XJH-Jorhai/automatic-curtain-lifter/hardware/mechanical/README.md

# 机械结构与打印

## 交付文件

| 文件 | 用途 |
|---|---|
| [盖子.STEP](盖子.STEP) | 盖子独立结构件 |
| [架子.STEP](架子.STEP) | 架子独立结构件 |
| [壳子.STEP](壳子.STEP) | 壳子独立结构件 |
| [enclosure.3mf](enclosure.3mf) | Bambu Studio 打印工程，包含零件、打印盘及示例配置 |

三个 STEP 由作者从 SolidWorks 2025 导出，格式为 AP214。原装配体存在严重引用丢失，因此本版采用独立结构件 STEP 与 3MF 交付，不提供完整参数化 SolidWorks 装配、配合关系或特征树。读者需要自行定位和装配；不能据此声称原装配已修复。

STEP 保持原始字节，未修改几何。已检查文件结束标记、实体编号及引用完整性，作者/组织字段为空，未检出邮箱、本机路径或已知私人标识。已用 Open CASCADE 8.0.1 独立导入并执行 BRepCheck，三个结构件均为有效实体且体积为正；装配配合和干涉未验证。详细结果见 [几何检查](geometry-check.json)。

## 已实际使用的打印参数

| 项目 | 作者样机配置 |
|---|---|
| 打印机 | Bambu Lab X1 Carbon |
| 喷嘴 | 0.4 mm |
| 材料 | Polymaker PLA Pro，黑色 |
| 层高 | 0.2 mm |
| 壁圈数 | 2 圈（不是 2 mm 壁厚） |
| 电机/外壳固定 | M2.5 / M3 普通碳钢或不锈钢螺钉 |
| 安装位置与固定 | 用纳米胶粘贴在窗框和墙面 |

螺钉按实际装配自行选配，不提供固定长度与逐位置采购清单；根据连接处厚度和可用螺纹深度选择，避免顶到底或干涉运动件。装配关系参照提供的结构件和 3MF，本版不另提供装配图或逐步装配说明。填充与支撑可从打印工程检查并按设备调整。上述粘贴方式是作者样机做法，胶带型号、接触面积及长期承载尚未量化验证。

3MF 来自作者确认的“零件5^main.3mf”。已清除设计者账户编号，仅保留 XJH-Jorhai 署名；除设计者元数据外，归档各成员、几何、组件变换与打印配置保持不变。原文件含 PLA/PETG/ABS 多种耗材配置，这不代表都已实测。打开后以本页实际参数核对并调整各零件耗材、层高、壁圈数及支撑，再按自己的设备重新切片。

珠链轮的 OpenSCAD 源码及上游许可见相邻参数化珠链轮目录。原创结构件的许可范围见 [LICENSING.md](../../LICENSING.md)。
