XJH-Jorhai/automatic-curtain-lifter/hardware/schematic-review/README.md

# Curtain Lifter 主板首版原理图审阅

2026-10-13 新增独立[调试板 TPS61023 升压电路记录](debug-board-tps61023.md)：在工程中的 `调试板 / Schematic3 / P1` 补齐 3.3V→5V 的电感、反馈与滤波外围，输出 `5V_DEBUG` 留给后续调试器接口。该记录与下方主板四页网表分开。

2026-10-11 当前复核：用户已移除 PA1 12 V 电压检测，使用 U6 双向复位钮子开关与独立 SW1 配网键，并将调试/扩展接口改成 GH1.25。本轮将 CN1.8 从重复 GND 改为 `TUYA_CEN`，供涂鸦烧录复位。以[当前 V3 网表](Curtain_Lifter_Mainboard_v3.enet)及主控页当前截图（历史附件未随公开候选提供）为准；`*_TRQonly.png` 与 `*_TRQonly_v3.epro` 是历史快照。

[原理图设计连续问答](design-qa.md)保存解释方法、用户问题、版本证据及待验证项。2026-10-09 用户已从 V3 电源输入页移除防反接 MOS 及外围，并更换 DC 插座；U4 已从 FRAM 改为 EEPROM。以下旧版图片仅用于查看之前的布线布局，器件和网表以当前 V3 工程及[最新网表](Curtain_Lifter_Mainboard_v3.enet)为准。

开始 PCB 绘制前的逐页 DRC、网表及布局注意项见[2026-10-11 投板前审查](pre-pcb-review-2026-10-11.md)。

V3 工程 `涂鸦智能家居产品-窗帘开关`（UUID `d8963714934544559fd468e3e2743100`）中主板为 `Curtain_Lifter_Mainboard_RevA`，原理图为 `Curtain_Lifter_Mainboard`，现有四页；原有 `Board1` 保留。下方 `*_TRQonly.png` 图片是 2026-10-10 从当时 V3 桌面窗口抓取的历史图面；电气连接以 V3 工程及[最新网表](Curtain_Lifter_Mainboard_v3.enet)为准。按用户决定移除了新增的第五页 HX711/应变桥电路。

此前的原生 V3 工程快照（历史附件未随公开候选提供）已导出，包含当时四页主板原理图和工程中原有的 `Board1`。本次改动请以打开中的 V3 工程、[当前网表](Curtain_Lifter_Mainboard_v3.enet)和当日主控页截图（历史附件未随公开候选提供）为准。

本轮按实体导线重画了局部辅助电路。可与改线前的电源页（历史附件未随公开候选提供）、驱动页（历史附件未随公开候选提供）、主控页（历史附件未随公开候选提供）、本地操作页（历史附件未随公开候选提供）逐页对比。布局参考 [TI DRV8434A 应用电路](https://www.ti.com/lit/ds/symlink/drv8434a.pdf)与 [ST STM32G0 硬件设计说明](https://www.st.com/resource/en/application_note/dm00443870-getting-started-with-stm32g0-series-hardware-development-stmicroelectronics.pdf)。

编辑器中的红色导线来自“已选中”高亮，并无特殊电气含义。本版已清除遗留选中状态；以下截图中的导线统一为默认绿色，器件引脚与轮廓沿用库符号的红色。将按键上拉、MCU 复位上拉和驱动器下拉改为器件旁的短电源或地接线，并将适合横排的网络名调整为横排。

## 01 电源输入

!当前 V3：12 V 输入、保护和 3.3 V 降压（历史附件未随公开候选提供）

当前 V3 使用 DC1 [`DC-050-A250`](https://jlcpcb.com/partdetail/XUNPU-DC_050A250/C41429013)（讯普，C41429013，SMD 卧贴）；内径 2.5 mm、外径 6.4 mm，[原厂图纸](https://item.szlcsc.com/datasheet/DC-050-A250/43280632.html)额定 DC 24 V、3 A。商城参数表的 12 V、1 A 与原厂图纸冲突，不能据此判定器件额定值。它**不是原定的 DC5521（5.5/2.1 mm）**，采购适配器插头时须按新接口尺寸核实。当前路径为 `DC1.5 → F1 → 12V_PROT`，D1 SMBJ15A TVS 从 F1 后端接 GND；Q1/R3/D3 防反接支路、0.1 Ω 串联采样电阻和旧 J1 已移除。12 V 转 3.3 V 同步降压保留。TP1/TP2 分别测主电源和 3.3 V。用户决定首版保留两颗常亮电源 LED 便于调试：`12V_PROT → R3(10 kΩ) → LED1 → GND` 与 `3V3 → R19(2 kΩ) → LED2 → GND`；其耗电必须计入静息功耗。旧局部放大图（历史附件未随公开候选提供）仅作历史对比，不能作为当前 BOM/接线依据。

原厂图纸已存为本地 PDF（历史附件未随公开候选提供），整页预览（历史附件未随公开候选提供）可直接查看图纸右下角型号与左下角额定值。

## 02 步进电机驱动

!当前 V3：DRV8434A 与四线电机接口（历史附件未随公开候选提供）

查看驱动器与外围的放大图（历史附件未随公开候选提供）。

DRV8434A 裸芯片、VM/电荷泵/DVDD 去耦、STEP/DIR/ENABLE/nSLEEP/nFAULT 与 TRQ_CNT 信号、可切换 VREF 档位。VM 电容、充电泵电容、VREF 分压与 CJ3400 切换 MOS、电机四线均直接接入芯片。J2 是 4 位 5.08 mm 可插拔接线端子，[商城资料](https://jlcpcb.com/partdetail/DLL-2EDG_5_084ALS/C22397895)给出的适用线规为 AWG 14–28，连接 A1/A2/B2/B1 四根电机线。[雷赛原厂资料](https://www.leadshine.com/upfiles/downloads/bdf68744e5a8e2ca16db245f589f2c5c_1722494176103.pdf)确认 42CM02-1A 为 1 A/相；实际随货线规和线端处理仍需实物复核。

## 03 主控与烧录

!2026-10-11 V3：STM32G030、GH1.25 调试口、双向开关与配网键（历史附件未随公开候选提供）

查看 MCU 与局部电路的放大图（历史附件未随公开候选提供）。

STM32G030C8T6、U4 `AT24C16C-SSHM-T`（Microchip，C6480，16 Kbit I²C EEPROM）、U6 双向复位钮子开关、SW1 独立配网键及 U7 通用反馈扩展。PA1 的 12 V 分压检测已删除；PA0 仍读取驱动 `TRQ_CNT`。PB13/PB14/PB15 保持未使用。U4 的 4/5/6/7/8 脚分别接 GND/SDA/SCL/GND/3V3，10 kΩ I²C 上拉与 100 nF 去耦保留。U6 的 2 脚接 GND，3 脚接 `KEY_UP`→PC6，1 脚接 `KEY_DOWN`→PC7；两路分别以 10 kΩ 上拉到 3V3、100 nF 对地。U6 具体料号为[源丰 MT-0-123-D001-D000-LF，立创 C22448935](https://item.szlcsc.com/24110724.html)；1-2/2-3 导通对应的实体拨向装板后由软件映射。SW1 `NETCONTROL_BTN` 接 PC13。CN1 为 GH1.25 8P，U7 为 GH1.25 4P；[CN1 逐脚说明与涂鸦烧录桥接方案](tuya-programming-bridge.md)记录了 CN1.8 新增 `TUYA_CEN` 的用途。

## 04 无线与本地操作

!2026-10-10 历史快照：T1-3S、三个按键与状态 LED（历史附件未随公开候选提供）

当前无线页保留 T1-3S UART 和一颗 GPIO 控制的状态 LED；方向开关与独立 SW1 配网键在主控页。上图仍展示旧三个轻触按键，仅供比较原布局，不能作为当前连接依据。原独立 STOP 键已删除，配网使用 `NETCONTROL_BTN`；恢复出厂的软件长按时序尚待定义。TP3/TP4 分别引出模组 RST/CEN，CEN 另引至 CN1.8。

## 自主校准信号

首版只用驱动器 `TRQ_CNT/STL_TH` 经 G030 PA0 采集运动负载信号。HX711、四线应变桥接口、专用 PMOS 电源开关及其第五页均已删除；当前 U7 通用扩展口仍在。上端触顶和下端反卷能否稳定区分，需要在真实卷帘上采集波形与独立位置基准后判断，见[校准硬件记录](calibration-revA.md)。当日主控页图面已完成实际画面检查；编辑器内部截图接口全黑，故改用 Windows 窗口抓取。

## 核对与待定项

- [器件与阻容归并审查](BOM-review.md)列出实际改动、保留的专用参数及料号。10µF 均为 0805，普通阻容优先 0603。当前电路没有肖特基，故没有加入 B16WS。
- 2026-10-11 [V3 整板网表](Curtain_Lifter_Mainboard_v3.enet)为 66 个带位号器件；PA1 无网络，旧 12 V 采样电路不在当前网表。位号曾在用户修改后重排，不能按历史位号判断器件是否仍实装。
- U6 两路在网表中分别接 PC6/PC7，SW1 `NETCONTROL_BTN` 接 PC13。U6 1-2 与 2-3 的物理拨向装板后再确定，软件映射即可。松手回中位应只停止本次本地运动，不能持续覆盖 App 命令。自动校准若由本地开关触发，须在固件中处理松手停止与自主校准之间的交互。
- LED1/LED2 通电持续发光是用户决定保留的首版调试功能；两灯静息功耗仍须实测。
- CN1.8 已接 `TUYA_CEN`，CN1.2 和固定脚仍接 GND；经 G030 透传烧录尚需专用固件和实物烧录工具验证。2026-10-11 重新打开并逐页运行 V3 严格原理图 DRC，四页均返回空结果（0 条错误、0 条警告）；先前一次显示的 1 条警告未在重新检查后复现。PB13/PB14/PB15 已标为 NC，TRQ_CNT 网表连接已复核。
- MCU GPIO 分配、VREF 电流档位、保险丝/TVS/降压外围参数、DC1 的插头尺寸与接触温升、电机实物线规是首板投板前的复核项。DC1 原厂图纸额定 DC 24 V、3 A。U7 保留为通用扩展口。R8 的 10 kΩ ENABLE 下拉使 8 倍扭矩计数缩放暂不可用，是否调整取决于低速信号实测。
- 2026-10-09 已将 V2.2 本地恢复快照（历史附件未随公开候选提供）中的主板单独导入 V3.2.149 工程；单板 EPRO（历史附件未随公开候选提供）仅为迁移历史。后续用户在 V3 修改电源输入和 DC 插座，本轮替换 U4；此后以 V3 工程中的主板为编辑对象。
