XJH-Jorhai/automatic-curtain-lifter/docs/images/README.md

# 项目配图

- `prototype-installed.jpg`：XJH-Jorhai 提供的安装样机实拍，3024 × 3024。
- `mainboard-render.png`：XJH-Jorhai 提供的 PCB 正面渲染，1162 × 1335；非实板照片，部分器件可能没有三维模型。

两图保留原始画面，发布处理仅清理元数据，不改变解码后的 RGB 像素。原创照片和配图按本项目文档的 CC-BY-4.0 范围提供；画面中的第三方商标、库模型等仍归各自权利人，不授予商标或第三方模型的额外权利。引用时署名 XJH-Jorhai，并区分实拍和渲染。
