XJH-Jorhai/automatic-curtain-lifter/firmware/g030_mainboard/README.md

# STM32G030C8T6 产品固件

**2026-10-25 v15：** 取消边界外4799微步微调运动配额，保持钮子持续点动、松开立即停，不进入1秒自动；越界后反向调回范围也保持手动。正常端点/App定位、实际堵转和故障保护、LW9与原参数不变。完整回归通过，[部署记录](../../hardware/test-records/2026-10-25-product-v15.md)。下方v14及更早为历史。

**2026-10-25 v14：** 保存用户中间上端距物理顶的偏移，LW9重启找顶后按原校准范围定位；旧LW8手动记录需明确一次原端点并学习参考。校准按钮true确认后300ms自动false、再隔1200ms补报，重连也复位。完整回归、烧录及[重启实物验收](../../hardware/test-records/2026-10-25-product-v14.md)通过：126113跨度/40827偏移恢复后百分比和原端点正常，按钮自动复位正常。用户后续微调最新保存为199275跨度/2950偏移/LW9序号12，零错误。下方v13及更早为历史记录。

**2026-10-25 v13新面板：** DP2为目标、DP101为独立进度，102/103 rw Bool用于明确保存当前位置为上/下端并复位false。校准先停机、取消后续动作，沿用LW8事件保存与回读验证；实体配网键的方向/三圈微调规则保留。见[当前产品说明](PRODUCT.md)及[v13部署与验收](../../hardware/test-records/2026-10-25-product-v13.md)。下方v12及更早为历史行为。

**v13实物验收通过：** 用户确认目标/进度独立、定位/停止，以及两个App保存按钮和校准后自动到点正常。两次云端校准均成功，EEPROM事件保存2次/错误0，当前行程126113微步、manual3/saved1，上下均按已存脉冲数停止。

**2026-10-25 v12进度显示：** 用户已确认v11 App开停关及61%/27%实际定位正常，当前修复共用百分比滑条显示：DP2下发为目标，DP2与DP101上报为当前位置，每500 ms同步，目标保留在内部规划中。运动、钮子、校准、电流、速度和B1不变；完整回归与构建通过，见[v12部署记录](../../hardware/test-records/2026-10-25-product-v12.md)。

**本轮实物验收完成：** 用户确认v12“进度跟随且定位正常”；钮子自动升降/反向、App开停关及百分比定位/反馈均通过。验收后云端在线，保存行程202363微步、manual3/saved1，UART及存储错误0，App操作无新增EEPROM保存。

**2026-10-25 v11：** 钮子持续1秒后自动到点，反向立即停、保持1秒开始反转，再计1秒进入自动。涂鸦开停关与百分比共用产品运动规划，DP1/2/101同步；重启后的云端定位先找顶恢复参考。原手动校准已验收并核对保存：196823微步、PC7为上、LW8序号6、两端手动标志、零存储错误。完整回归与构建通过，见[当前产品说明](PRODUCT.md)及[v11部署记录](../../hardware/test-records/2026-10-25-product-v11.md)。

**2026-10-25 v10手动校准：** PC13短按按最近本地钮子方向记上/下端，距相反端点不足三圈时按微调修正；长按5秒配网保留。可信坐标下按已存端点步数停止，端点同向重新拨动允许最多4799微步微调。兼容旧v7，明确校准事件写入含手动来源的v8，不修改涂鸦数据点。完整回归和构建已通过，部署进度见[v10记录](../../hardware/test-records/2026-10-25-product-v10.md)。以下v9及更早记录为历史。

**2026-10-25 当前为产品v9：** 用户选择采用本机已确认DIR0上卷、恢复EEPROM和App工作流程。上下360 rpm/原约1.50 A及v8已实测的滤波判据不变；首次触点定义上并先保存后运行，端点/行程按事件写LW v7。编译、烧录、完整读回、实板上下端学习及软件重启恢复均已通过；当前保存PC7为上、239993微步行程。重启后先到真实端点对齐当前位置。见[当前产品说明](PRODUCT.md)及[v9部署](../../hardware/test-records/2026-10-25-product-v9.md)。以下v8及更早条目为历史记录。

**2026-10-25 v8固定电流滤波采样版已部署：** 原约1.50 A/360 rpm已取得真实上下端TRQ对照。新增5点中位数和50%相对门槛后，用户确认上端停止从约1秒缩短至0.1–0.2秒，下端反卷后也很快自动停；RAM记录吻合，行程估计250585微步。速度、电流及B1不变，自动停机采样经后续短拨仍保留。EEPROM仍只读，方向人工确认，通用自动识别尚未验证。见[采样版说明](TRQ_CAPTURE.md)及[v8现场记录](../../hardware/test-records/2026-10-25-trq-filter-v8.md)。默认 `Product` 构建仍为未验证的v6分段电流实现。

**2026-10-24 v2：** 首次稳定拨动定义“上”触点，800rpm识别成功立即保存方向和触点，不等待全行程；未完成松手则下次重试。工作模式上行360rpm、下行800rpm，按用户操作在失速处记录上下边界。开机B1音量试听改为约1.50 A、正反各5微步，目标7/10待听音确认。见[当前产品说明](PRODUCT.md)及[v2烧录记录](../../hardware/test-records/2026-10-24-workmode-v2.md)。以下当天较早记录为历史设置。

**Codex 烧录显示：** `flash.ps1` / `flash_bounded.py` 现在按需弹出极简烧录进度浮条，可展开详细阶段与日志；成功后自动退出，平时不驻留。进度来自 pyOCD API 和分块读回校验。Codex 的查询/展开/关闭接口及无硬件演示见 [`tools/flash_monitor`](../../tools/flash_monitor/README.md)。

**2026-10-24恢复开机旋律：** Product已接回原EEPROM的B1旋律，沿用低电流、正反各3微步，每次开机播放一次，按键/停止/升降优先。800rpm、单向1.5秒等全部升降参数保持原值；见 [本次烧录与播放验证](../../hardware/test-records/2026-10-24-probe800-music.md)。

**2026-10-24：** 用户观察720rpm已出现丢步，当前Product方向试探提高至800rpm，单向上限缩短至1.5秒（含1秒加速、150 ms稳定等待），失速确认后提前停止。找底、正常下放分别独立配置且保持360rpm，上卷/归零保持100rpm。机械已接入，用户负责观察实际运行；见 [本次修改与烧录记录](../../hardware/test-records/2026-10-24-probe800.md)。

**2026-10-22：** 默认 `build.ps1` / `flash.ps1` 切为Product，包含本地升降、App控制、1–99%未知位置进度、360 rpm方向试探及上下边界标定。该日镜像未链接测试动作、启动音乐或SWD测试注入；当前行为见 [PRODUCT.md](PRODUCT.md)，该日部署状态见 [产品固件记录](../../hardware/test-records/2026-10-22-product.md)。

以下为 v8 及 2026-10-21 的历史说明；其中“未实现端点”“不回报百分比”“2秒限时”等不适用于 Product。

**最新实板状态（2026-10-21）：** 涂鸦模组已由用户烧录授权成功；STM32已部署独立[TuyaApp协议验证固件](TUYA_APP.md)，模组侧9600、COM3日志侧115200，PC13长按5秒进入AP配网，电机保持禁用。JSON协议与按键逻辑实板隔离测试通过，真实按钮与App联调待完成。以下v8电机及透明桥段落为其他构建/历史记录。

对象：Curtain_Lifter_Mainboard_RevA。旧开发板工程 `../g030_tuya/` 保留独立。引脚以 [PINOUT.md](PINOUT.md) 为准；普通电机固件仍跳过USART1及配网。2026-10-21新增独立 [TuyaBridge烧录桥接构建](TUYA_BRIDGE.md)，固定115200双向直通，已部署并完成Flash回读和16字节正向转发检查，YOUR_SERIAL_PORT已释放；主板模组烧录与授权待用户操作。

## 当前行为

已移除500ms诊断等待，保留2ms唤醒及1ms使能准备时间。正常运动改用TIM14定时器，目标2667脉冲/秒（按1.8°、1/8细分为100rpm）。
普通点动停止已改为仅关闭绕组输出、保留驱动索引相位（ENABLE=0、
nSLEEP=1）；故障仍休眠。完整行程后的重复启动已观察到改善，首次励磁和任意中断后不保证无抖动。

本地钮子开关按住运行：上位方向A、下位方向B，松手回中位立即停止，
取消本地400微步限制；单次最长30秒，保护停止后必须回中位才能再次启动。见 [LOCAL_SWITCH.md](LOCAL_SWITCH.md)。

初始化音效已选定为B1（232 BPM，约1.18秒），按需保存至EEPROM后在启动时播放一次；
斗地主保留为人工测试曲。乐谱定义见 `App/music_scores.h`，试听与存储说明见 [MOTOR_MUSIC.md](MOTOR_MUSIC.md)。

- HSI16；USART2 PA2/PA3，115200 8N1，256字节中断接收缓冲，逐条命令/应答。
- 已烧录的三微步版默认关闭周期串口心跳，仅保留启动消息与按需应答；`HB ON`临时开启每秒心跳，`HB OFF`关闭，复位恢复关闭。该开关只控制日志，不影响电机安全服务或EEPROM策略。
- 初始化期间保持驱动禁用/休眠；初始化完成后按用户要求播放EEPROM中的乐谱一次。软件复位也会触发一次；乐谱无效或读取失败时保持不动作，不重试。普通点动仍须显式请求。
- 本地按住持续运行，最长30秒；从50脉冲/秒在1000ms内渐进升到2667脉冲/秒，正常运行档约1.50A满量程。TIM14中断执行脉冲，SysTick服务开关与停止，不依赖串口主循环及时返回。
- nFAULT低、总超时或主循环250 ms未服务时停止；故障后须STOP清除状态，不自动重启。
- PA4高选择低电流档，依据R4=56k、R5=21k、R6=10k、VREF内部典型500kΩ下拉和DVDD典型5 V估算满量程约0.40 A；此处不是实测绕组电流。
- 未实现带执行器的运动规划、端点识别、位置控制；不把步数计数当实际位置。SysTick方案不能保护全局关中断/核心被调试器暂停等情形，尚未引入独立看门狗。
- PA0/PB10、VREFINT和内部温度ADC已启用。休眠TRQ及浮空扩展输入不作有效负载测量；板上无12 V分压检测ADC。

## EEPROM寿命保护

**EEPROM必须按需读写，禁止任何定时、周期、循环扫描或重复周期读写。** 已删除后台读取服务及其主循环调用。新增的启动播放事件只加载一次双槽，不写入；其他访问仅来自明确的业务或诊断事件。`music.h` 提供保存乐谱、获取乐谱、播放及停止接口，详见 [MOTOR_MUSIC.md](MOTOR_MUSIC.md)。加载后使用RAM缓存；相同乐谱重复保存零I2C访问。

没有擦除/填充/全片写入API，串口原始`EE W`入口已关闭，旧主机全片写读恢复功能已移除。即使读操作不消耗编程寿命，也不得因此恢复周期读取。

单页更新接口`Eeprom_Update`及乐谱专用`Eeprom_WriteScoreSlot`均仅按需调用：

- 单次1–16字节且必须在同一物理页；拒绝跨页、越界及大块请求。
- 先比较，相同数据直接成功，不发编程事务；不同数据仅发送首尾差异范围。
- 全局60秒逻辑保存冷却，每次上电最多8次尝试，失败/不确定的写入也计入预算，不自动重试。乐谱专用接口一次最多14个物理页写，限定在0x000/0x100的双槽，最后提交校验头；单页接口仍限制1–16字节。
- ACK轮询结束后回读校验。计数在RAM，不能作为跨复位寿命账本；未来高频位置存储需独立的CRC/序号、多槽轮转和掉电一致性设计。

`EE TEST`同时运行RAM模拟I2C后端策略测试和实片同值更新检查。模拟测试复用生产实现，覆盖全片/跨页/越界拒绝、同值跳过、60秒冷却、tick回绕、失败计入预算和8次上限；它不会向实片写入图案。

## 串口命令

音乐模式已改为**每个微步自动正反交替**，正常每音结束完成正反一对；支持直接输入`c4f4g4`。
先用`CHECK c4f4g4`无动作检查，`PLAY c4f4g4`或直接音符文本播放一次，`STOP`随时停止。
详见[音符语法、正反策略及硬件细分限制](MOTOR_MUSIC.md)。M0/M1硬接DVDD，软件不能关闭1/8细分/切到整步。

| 命令 | 行为 |
|---|---|
| `PING <标记>` / `UART` | 回显 / UART错误、缓冲溢出计数 |
| `LED ON` / `LED OFF` | LED GPIO控制及ODR/IDR回读 |
| `INPUTS` / `ADC` | 静态输入 / 四路模拟采样，外部值未标定 |
| `EE SCAN` / `EE R <地址>` | 八个地址块ACK / 读取16字节 |
| `EE STATUS` | RAM中的读取事务、探测、错误、写入统计；查询不访问EEPROM |
| `EE TEST` | 无物理写入的策略自测 |
| `MOTOR STATUS` | phase、命令步数、停止原因、方向及控制脚IDR |
| `MOTOR TUNE` | 保留的第一乐句，使用自动正反交替 |
| `CHECK <音符>` / `TUNE TEST` | 仅解析 / 无运动自测 |
| `PLAY <音符>` / 直接`c4f4g4` | 单次播放，支持节拍、时值、升降号及休止符 |
| `MOTOR RUN F` / `MOTOR RUN R` | 固定400步、50→2667Hz渐进启动、约1.50A满量程、约0.54秒限步诊断；不得连接执行器测试 |
| `STOP` | 立即禁用、休眠、STEP/DIR/电流选择回低 |
| `MOTOR TEST` / `MOTOR IO` | 内存逻辑自测 / 禁用时STEP/DIR回读，不用于判断转子正常 |

运行中只接受STOP、STATUS、ADC、INPUTS、EE STATUS及PING/UART，不接受新运动和维护操作。
phase：0空闲、1唤醒、2使能等待、3运行、4故障。reason：0启动/无结束、1完成、2故障、3总超时、4显式停止、5主循环超时。

## 构建与验证

```powershell
cd [LOCAL_PATH]
.\generate.ps1
.\build.ps1
.\flash.ps1
```

CubeMX `-q`通过本机Java运行，固件包在`work/cubemx-home`。应用代码在`App/`，中断调用置于USER CODE区域；`.ioc`为外设配置源。产物在`work/g030-mainboard-build/Debug`。

Python需使用已安装pyserial/pyOCD的解释器，当前本机依赖为`work/pyocd-deps`：

```powershell
$env:PYTHONPATH = '[LOCAL_PATH]
python .\basic_check.py --port YOUR_SERIAL_PORT
python .\motor_bench.py --port YOUR_SERIAL_PORT --eeprom-baseline ..\..\hardware\test-records\2026-10-20-eeprom-before-basic-test.bin
# 仅空载且明确要动作时添加 --run-motor；会正反向各动作一次。
```

默认`motor_bench.py`不启动电机，显式检查EEPROM基线和保护策略，等待15秒并确认无后台访问。新增`eeprom_idle_check.py --port YOUR_SERIAL_PORT`应在复位后运行，验证启动/空闲零访问、一次请求只读一次、无后续重复访问。打开无线串口后等待0.5秒。`verify_flash.py`使用64字节分块SWD回读镜像及安全GPIO，须在运动结束后运行。`flash.ps1`按扇区烧录MCU Flash，不涉及外部EEPROM，也不修改选项字节。

v4实测见[按需读写记录](../../hardware/test-records/2026-10-20-eeprom-on-demand.md)。此前循环读取方案已撤销。

电机结论：[空载试转与EEPROM保护记录](../../hardware/test-records/2026-10-20-mainboard-motor-eeprom.md)。正反向控制流程完成且未报告电气故障，但模拟量不足以确认转子实际转动正常，等待现场观察。历史：[v2基本外设](../../hardware/test-records/2026-10-20-mainboard-basic-functions.md)、[v1串口](../../hardware/test-records/2026-10-20-mainboard-uart-bringup.md)。

2026-10-21实装电机用户铭牌信息：1.8°、1.5A；保持转矩读数0.21（单位/型号待补）。
正常运动PA4低，估算约1.50A满量程；音乐PA4高，约0.42A。两者不是整板输入电流。
旧候选42CM02-1A的4.5Ω/6.5mH不能当作此实装电机参数或输入功耗依据。

当前阶段结论与后续计划见[2026-10-21负载实验汇总](../../hardware/test-records/2026-10-21-motor-load-summary.md)：9槽轮120rpm上卷偶尔失步，收尾设为100rpm/1秒加速；到位检测等待机械结构完成后继续。下降300/360rpm仅为后续候选，未部署或验证。

用户已现场确认100rpm收尾版本运行正常，当前版本保留；等待机械结构完成后继续到位检测。
