XJH-Jorhai/automatic-curtain-lifter/docs/01-requirements.md

# 需求与验收口径（v0.1）

## 功能需求

| 编号 | 需求 | 初步验收口径 |
|---|---|---|
| F-01 | 首版涂鸦接入；米家后续评估 | 首版通过 T1-3S 与涂鸦 App 控制窗帘；米家原生接入属于后续平台阶段 |
| F-02 | BLE 配网、Wi-Fi 常连 | 恢复出厂后通过 BLE 完成 2.4 GHz Wi-Fi 配网；重启后自动重连 |
| F-03 | 正转、反转、停止 | App 和本地钮子开关都可控制，任意来源的停止命令优先 |
| F-04 | 百分比控制与上报 | 可按1%步长设定0–100%；2026-10-22用户允许未知位置显示估算进度，初始50%、运动中限定1–99%，中途停止保留，不长期固定为0；建立行程与上端基准后按STEP比例估算位置。 |
| F-05 | 掉电保持 | 普通掉电不丢网络、行程、方向和最近一次安全停机位置；上电后位置先标为不可信，下次运动受控回零，不自动误动作 |
| F-06 | 本地控制 | 一只 MT-0-123 双向自动复位钮子开关，松手回中位停止本次本地运动；另设独立 `NETCONTROL_BTN` 配网键，无独立 STOP 键。U6 的 1-2 与 2-3 两种导通状态分别由 GPIO 识别；装板后按实物朝向决定上/下的软件映射。恢复出厂长按时序和防误触由固件确定 |
| F-07 | 自主校准与软件行程 | 2026-10-22 用户更新：未知行程收到升降或百分比请求后，先以360rpm比较两方向，把扭不动的一侧定为上卷；100rpm上卷找顶并归零，再360rpm下放至反卷失速事件，返回上端校验并保存行程，最后执行目标。检测失败不保存猜测行程。机械未接入，阈值与最低点偏移待验证；见产品固件说明。 |

## 电气需求

- 输入：标称 12 V DC、中心正极；保留 TVS 浪涌钳位与 PTC 过流保护，不设置防反接 MOS。当前 DC1 为 6.4/2.5 mm 插座，[讯普 DC-050-A250 原厂图纸](https://item.szlcsc.com/datasheet/DC-050-A250/43280632.html)额定 DC 24 V、3 A，覆盖此前 9–15 V 输入范围；与原 DC5521 不兼容，投板前须核实适配器插头尺寸和整机输入上限。
- 静息功耗：12 V 输入、Wi-Fi 已连接、电机输出关闭、状态灯熄灭时，平均功率 `<100 mW`，即输入平均电流 `<8.33 mA`。
- 电机运行功率不纳入静息功率，但需在确定电机后定义最大输入电流和电源规格。
- 首版保留 12 V 和 3.3 V 两颗常亮电源指示 LED，便于上电调试；另有一颗 GPIO 控制的工作状态 LED。静息功耗验收须计入两颗电源灯。
- 无网络时仍可使用本地钮子开关；网络恢复后同步最终状态。

## 位置精度的边界

电机的相对位置计数不能单独证明拉珠或帘布没有打滑。目标机构是竖向拉珠式卷帘：上端有机械限位，下端没有止动，越过最低点反卷时可能失速。拉珠超过一整圈，单颗黑珠不能提供全行程唯一位置。**设备之外不得改动窗帘或窗框，不加端点开关。** 当前按F-07的高速差异试方向、上端失速归零和下端反卷失速事件建立行程，并核对返回上端的计数。未知位置动画是用户允许的显示估算，不能当真实位置；已标定百分比表示STEP运动量区间的比例，真实帘布高度比例及下端事件偏移须实测。异常停止或断电后保留位置可信度区分，重启后运动先回零。电机类型按[选型决策](09-motor-drive-decision.md)确定。

## 尚待机械参数冻结

- 拉珠直径、节距和链轮齿数
- 窗帘最大重量、升降行程、所需扭矩与目标速度
- 电机尺寸、额定电压/电流、输出速度、减速比；若选步进，再确认相电流和线圈电阻/电感
- 允许噪声、外壳尺寸、安装方式和是否允许端点传感器
