XJH-Jorhai/automatic-curtain-lifter/hardware/schematic-review/pre-pcb-review-2026-10-11.md

# 首版主板 PCB 绘制前审查（2026-10-11）

对象：嘉立创EDA V3 工程 `涂鸦智能家居产品-窗帘开关` / `Curtain_Lifter_Mainboard_RevA` 的四页原理图及[当前网表](Curtain_Lifter_Mainboard_v3.enet)。本记录是开始 PCB 布局前的电气与器件检查；PCB 尚未绘制。

## 已核对

- 逐页重新打开 `01_Power_Input`、`02_Stepper_Driver`、`03_MCU_Control`、`04_Wireless_UI` 并运行严格原理图 DRC，四页均返回空结果（0 条错误、0 条警告）。此前单次显示的 1 条警告未复现。
- 当前网表为 66 个带位号器件；无重复位号，所有器件均有制造商料号、立创商品号和封装。
- 当前降压输出 C24–C27 为 22 µF、16 V、1206；旧版阻容归并表的“C5–C8 22 µF/0805”是历史位号与封装，不能用于当前 PCB 摆件。
- 12 V 路径：DC1 中心脚 5 → F1 → `12V_PROT`；D1 TVS 从保险丝后端接 GND。DC1 的 3/4 脚接 GND；无防反接和整机电流采样支路。
- 驱动与电机：DRV8434A 的 STEP/DIR、ENABLE、nSLEEP、nFAULT、`TRQ_CNT` 分别连 G030；J2 四个端子分别接两相绕组四线。ENABLE 和 nSLEEP 均有下拉，MCU 复位时驱动保持禁用/休眠。
- 本地输入：U6 的 1/2/3 脚分别为 `KEY_DOWN`/GND/`KEY_UP`，连接 PC7/地/PC6；SW1 常开触点 1/2 接地/`NETCONTROL_BTN`，PC13 有 10 kΩ 上拉和 100 nF 滤波。实体拨向由装板后软件映射；独立 STOP 已删除。
- 通信与调试：U5 T1-3S RX1/TX1 分别接 G030 PA9/PA10；CN1 GH1.25 8P 保留 SWD、MCU 复位和 PA2/PA3 调试串口，CN1.8 已接 `TUYA_CEN`。U7 GH1.25 4P 为通用反馈扩展。
- 首版保留 LED1/LED2 两颗电源指示 LED，LED3 由 PB12 控制。经 G030 串口透传给涂鸦烧录仍须固件与实板验证，见[接口说明](tuya-programming-bridge.md)。

## 开始 PCB 布局时要落实

1. DC1 的器件为 `DC-050-A250`，库封装名为 `DC-050-A200`。用户确认这两个型号估计共用板上封装；按 A250 的原厂 PCB 焊盘与定位孔图（历史附件未随公开候选提供）放置和复核，板边留足插头插拔空间。不能仅凭封装名称判断几何错误。
2. T1-3S 天线按模组规格书留净空；把降压 SW 节点、DRV8434A 电机输出和大电流回路远离天线。DRV8434A 暴露焊盘接地并按数据手册布散热铜与过孔；电源、相线、地回路宽度按实际电流和温升设计。
3. CN1/U7 GH1.25 的 1 脚方向、配套线束和外壳出线空间要与实物核对；J2 的电机线序也需按实物绕组测定，不凭线色接线。
4. 3.3 V 电源灯 LED2 与状态灯 LED3 都是蓝色 `XL-1608UBC-04`，各串 2 kΩ。该 LED 厂商数据手册在 20 mA 条件下给出正向压降 2.7–3.4 V；在 3.3 V 电源与 2 kΩ 限流下，亮度未由该额定测试条件保证。PCB 可先按现有封装布局，首板焊接时实测可见性；若希望调试灯在所有批次都明显可见，投板前改低正向压降 LED 或重新计算限流电阻。见[厂商数据手册](https://mm.digikey.com/Volume0/opasdata/d220001/medias/docus/8903/XL-1608UBC-04.pdf)。

结论：**可以开始 PCB 绘制**。上述 1–3 是布局与机械核对事项；第 4 项是首版指示灯亮度风险。原理图 DRC 清零不代表 PCB 已通过 DRC，投板前还需检查封装焊盘、板边、散热、天线净空和实际线束方向。
