XJH-Jorhai/automatic-curtain-lifter/docs/publication-draft.md

# 用 STM32 和步进电机制作自动窗帘抬升器

> 发表稿草案，基于 2026-10-25 Product v15。仓库与配图已公开，发布范围以实际交付文件为准。

这个项目面向拉珠式卷帘：用步进电机带动珠链，在保留本地操作的同时，通过涂鸦 App 完成开、停、关和百分比定位。当前样机采用自制 STM32G030C8T6 主板、DRV8434A 驱动、T1-3S 无线模组和 9 槽打印珠链轮。

安装样机实拍

*作者样机实拍：安装在窗帘珠链旁的电机与打印外壳。*

项目：[GitHub 仓库](https://github.com/XJH-Jorhai/automatic-curtain-lifter)；许可范围见 [LICENSING.md](../LICENSING.md)。

## 从“能转”到“能用”

驱动电机转动只是第一步。日常使用还需要处理点动和自动运行、反向操作、用户自行设置上下端点，以及断电后如何重新知道窗帘位置。

本地采用双向自动复位钮子：短拨是点动，保持 1 秒后可以松手自动运行；运动中反向先停止，持续保持才反转。到保存端点后，回中位再同向拨动进入微调，按住运行、松手停止。另一个按键同时承担短按校准和长按配网，App 则提供含义明确的“保存上端/下端”按钮。

## 硬件如何配合软件

主板 PCB 渲染图

*主板正面渲染，非实板照片；器件与阻值以实装 BOM 和修改单为准。*

12 V 输入供给电机驱动，同时由降压电路产生 3.3 V。STM32 负责 STEP/DIR、按键、EEPROM 和位置状态，T1-3S 处理网络连接。DRV8434A 的 TRQ_CNT 接到 ADC，提供与负载相关的信号；它不是编码器，也不是直接测得的绕组电流。

机械部分从参数化珠链轮改作，按本机珠径、珠心距和 D 轴调整为 9 槽。打印间隙、绳槽和紧定结构需要配合实际链条校正。原模型来源与许可单独列明，避免把第三方设计当作全部原创。

## 端点检测与位置参考

当前固件对 TRQ 使用 5 点中位数和持续低值确认，降低瞬时波动导致误停的机会。已有行程时主要按指令脉冲停到目标；真实失步或故障会让位置失去可信状态。不同卷帘的下端反卷特性差异很大，因此同时提供手动端点校准。

一个实际遇到的问题是：用户设定的上端可能在真实物理顶以下。如果重启后把物理顶直接当作用户上端，整条行程就会偏移。因此当前版本分别保存校准跨度和“物理顶到用户上端”的偏移。重启后的首次 App 定位先找物理顶，再进入原校准范围。

这也解释了首次点“关闭”时可能先向上走：设备正在恢复参考。开机本身不会自动找顶，STOP 可以取消该流程。没有编码器时，不能把 EEPROM 中保存的校准直接当作上电后的真实位置。

## 保存策略与通信

校准使用 EEPROM 双槽日志与 CRC 校验，明确事件才写入，并在写后回读。普通运动和进度上报不周期写入，既减少无意义访问，也让失败处理更清楚。

App 将目标和进度分开：DP2 表示请求目标，DP101 表示实际/估计进度；DP102/103 用于保存两个端点。按钮自动回弹只代表事件复位，不能冒充存储成功。

## 当前进展

Product v15 已有主机回归、完整 Flash 读回和用户实物验收记录，本地、App、校准与重启参考已形成完整流程。最近完成的改动是让边界外微调持续按住运行，同时保留松手停机和原故障保护。

当前仍是单机样机验证：长期温升、待机功耗、多负载寿命、最终制造资料和全新环境构建尚需补齐。实际联网平台是涂鸦，米家接入属于早期探索，没有完成正式接入。开源资料会明确区分当前实现、历史方案和未验证目标，方便读者复现和继续改进。

技术细节见[硬件实现](hardware-design.md)、[软件实现](software-design.md)、[构建使用](getting-started.md)及[验证记录索引](validation-status.md)。
