XJH-Jorhai/automatic-curtain-lifter/docs/release-checklist.md

# 发布状态与后续事项

2026-10-25 公开开发版，软件基线 Product v15。用户已授权审查后公开。源码和设计可供研究、复刻及继续完善；不宣称第三方云服务开源或完整复制无需外部依赖。

## 本次完成

- 自有软件 MIT、原创硬件 CERN-OHL-P-2.0、文档 CC-BY-4.0；第三方声明保留，珠链轮补齐 GPL 全文与版本处理说明。
- 构建参数化、显式探针编号、SDK 独立回归与 CI；Product 清洁构建及完整主机回归通过（使用合法外部 SDK）。
- 电气 EPRO、网表、BOM、Gerber/钻孔、贴装资料及可读原理图 PDF/SVG；已有主板和四页原理图零项规则检查记录。
- 实装 BOM 和修改单明确 R4=30 kΩ、R5=21 kΩ、R6=4.7 kΩ；板材 FR4、2 层、1.6 mm、1 oz。
- 三个结构件 STEP 通过独立 CAD 实体有效性检查；3MF 账户元数据已清除，几何和配置保持。
- 记录打印材料/设备/层高/壁数及安装方式；螺钉自行选配，不另提供装配图。
- 隐私内容筛选、文件清单及本地链接检查。旧库保留私有，公开库仅上传清理后的历史。

## 已披露限制与后续维护

- 原生 EDA 工程和图面仍含旧 R4/R6 阻值：必须按实装 BOM 与修改单采购。后续可同步器件库和工程，当前不能一键按原始 BOM 下单贴片。
- 原 SolidWorks 装配引用损坏，交付独立 STEP/3MF；未验证整机装配干涉。
- 兼容涂鸦 SDK 需用自己的账户取得；第二账户完整生成、构建与云端联调未完成。不分发作者产品的 SDK、授权包或固件二进制。
- 已补作者提供的安装样机实拍和 PCB 渲染图，并明确区分两者；图片未改变画面内容。
- 长期温升、功耗、寿命、多负载适配与粘贴承载未完成量化验收。首次 App 定位可能先找顶，详见使用说明。

本次先公开仓库，不将上述未验证事项标为通过，不额外发布“稳定版”固件 Release。

涂鸦设计方法已公开：[接入指南](tuya-design-guide.md)。模组固件、授权包不属于发布内容，不作为待补附件；第二账户实测复现仍是独立验证事项。
