XJH-Jorhai/automatic-curtain-lifter/docs/09-motor-drive-decision.md

# 电机与驱动选型决策（草案 v0.3）

## 当前结论

卷帘实物上端有机械限位，下端无止动但反卷时有顿挫；拉珠运动超过一圈。**步进电机是首选路线**：用户更重视中途位置的步数控制，并倾向避免有刷电机的电刷寿命与噪声问题。直流减速电机保留为备选，只在步进路线的扭矩、噪声、回零检测、静息保持或整套成本不满足要求时重新比较。下文已有首轮 42 步进样机候选，但量产型号未冻结，也不预设其单件或整套成本必然更低。见[位置设计基线](08-motion-safety-design.md)。

上端回零用于在失步、异常掉电或长期累计误差后重建位置基准；正常中途位置主要由 STEP 计数估算，软件下端按自动测得并保存的行程停止。回零不必每次上电自动执行，但位置不可信时不能把旧百分比当作真实位置。上端检测和接触力仍须在真实机构验证。

用户已提供首轮拉力和位移数据：最大拉力计读数 0.75–0.85 kgf，约 7.35–8.34 N；拉珠直径约 4 mm、珠距约 6 mm；链轮按拉珠中心量得直径约 7 mm；局部 20 cm 拉珠移动对应约 5.5 cm 帘布移动，帘布全行程约 2.5 m。链轮扭矩首轮估算为 0.0257–0.0292 N·m，测量和链轮几何限制见[拉珠实测与负载估算](10-curtain-measurement-estimate.md)。

## 首轮样机电机和 PCB 驱动芯片

用户要求 42 步进，并按所测负载留约 2–3 倍余量。以估算上沿 0.0292 N·m 计算，**链轮端目标运行扭矩为至少 0.058–0.088 N·m**，取约 0.09 N·m 作为初版目标。该余量应用在目标速度下的**运行扭矩**，不能用静止保持扭矩直接代替。首版按电机直驱同轴链轮考虑；若增加减速/增速机构，重新按效率和传动比核算。

| 项目 | 首轮候选 | 来源与边界 |
|---|---|---|
| 42 mm 两相步进电机 | **雷赛 42CM02-1A**；42 mm 机座、33 mm 机身、1.8°、1 A/相、约 0.2 N·m 保持扭矩，4.5 Ω/相、6.5 mH/相 | [雷赛原厂型录](https://www.leisaishop.com/uploadfiles/2502131406_96059.pdf)。保持扭矩约为负载估算上沿的 6.8 倍，但尚无本项目 12 V、电流设置和目标速度下的运行扭矩实测；**未核实立创商城有该电机的商品号或现货**。 |
| 两相步进驱动裸芯片 | **TI DRV8434ARGER，立创商城 C2866434**；VQFN-24-EP 4×4 mm，4.5–48 V VM、2.5 A 满量程、STEP/DIR、集成电流检测、GPIO 失速检测、nSLEEP | [立创商城中国站商品页](https://item.szlcsc.com/3071111.html)、[TI 官方参数](https://www.ti.com/product/DRV8434A)。为 PCB 贴装芯片，**不是成品驱动板**。2.5 A 是器件上限，约为候选电机 1 A 相电流的 2.5 倍，不应把电流设成 2.5 A；实际连续能力还受 PCB 散热限制。 |
| 驱动备选裸芯片 | **TMC2209-LA-T，立创商城 C2150710**；QFN-28-EP 5×5 mm，4.75–29 V、最高 2 A RMS、STEP/DIR + UART、StallGuard4 | [立创商城中国站商品页](https://item.szlcsc.com/2242757.html)、[ADI 官方产品页](https://www.analog.com/cn/products/tmc2209.html)。静音可作为对照；需要 UART 配置与参数调试，电流额定值口径也与 DRV8434A 的满量程值不同，不能仅比较数字。 |

12 V 系统中，42CM02-1A 的额定绕组电压 `1 A × 4.5 Ω = 4.5 V`，应由驱动芯片斩波**限流至电机允许的相电流**，而不是把 12 V 直接加在绕组上。用 12 V 供电能留一些电流上升余量，但 6.5 mH 电感和运行转速仍决定扭矩下降。先按 1 A/相上限设计 VREF 电路，并使阈值可调；最终电流与温升在样机上确定。驱动芯片的电流能力余量用于热和供货选择，不会自动增加电机扭矩。

电机余量也可能变成拉珠受力风险：0.20 N·m 保持扭矩按 3.5 mm 珠心半径折算为约 57 N（5.8 kgf）的力数量级，明显高于用户正常手拉的 0.75–0.85 kgf，不能把高保持扭矩视为机构安全。首板需可切换的低电流接近上端模式，验证触顶峰值力与停止延迟；必要的机械限扭只能集成在本设备内，不修改窗帘。详见[芯片接口与端点检测设计](11-stepper-interface-endpoint-detection.md)。

首选 DRV8434A 是因为已在立创中国站核实裸芯片料号，且不需额外 UART 就能做 STEP/DIR 和失速检测。TI 说明失速算法需通过两个数字 IO 和一个模拟 IO 配置；**nFAULT 仍不是机械到顶信号**。低速接近上端时能否可靠检测失速待实机验证；PCB 保留设备内张力/链轮运动反馈扩展接口，不连接窗帘上的端点开关。VQFN 的散热焊盘、VM 去耦、复位默认休眠和失速信号引脚应按 [TI 数据手册](https://www.ti.com/lit/ds/symlink/drv8434a.pdf)落图。

立创商城中国站的步进电机工业品目录在本次访问时弹出安全验证码，搜索索引也未找到 42CM02-1A 的立创商品页。因此电机是**原厂规格明确的首轮候选，立创采购渠道未确认**；不得在 BOM 中填写虚构的立创商品号。驱动芯片 C2866434 的商品页已核实，实际库存和报价在下单时重查。

## 首选与备选的边界

| 项目 | 两相步进电机 + STEP/DIR 驱动 | 有刷直流减速电机 + H 桥 |
|---|---|---|
| 正常定位 | MCU 发送步数即可形成命令位置；失步时不会自动知道 | 需要编码器、霍尔或经验证的电流纹波计数等相对位置反馈；只用运行时间误差较大 |
| 上端堵转 | 常用驱动限制/调节绕组电流，**不能仅用电流幅度升高判定堵转**；本方案用反电势扭矩计数与低力矩回零，并以往返行程复核 | 停转时反电势降低，电流通常升高，适合检测；但启动冲击电流与重载电流也可能高，须设置启动屏蔽、阈值和持续时间 |
| 下端短暂顿挫 | 专用堵转算法未必会触发，须捕获实际信号 | 可能在电流或速度中留下脉冲，但也须与普通负载波动区分 |
| 静止保持 | 若机构本身能保持帘布，可让驱动休眠；若需持续励磁，会增加静息功耗 | 取决于减速机构是否能保持帘布；不能把所有减速电机都视为自锁 |
| 成本比较 | 按电机、驱动、散热和检测器件的整套 BOM 比较 | 按电机、减速箱、H 桥、位置反馈和安装的整套 BOM 比较 |

步进电机没有电刷磨损这一项，但仍可能有振动或啸叫；微步、加减速、安装隔振和实际卷帘负载共同决定听感，不能仅凭电机类别承诺安静。[TI DRV8434A 产品说明](https://www.ti.com/product/DRV8434A)描述了微步与 smart tune 对噪声的改善。步进驱动的无传感器堵转判断依赖反电势等信息，[TI 应用说明](https://www.ti.com/lit/an/slvaei3a/slvaei3a.pdf)指出低转速因反电势低而更难检测；上端回零若需慢速接近，必须验证所选电机和驱动在那个速度下的检测余量。

TI 的[步进电机无传感器堵转说明](https://www.ti.com/lit/an/slvaei3a/slvaei3a.pdf)解释了绕组电流、反电势和负载相位的关系；[DRV8424](https://www.ti.com/product/DRV8424)的 `nFAULT` 报告电气故障，不是位置到位信号。可比较有堵转检测的 [DRV8434A](https://www.ti.com/product/DRV8434A)。对于有刷直流电机，TI 的[堵转检测说明](https://www.ti.com/document-viewer/lit/html/SLVAFQ3)指出启动电流和堵转电流需要区分；[DRV8234](https://www.ti.com/product/DRV8234)同时提供电流检测、堵转检测和电流纹波计数，适合作为研究候选，不代表它已通过本卷帘验证。

## 先测什么，再决定电机

1. **保持能力：** 电机不提供保持力时，卷帘在上、中、下三个位置是否自行滑动。若会滑动，必须考虑机械保持或持续通电带来的功耗。
2. **输出需求：** 已有最大拉力和约 7 mm 珠心轨迹直径，足以作首轮 0.09 N·m 链轮运行扭矩目标。继续用弹簧秤分别测上卷、下放在多个位置的拉珠切向力，记录希望的全行程时间和拉珠总行程，得到目标转速；据此核对候选电机在 12 V 下的运行曲线。增加传动时按传动比和效率折算。相电流先以候选电机 1 A/相为上限，适配器容量待运行测量。
3. **到顶行为：** 人手缓慢拉到上端后，继续轻拉时观察是刚性停住、离合打滑还是拉珠空转；三者给电机的堵转信号完全不同。实际电机样机上记录低速到顶时的电流/堵转指标和机构受力，不以手感直接代替电气判据。
4. **下端顿挫：** 在多次、多个速度下记录扭矩计数和链轮运动，判断能否与正常负载波动、启动和换向区分。检测不稳定时只在设备内增加拉珠张力或链轮运动反馈，保持全自动校准和不改窗帘要求。
5. **首选路线判定：** 先选一组满足扭矩/速度的步进电机和具有合适失速检测的驱动，验证全行程丢步、回零重复性、途中卡阻误判、噪声、温升和静止功耗。只有其中关键指标无法满足，才拿直流减速方案比较整套 BOM、位置反馈与寿命。

开发板带电机测试不是开始软件状态机、原理图或首块 PCB 样机设计的前提。按上面的余量先制作可调电流、带检测焊位的样机；随后在真实卷帘上验证目标速度下不丢步、驱动温升和上端回零判据，再决定是否冻结量产参数。纯软件或空载波形不能证明这些指标。
