XJH-Jorhai/automatic-curtain-lifter/docs/11-stepper-interface-endpoint-detection.md

# DRV8434A 与 STM32 接口、到顶和到底检测（设计 v0.3）

> 2026-10-22 软件实现更新：本次用户指定先以360rpm试方向，把扭不动的一侧定为上卷，再100rpm找上边界、360rpm下放找反卷失速下边界并返回校验。未知位置允许1–99%估算进度，初始50%。当前实现见 [产品固件](../firmware/g030_mainboard/PRODUCT.md)；本文件以下低力矩方案为此前设计，机械阈值、最低点补偿与受力验证仍待完成。

## 1. 设计输入与结论

对象是拉珠式竖向卷帘。用户实测：上端有机械限位；下端无止动，越过最低点后开始反卷并出现顿挫；拉珠可运行超过一圈。链轮珠心轨迹直径约 7 mm、最大拉力 0.75–0.85 kgf，对应首轮链轮扭矩估算 0.0257–0.0292 N·m。按 2–3 倍余量，首版链轮运行扭矩目标约 0.09 N·m，详见[实测估算](10-curtain-measurement-estimate.md)和[电机选型](09-motor-drive-decision.md)。

首板按两相 42 步进电机候选 42CM02-1A（1 A/相）+ **DRV8434ARGER 裸芯片**（立创 C2866434）设计。STM32G030C8T6 负责发 STEP/DIR、计算相对位置，并读取驱动的 `TRQ_CNT` 模拟电压验证上端和下端事件。**产品约束：设备之外不改动窗帘或窗框，不装额外端点开关；首次收到 0% 或 100% 时全自动校准。** 上端利用原有机械限位，以受控低力矩上行和扭矩计数判定失速；下端试验扭矩计数能否识别反卷顿挫。首版不设置 HX711、应变桥或受力导轮。校准入口只用于主动重测。失速不能从原理上唯一证明已到顶，故采用行程合理性、重复性和低力矩保护降低误判风险；可靠性须在真实卷帘上验证。

## 2. 芯片、单片机和电机的连接

以下引脚号针对立创在售的 **RGE / VQFN-24** 封装；PWP 封装编号不同，不能复用。连接根据 [TI DRV8434A 数据手册的引脚表和外围表](https://www.ti.com/lit/ds/symlink/drv8434a.pdf)。

| DRV8434A RGE 引脚 | 连到 | 目的与上电默认态 |
|---|---|---|
| VM 1、8；PGND 2、7；GND 9；散热焊盘 | 受保护 12 V、功率地、系统地 | 两个 VM 脚各就近接 10 nF 至 PGND，并放 VM 储能电容；功率回流与模组 3.3 V 回流分区，散热焊盘接地铜/过孔。 |
| AOUT1 3、AOUT2 4；BOUT2 5、BOUT1 6 | 两相电机四线连接器 | 用万用表确认绕组对：A 对只接 AOUT1/2，B 对只接 BOUT1/2；交换一相极性或软件 DIR 可修正方向。 |
| DVDD 10 | 仅按数据手册接 0.47–1 µF 到 GND | 这是驱动芯片的**内部约 5 V 输出**，不是 STM32 3.3 V 供电脚；可供 VREF 分压和 M0/M1 配置，不直接连 MCU 电源。 |
| nFAULT 11 | STM32 数字输入，外接约 10 kΩ 到 3.3 V | 低有效；本设计关闭内部失速上报后，作为欠压、过流、热等驱动故障输入。发生故障立即停 STEP、关闭输出，不把它当到顶。 |
| VREF 12 | DVDD 分压、测试点、可切换下拉支路 | `I_FS ≈ VREF / 1.32`。56 kΩ 上拉到 DVDD、21 kΩ 下拉到 GND；计入芯片内部 500 kΩ 下拉后，在 DVDD≈5 V 时得约 1.32 V、1 A 满量程。另预留 MCU 控制的 NMOS + 10 kΩ 下拉支路，导通时 VREF 约 0.53 V、满量程约 0.40 A，供接近上端时降低力矩；电阻值是首板可更换的起点，实际能否运动与限制拉力待验证。VREF 不得超过 3.3 V。 |
| M0 13、M1 17 | 固定配置到 DVDD，留改值焊位 | 两脚为高选择 1/8 微步，42CM02-1A 的 1.8° 电机对应 1600 STEP 脉冲/转。微步改善平顺性，不保证每一微步有对应的位置精度。 |
| STL_REP 14 | 电阻/焊位拉到 GND，留测试点 | 选择 MCU 辅助检测：关闭芯片的失速故障上报，使 `nFAULT` 不混入机械失速；不用其高低电平当端点。此脚是开漏报告端，按 TI 指定的 MCU 辅助模式接法。 |
| TRQ_CNT/STL_TH 15 | STM32 ADC 输入 | `STL_MODE=GND` 时输出扭矩计数电压；就近 1 nF 到 GND，按 ADC 参考电压 3.3 V 采样。此值随负载增加趋近零，**不是拉珠力的绝对测量值**。 |
| STL_MODE 16 | 直接 GND，留配置焊位 | 固定为 Torque Count 模式，省去学习模式的“空载运行 32 个电周期再强制堵转 16 个电周期”过程。若将来改硬件门限模式，需重新画 TRQ_CNT 输入和信号定义。 |
| STEP 18；DIR 19 | STM32 定时器输出/GPIO | STEP 上升沿前方向稳定；定时器生成脉冲，运动层只统计实际发出的上升沿。复位时 STEP 为低，DIR 状态无关。 |
| ENABLE 20；nSLEEP 21 | STM32 GPIO，各有外部下拉 | 两脚上电默认低：桥输出关闭、芯片休眠。初始化好 STEP/DIR、ADC、故障输入和电流后先拉高 nSLEEP，等待数据手册的唤醒时间，再拉高 ENABLE 和发脉冲。nSLEEP 清除故障不得在未记录原因时自动循环重试。 |
| CPL 22、CPH 23；VCP 24 | 电荷泵外围 | CPL–CPH 接 22 nF；VCP–VM 接 220 nF，额定值和走线按 TI 数据手册。 |

不设窗帘外部端点开关。首版只用驱动扭矩计数 ADC 验证自动校准；U7 仍保留通用模拟/数字反馈扩展口，但不预设应变桥机械结构。G030C8T6 台架已占用 PA9/PA10（T1-3S UART）、PA2/PA3（调试 UART）、PA13/PA14（SWD）；PB13/PB14/PB15 在当前原理图中未使用。首板固件开发前要在 CubeMX 完成定时器 STEP、ADC、I²C EEPROM、UART、按键和 SWD 的逐脚冲突检查。

### 建议的最小 MCU 资源

| 功能 | 数量 |
|---|---:|
| STEP 定时器输出 + DIR + ENABLE + nSLEEP + 回零低电流选择 | 1 定时器通道 + 4 GPIO |
| 驱动扭矩计数 | 1 ADC 通道（PA0）；PA1 的 12 V 分压检测已删除 |
| nFAULT + U7 扩展 | nFAULT 占 1 数字输入；U7 另占 ADC/数字输入 |
| MT-0-123 双向复位钮子开关 | 2 数字输入（PC6=`KEY_UP`、PC7=`KEY_DOWN`；均低有效，拨向装板后确认） |
| SW1 独立配网键 | 1 数字输入（PC13=`NETCONTROL_BTN`，低有效） |
| T1-3S UART + EEPROM I²C | 1 USART + 1 I²C |
| SWD | 2 专用调试脚 |

### 首版扭矩计数验证

V3 原理图的 DRV8434A `TRQ_CNT/STL_TH` 接 G030 PA0，并在驱动器旁接数据手册要求的 1 nF 到地。`STL_MODE=GND`、`STL_REP=GND` 使 MCU 读取模拟扭矩计数并自行判断。该信号反映运动中的相对负载和接近失步的趋势，不提供 N·m 绝对扭矩，也不能在静止时测量保持负载。[TI 数据手册](https://www.ti.com/lit/ds/symlink/drv8434a.pdf)及[无传感器检测应用笔记](https://www.ti.com/lit/an/slvaei3a/slvaei3a.pdf)说明低速反电势弱、不同速度和方向的计数会变化；芯片以四个电气半周期的移动平均产生计数，短暂顿挫可能被平滑。当前 ENABLE 外接 10 kΩ 下拉，不能直接用其高阻态启用 8 倍计数缩放；若实测低速信号太小，应在投板前重新评估该下拉和默认禁能方式。

首板同步记录 `STEP`、扭矩计数、驱动故障和独立视频/位移标记，测定反卷事件相对真实帘布最低点的偏移 `Δ`。若反卷特征与正常链珠周期波动不可分，或 `Δ` 随帘重、速度、供电明显漂移，则下端自动校准判据未闭合，不能保存猜测行程。U7 仅是通用扩展口，不代表当前方案依赖额外传感器。

## 3. 通用运动算法

定义 `p` 为自上端向下增加的**已发 STEP 上升沿数**，上端 `p=0`，自动检测的下端为 `p=N_bottom`。1/8 微步下为 1600 脉冲/电机转，但不能将其直接乘固定帘布位移：卷筒半径随高度变化。对外的百分比先按 `100 × (N_bottom-p)/N_bottom` 显示为**标定行程比例**。全行程中拉珠/帘布若打滑，计数与真实位置仍会分离。

一次运动按下列顺序执行：检查位置可信度、方向、端点和故障 → 设置 DIR → 配置定时器与计数 → 唤醒芯片并等至少数据手册要求的约 1.2 ms → 使能桥 → 加速至设定速度 → 恒速/减速 → 停定时器、记录最后已发脉冲 → 根据机械保持能力关闭输出和进入休眠。任何 STOP、本地开关回中位、`nFAULT` 和超时先禁止新的 STEP，再处理上报；受控停机且电源稳定时才写 EEPROM。PA1 已不测输入电压，不能用它判断供电跌落。换向必须在脉冲停止后重设 DIR 并重新加速，不可边发脉冲边翻转方向。

TI 功能模式表显示 `nSLEEP=0` 时内部 indexer 逻辑关闭，不能先假定休眠后微步相位仍保持。首板验证要记录停在不同微步相位、休眠再唤醒时电机有无跳动或净位置偏移；若存在偏移，软件应优先停在一致的电周期相位，必要时把唤醒过程计入位置误差并增加回零频率。若机构断电后会自行滑动，微步相位处理也无法解决真实位置丢失，须重新设计保持或反馈。 [TI 功能模式表](https://www.ti.com/lit/ds/symlink/drv8434a.pdf)。

ADC 只在驱动已唤醒、转速稳定且有 STEP 脉冲时用于负载判据。速度变化、启动、减速、换向与芯片刚唤醒期间不判断端点；这些阶段的扭矩计数可能不同。按相同方向/速度/相电流保存正常运动的扭矩计数包络，使用中位数/低通滤波并记录持续的电周期数，避免把单次 PWM 波动认成事件。1.8° 电机每个电周期约 4 整步；1/8 微步时约 32 STEP 脉冲。滤波窗口、阈值、稳定速度和触发周期数**待样机数据定值**，不能先写死为到位常数。[TI 数据手册的扭矩计数与 MCU 辅助模式](https://www.ti.com/lit/ds/symlink/drv8434a.pdf)。

## 4. 自动校准触发与无外部开关的到顶寻找

EEPROM 中没有有效行程时，首次收到来自 App 或本地钮子开关的**新鲜、有效的 0% 或 100% 运动命令**即锁存目标并进入 `AUTO_CAL`；状态查询、上电同步和网络重放不得触发运动。其他百分比命令暂不执行，面板只显示“初始化/定位中”，不要求用户点动、观察或确认。用户可通过 App STOP 或松开本地开关停止；停止后行程仍未建立，下次端点命令从头自动校准。上电本身不引发运动。每次上电均先将位置标为不可信；有效行程存在时，下一个定位命令先自动寻找上端恢复零点；如果行程记录失效，则重新完成双端校准。

1. 校准开始检查电源和 `nFAULT`。首次未知位置先使用经实测**足以走完整个上卷行程、但触顶峰值拉力可接受**的低相电流档；0.40 A 只是可更换电阻的试验起点，不能未经实测就作为量产值。失速后不自动升电流继续推。先从平稳速度接近顶端，临近预计端点才降速；首次未知位置则全程采用经实测仍能提供可辨扭矩计数的低速，不能低到反电势信号消失。
2. 在稳定速度段，以同方向、同电流的扭矩计数包络和持续窗口识别**候选触顶失速**。立即停 STEP、拉低 ENABLE，记录候选步数；`nFAULT` 低表示电气故障，不计作到顶。最大上行脉冲、最长时间、驱动器报告的欠压故障和异常扭矩均为停机边界，不能把超时当到顶；MCU 不再测量 12 V 欠压阈值。
3. 候选点先作临时 `p=0`，继续自动下行寻找下端，并从下端再次上行到候选触顶点。两次往返步数、失速波形和估计总行程必须符合样机确定的容差；不合格时丢弃临时零点与行程并报校准失败。通过后才保存零点与下端行程。以后正常上行仅在预测上端窗口内接受失速作回零，过早失速视为途中异常，停止并使位置不可信。

这是一种接受“途中卡阻概率很低”的工程取舍：**首次未知位置的失速仍无法从原理上证明一定是顶端**，重复性检查也无法排除固定位置的持续障碍。因此不宣称绝对端点识别；必须通过样机的卡阻注入、行程合理性和拉珠峰值力试验确认可接受风险。DRV8434A 的扭矩计数和失速报告本身不会替 MCU 停止电机，[TI 数据手册](https://www.ti.com/lit/ds/symlink/drv8434a.pdf)。

## 5. 自动寻找下端并保存行程

1. 从候选上端 `p=0` 向下运行，以经样机确认能保持扭矩计数可辨识的速度通过预计最低点，同步采集 STEP 和扭矩计数。采用有界搜索：脉冲、时间、可容许反卷距离和异常扭矩均有上限。上限只能用于停止失败搜索，不能充当“到底”证据。
2. 首轮候选检测是反卷顿挫的**起始沿**，即负载特征进入经验证的转折区时的 `N_event`。事件须在多速度、多起始位置、不同供电和重复行程中可区分链轮每珠周期波动，并有独立观察到的帘布最低点作对照。真实最低点在事件之前；令 `N_bottom=N_event-Δ`，`Δ` 是实测的事件延迟和制动距离补偿，不可拍脑袋设常数。检测到事件后立即停下，再向上回退到 `N_bottom`。
3. 自动做至少两次下端检测，并在两次之间回上端确认零点；两次 `N_bottom` 的差值、事件形状和上端返回步数均须处于实测公差内，才把 `N_bottom`、算法版本和检测参数写入 EEPROM 新记录槽，附序号与 CRC，写后校验并保留上一有效记录。目标为 100% 时最终回到上端；目标为 0% 时最终回到 `N_bottom`。中途 STOP、检测不到事件或重复性不合格时停止、报告校准失败且不生成假行程，日后端点命令可重试；不要求人工教行程。
4. 后续普通下放在 `N_bottom` 停止，**不再越过最低点去找顿挫**。普通上卷只在预测上端窗口内以低力矩失速确认 `p=0`；若出现早发失速或往返步数偏差超限，停止并使位置不可信，下次端点命令自动重校。帘布改装、链轮打滑或异常掉电也触发同样流程。

**可行性边界：** 手能感到顿挫，并不能保证 DRV8434A 的扭矩计数在目标速度下有可辨特征；即使能检测事件，也必须实测 `Δ` 才能把它换算成真实最低点。若首版信号误检、漏检或偏移量不稳定，可研究本设备内的链轮实际运动反馈或机构变化；不能在窗帘或窗框上加装传感器。替代方案仍不能稳定识别最低点时，不能宣称 0% 自动校准已实现，需重新评估产品可行性。

## 6. 拉珠受力与触顶反应

约 0.09 N·m 的链轮运行扭矩目标，折算 3.5 mm 半径处切向力约 **26 N（2.6 kgf）**；42CM02-1A 原厂约 0.20 N·m 的静止保持扭矩若完全传到该半径，约为 **57 N（5.8 kgf）** 的数量级。后者不能等同实际拉珠最大力：微步相位、设定电流、机构摩擦和惯性均会改变峰值；但它远高于用户正常拉帘时记录的 0.75–0.85 kgf，**存在损伤拉珠、接头或原窗帘链轮的可能**。目前没有拉珠/连接扣的允许拉力资料，不能宣称软件失速检测足以保护它。

[TI DRV8434A 数据手册](https://www.ti.com/lit/ds/symlink/drv8434a.pdf)将失速列为 **report only**：芯片检测或报告失速不会自行断桥。本设计又采用 MCU 读取 ADC 的模式，必须由 MCU 主动停止 STEP 并拉低 ENABLE；如果 MCU 卡死，直到看门狗复位或其他硬件动作前仍可能持续施力。仅缩短 ADC 判定时间只能减少持续时间，**不能限制接触瞬间的峰值拉力**。

例如 1.8° 电机每转约 50 个电周期；若算法要求低计数持续 2–4 个电周期，在 30 rpm 命令速度下仅这一确认窗口就约 **80–160 ms**，另有滤波、调度和关断延迟。此值是算法预算示例，不是已测到的整机响应时间；速度更低时同样周期数所需时间更长，而反电势信号也更弱。

首板以电流设定限制接触峰值力，以 MCU ADC 判据、脉冲/时间上限和看门狗限制持续施力。**首次未知位置校准全程使用经验证可走完整程的较低电流档**；已有可信位置的普通上行可按需求运行，在预计上端窗口内减速并切低电流。低电流若无法可靠上卷，不得在疑似失速点自动提高电流盲撞；应重新选电机、传动比或限扭结构，全部集成在本设备内。没有外部开关时，软件停止延迟和复位前的持力风险必须通过实测峰值力与磨损验证。

样机测试至少记录上端触发时的**实际拉珠峰值力或等效链轮扭矩**、停止延迟、重复接触后的拉珠/接头磨损，以及 0.40 A 低电流档能否在预计上端附近完成上卷。只有取得拉珠允许拉力或经同材质样品试验确定的上限后，才能设定可接受的峰值力和限流值。

## 7. 状态、记录与验证出口

`UNTRUSTED → AUTO_CAL_TOP_CANDIDATE → AUTO_CAL_BOTTOM_1 → AUTO_CAL_TOP_CHECK → AUTO_CAL_BOTTOM_2 → SAVE_RANGE → MOVE_TO_REQUESTED_ENDPOINT → IDLE` 是首次端点命令触发的自主流程。电气故障、早发失速、端点超时、EEPROM 记录损坏或运动中异常复位转为 `UNTRUSTED/FAULT`，清除在途目标；上电不自动续跑。EEPROM 保存有效范围和最近一次安全停机位置，位置可信度在每次上电后都先置为不可信。自动上报的中途位置是步数估算值；通过往返校验后才把上端候选点接受为零点。

设计阶段可用模拟 ADC 序列和虚拟步数测试：首次 0%/100% 自动触发、上端正常失速/途中卡阻、启动低计数、下端短脉冲/无脉冲、重复检测偏差、`nFAULT`、外部供电跌落、停止抢占和异常重启。首板样机需要记录电机目标转速、ADC 原始计数、STEP 计数、`nFAULT`、电源、拉珠峰值力和帘布真实位置；先完成上端误检/漏检与卡阻注入、下端重复性、长时间运行丢步和断电保持观察，再固化阈值。开发板不接电机也可实现和测试运动状态机，真实机构验证放在首板样机阶段。
