XJH-Jorhai/automatic-curtain-lifter/hardware/release-2026-10-25/mainboard-schematic.pdf

## 主板原理图快照与实装修改单

2026-10-25 / Product v15 / XJH-Jorhai

重要：后续四页为原生工程图面，仍显示旧 R4/R6 阻值。

复刻必须采用：R4 = 30 kΩ；R5 = 21 kΩ；R6 = 4.7 kΩ。

采购和贴片按 mainboard-bom-as-built.csv，并核对修改单。

板材：FR4，2 层，板厚 1.6 mm，铜厚 1 oz（作者确认的下单参数）。

图面由 EasyEDA 单页 SVG 导出后高分辨率渲染，避免直接 PDF 缺字。

同目录 schematic-svg 提供可缩放矢量原图；原生 EPRO 可继续编辑。

当前 PDF 不表示原生工程阻值已同步，也不代替整机性能验收。
