XJH-Jorhai/automatic-curtain-lifter/hardware/Parametric ball chain pulley - 3147/LICENSING-NOTE.md

# 珠链轮许可说明

原始 `LICENSE.txt` 明确写明 Unaimed 的 Thing 3147 采用 GNU GPL，但未指定版本。原始声明完整保留。源码头部另保留基于 zignig Thing 1322 的来源。

本次分发依据 GNU GPL 对未指定版本的条款，选择遵循 GPL 第 3 版，不宣称上游曾明确标注 GPLv3。完整文本见 [GPL-3.0.txt](../../LICENSES/GPL-3.0.txt)。依据：[GNU GPL 第 14 节](https://www.gnu.org/licenses/gpl-3.0-standalone.html#section14)。

本目录原模型与改作，以及 `hardware/sheelandholder/parametric_ball_pulley_9slots.stl` 均不适用根目录 MIT 或原创硬件 CERN 许可。保留对应 OpenSCAD 可编辑源码；改作内容由 XJH-Jorhai 于 2026 年修改，包括 9 槽珠链尺寸、轴孔及间隙适配，具体参数见源码。原始源码另以 original.scad 留存。

此处说明的是本次分发遵循的版本，不改写上游作者声明，不限制上游原始授权中已有的版本选择。
