XJH-Jorhai/automatic-curtain-lifter/LICENSING.md

# 许可范围

Copyright © 2026 XJH-Jorhai。项目采用以下分层许可；已有第三方声明优先，不将第三方代码、模型或资料重新许可为本项目原创内容。

| 内容 | 许可 | 范围 |
|---|---|---|
| 自有软件、脚本和测试 | [MIT](LICENSE) | firmware/App 自有代码、工具、构建配置和原创测试；排除第三方/生成代码已有声明 |
| 原创电气与机械设计 | [CERN-OHL-P-2.0](LICENSES/CERN-OHL-P-2.0.txt) | 仅项目权利人拥有的设计部分；排除珠链轮改作、供应商模型、数据手册和库素材 |
| 原创说明文档 | [CC-BY-4.0](LICENSES/CC-BY-4.0.txt) | README、docs 和原创设计说明；引用、转载内容保持原许可 |
| STM32 HAL/CMSIS | 各目录原始许可 | 保留原文件头与 LICENSE 文件 |
| 参数化珠链轮及衍生件 | GNU GPL，本次遵循第 3 版 | 上游未指定版本，保留原声明；见珠链轮目录 LICENSING-NOTE.md，不适用 MIT/CERN/CC 改许可 |
| 涂鸦生成 SDK/模组固件 | 由平台授予的使用/分发条件 | 不随本发布候选分发，不属于项目自有开源授权 |

这些选型允许在遵守相应署名、声明等条件下使用、修改和商用；没有新增非商业限制，也不要求所有下游修改都必须开源。GPL 改作例外需遵守其原许可。

硬件 Source Location：https://github.com/XJH-Jorhai/automatic-curtain-lifter

依据：[MIT 官方文本](https://opensource.org/license/mit)、[OHWR 分层许可说明](https://ohwr.org/licences/)、[CC BY 4.0](https://creativecommons.org/licenses/by/4.0/)。文件来源和第三方例外见 [THIRD_PARTY_NOTICES.md](THIRD_PARTY_NOTICES.md)。
