XJH-Jorhai/automatic-curtain-lifter/docs/privacy-review.md

# 公开候选隐私审查 · 2026-10-25

审查范围为当前发布候选的文件内容、文本/压缩包成员及 Git 作者记录；原始开发目录保留为私人资料。公开署名仅使用 XJH-Jorhai。

已发现并处理：作者绝对路径、调试器编号、产品标识、个人 Git 邮箱、现场调试日志，以及 3MF 内设计者账户编号。原始授权包、第三方 SDK、EEPROM 转储、旧历史截图和未经核实的二进制模型不进入候选。硬件电路及接口 UUID 是编辑所需引用，不能当作密码一律删除。

构建/烧录入口已改为 PATH 或显式参数；探针编号必须由用户提供。启动旋律和运动参数保留为可修改示例；实际行程须由自己的设备校准。原始现场测试结论只作为样机证据，不能当作别人的安装参数。

文本扫描未发现可确认的私钥或已赋值的访问令牌。扫描不是绝对安全证明：压缩格式已检查成员，SolidWorks 不透明格式未完成依赖/元数据审查，因此暂不发布。第三方代码的原有作者和许可署名依法保留；“仅保留 GitHub 署名”适用于本项目作者身份，不删除第三方归属。

用户已授权以无旧父提交的新历史替换私有远端 main，并在本地保留旧历史备份。重建分支不能保证平台缓存、既有克隆或按旧 SHA 可访问对象立即消失；检查确认旧 SHA 仍可访问后，采用用户授权的隔离方案：旧库改名并保持私有，原名称新建公开库，仅上传清理后的历史。公开前确认新库无法访问旧 SHA。

## 补充机械文件审查

作者提供盖子、架子、壳子三个 AP214 STEP，作者和组织字段为空，文本扫描未检出个人邮箱、本机路径或已知私人标识。实体引用及结束标记完整，候选副本与原始导出逐字节一致。原 SolidWorks 装配引用损坏，未将其纳入公开候选；STEP 不含原参数化特征树或完整装配关系。

新增原理图 SVG/PDF 经文本、元数据及图面检查，图框作者为空；PDF 署名为 XJH-Jorhai。STEP 独立 CAD 有效性已验证，仍不表示装配干涉已验证。

## 配图审查

作者提供的样机实拍和 PCB 渲染已加入 docs/images，采用通用文件名，不保留来源目录或聊天文件名。已检查画面，未见人脸、地址、账户或设备授权信息；保留电机厂标和电路标识。图片清除可携带信息的元数据段，未裁剪、重绘或重新压缩；解码后的 RGB 像素与原文件逐字节一致，EXIF 为空。
