XJH-Jorhai/automatic-curtain-lifter/firmware/g030_mainboard/LOCAL_SWITCH.md

# 本地钮子开关：空载按住运行

本轮验证空载按住运行、松手停止；尚未实现执行器限位和位置控制。
用户确认电机没有连接负载。

已实测输入（每个位置连续读取三次）：

| 位置 | PC6 / UP | PC7 / DOWN | 本轮映射 |
| --- | --- | --- | --- |
| 中位 | 1 | 1 | 停止开关发起的点动 |
| 上位 | 0 | 1 | 正转请求，DIR=0 |
| 下位 | 1 | 0 | 反转请求，DIR=1 |
| 同时有效 | 0 | 0 | 冲突，停止并等待中位 |

这里只定义逻辑方向。开/关与电机方向的对应关系留到装配及云端配置时确定。

## 行为

- 30次连续1ms采样确认方向后启动；先稳定中位30ms才能接受下一次方向请求。
- 本地开关按住持续运行，松手立即停止；正常运行档约1.50A满量程，TIM14从50Hz在1000ms内升至2667Hz（按1.8°/1⁄8微步为100rpm）。不再因400微步停止。
- 开关发起的点动中，一旦离开当前方向，下一次SysTick采样立即停止，不等待释放消抖。
- 不允许直接从上位切下位自动反转；必须经过稳定中位再拨方向。
- 上电时保持方向不启动；B1期间的拨动不排队。
- 达到单次30秒运行保护、故障或串口STOP后，保持方向不重复启动，必须先回中位。
- 启动动作在主循环中执行，超过50ms仍未消费的请求丢弃；中位取消待执行请求。
- 既有nFAULT、主循环250ms未服务及运动超时保护保留。不具有独立看门狗保护。
- 开关中位停止作用于开关发起的点动；独立串口/音乐诊断仍由STOP停止。
  同时有效的冲突输入会停止任何正在进行的运动。
- 不访问EEPROM，不周期输出串口日志。

## 调试入口

`SW STATUS`只报告RAM状态及GPIO：
raw=0中位、1上、2下、3冲突；armed为已回中位允许下一次启动；
owned为本地开关点动；pending为待主循环执行；up/down/stops/reject为累计计数。

`SW TEST`仅对局部RAM状态测试上电方向保持、消抖、直接换向拒绝、
中位即时停止、限步结束不重启、音乐忙时丢弃请求及双输入冲突；
不发任何电机脉冲。

GPIO实际波形/停止延迟未经示波器量测，“下一次1ms采样”是代码路径边界。
现场动作、方向及停止观测须记录在对应测试报告中。

## 当前启动参数

500ms诊断等待已移除。保留2ms唤醒、1ms使能准备；本地开关单次最长30秒，达到后正常关闭绕组并保留相位；串口MOTOR RUN诊断仍限400步/2.5秒。

## 相位保留策略

正常点动停止关闭ENABLE（绕组高阻），不再进入休眠，保留驱动内部索引。
故障仍进入休眠；音乐路径不变。状态回报字段SLEEP代表nSLEEP引脚，
因此普通停机后EN=0/SLEEP=1表示已关闭绕组但驱动逻辑仍醒着，并非电机保持励磁。
该策略不保证掉电、外力移动后的位置与相位一致；实际改善待现场比较。

现场结果（2026-10-21）：连续两次完整400步同方向运行，第二次用户反馈启动抖动明显减轻或消失。
回读确认正常完成、EN=0/nSLEEP=1，保持上位未重启。该结论仅覆盖此固定终点条件，
首次上电及任意微步中断后的启动仍未确认消除抖动。

开关为弹簧自复位型，用户反馈保持力大；现场验证改为短按，禁止要求长时间保持以供回读。
2026-10-21用户确认上、下位实际转向相反。开/关映射仍未定义。

基本功能现场验收（2026-10-21）：用户确认上下位转向相反，松手回中位后电机停止。
正反向请求与松手停止的空载测试通过；没有测量精确停止延迟。后续已按用户要求移除500ms诊断等待。

TIM14在正常运动和音乐间互斥使用；SysTick负责开关及安全服务，不再输出正常运动STEP。
定时器每次从实际服务边沿重新计时，不追赶丢失时间；ISR延迟会使实际速度略低于目标。
停止会关闭定时器并拉低STEP/ENABLE。精确波形和机械实际转速尚未仪器测量。

本地模式状态held=1/goal=0表示不设步数终点，count继续累计；reason=6表示30秒保护停止，
松手停止为reason=4。30秒保护后须先回中位，不能保持方向自行重启。
