XJH-Jorhai/automatic-curtain-lifter/firmware/g030_mainboard/PRODUCT.md

# 产品应用固件 v15（2026-10-25）

v15取消边界外微调的4799微步运动配额：明确微调时保持触点持续运行，松开即停，全段不进入1秒自动；已越界时反向调回范围内也保持手动。正常自动运行及App仍停在已保存端点，实际堵转/故障和原全局保护保留。原LW9校准、物理顶偏移及三圈端点分类规则不变。见[v15部署记录](../../hardware/test-records/2026-10-25-product-v15.md)。下方v14及更早验收为历史。

v14修复中间校准点重启后的坐标偏移，并增强App校准按钮松开上报。物理顶与用户上端分开：学习并保存二者偏移，重启找物理顶后回到用户的校准坐标定位。旧LW8跨度126113与两端手动标志已通过一次实板重启恢复，但没有物理偏移，需要在原校准上端明确一次当前点，再找顶学习后保存LW9。部署与验收见[v14记录](../../hardware/test-records/2026-10-25-product-v14.md)。下方v13验收为同次上电结果，不能代替新校准点重启实测。

v14实物验收已通过：用户确认按钮自动复位、参考学习/定位正常，以及重启后百分比与原校准端点正常。跨度126113/物理偏移40827/序号10经实板重启恢复，重启定位不需重新校准。用户后续又微调保存，当前为跨度199275/偏移2950/序号12，两个手动端点来源齐全、存储与通信错误0；该最新微调记录本轮只核对保存，没有追加复位。

v13适配用户已上线的新面板：DP2上传最近接受的目标，DP101单独上传实际/估算进度；DP102/103为rw布尔瞬时命令，true分别将当前位置保存为上端/下端，处理结束回报false。用户确认两个新增DP已改为rw。实体钮子、配网键校准、360 rpm/约1.50 A、TRQ和B1参数保持原值。部署与本轮验收见[v13记录](../../hardware/test-records/2026-10-25-product-v13.md)。

v13新面板已由用户验收：目标/进度独立、定位和停止正常，两个保存按钮及校准后自动停位正常。只读核对两次App校准均成功，两个事件保存、零错误，当前行程126113微步，manual3/saved1，最近上下均按保存脉冲数停止。

上报false只表示按钮已复位，不能供面板宣称EEPROM保存成功；实板保存结果通过只读诊断及日志核对。无新增步数备份DP，EEPROM仍是校准依据。

v12修复共用滑条的进度显示：DP2下发设置内部目标，上报则与DP101使用同一份当前位置，每500 ms随进度更新，停机/状态变化及时报告。显示上报仅发SDK命令0x07，不进入命令0x06的运动处理；内部目标不会被显示反馈覆盖。当前修正版部署见[v12记录](../../hardware/test-records/2026-10-25-product-v12.md)。

本轮实物验收已完成：钮子1秒自动/反向逻辑、App开停关及百分比定位均已通过，用户确认v12“进度跟随且定位正常”。验收后云端在线、空闲无故障，202363微步校准保留，通信/存储错误0，App运动未新增EEPROM保存。

v11增加钮子1秒自动运行和反向停机/延时换向，补齐涂鸦DP1/2/101状态同步。行程已知但重启后当前位置未知时，首次云端定位先上卷找顶，再定位到请求值；STOP可取消整个过程。速度、电流、TRQ滤波、原B1和LW8存储格式不变。部署见[v11记录](../../hardware/test-records/2026-10-25-product-v11.md)。

v10的手动上下端校准已由用户验收：按校准点正常停止。只读核对得到LW8序号6、标志126、PC7为上、行程196823微步，两个手动来源位齐全，3次保存、0错误。最近上下端快照均为result6计数停止。见[v10记录](../../hardware/test-records/2026-10-25-product-v10.md)。

v11钮子功能已由用户实物验收通过；验收后最新保存行程202363微步、LW8序号7、manual3/saved1、0存储错误。用户再次配网后只读捕获状态3→4；随后确认App开停关正常，61%/27%实际停位接近目标。中间进度未显示的问题由v12修正并通过用户验收。

## 钮子自动运行

1. 首次稳定拨动后开始运动；运动持续满1000 ms时进入自动运行，回中位继续到已保存端点。不足1秒松开则立即停，用于点动。
2. 运动中收到反向触点，首次SysTick样本即停止脉冲。反向保持满1000 ms才开始反转；提前松开则保持停止。
3. 反转开始后重新计时1000 ms；满1秒后松开可继续到相应端点，否则松开立即停。
4. 到端点或保护停机后，持续按住不会自行重启或进入微调；需稳定回中位再拨。两触点同时有效、配网键、云端STOP及故障均能停止。
5. 钮子持有物理输入时本地优先；自动运行且已回中位时，App可接管。App运动中的反向钮子同样立即停、保持1秒后反转。启动已拨住的触点仍要求先回中位。

## 手动校准与微调

1. 用不足1秒的短拨点动到想要的上端，回中位，短按配网键后松手，即记录上端。若正在自动行进，可直接短按配网键：按下即停、松开记录之前本地方向。下端同样操作，在真实最低点短按，不必等反卷失步。
2. 端点含义采用按下配网键之前最后一次有效的本地钮子方向；松开钮子仍保留该方向，App命令不替代它。重启后若未拨过钮子，短按不校准。
3. 若最近方向向下，但当前位置距已知上端严格小于三圈，则认为在微调上端；向上但距下端不足三圈则记下端。三圈为4800微步，4799满足、4800不满足。位置未知时不使用此修正规则，不以模拟百分比猜距离。
4. 到已知边界自动停机后，先回中位，再同向拨动进入持续微调；按住持续运动、松手立即停，不再按4799微步截断，也不进入1秒自动。已严格越界时两个方向都保持手动微调，反向调回范围后仍需按住；到准确位置再短按或用App明确保存。App全开/全关不启用微调越界，实际堵转/故障和全局保护仍可停止。
5. 配网键按下即先停止电机；30 ms消抖后接受，短按松手提交。按住钮子同时校准也能停机，但松开配网键后不会自行续转，需钮子回中位再拨。长按5秒只触发一次配网，松开不会再校准；上电已按住配网键则等待松开，不作短/长按动作。

手动上端会以已知下端修正行程，手动下端以已知上端修正行程；没有可信相对参考时先建立当前端点，再到另一端完成跨度。若在旧边界前真实失步，停机保留一次用于手动校准的相对参考，正常百分比位置仍标为不可信；再次运动前未使用则丢弃该参考。异常失步不会静默覆盖已保存边界。

当前位置可信时，全开/全关与中间目标都使用精确脉冲截止；刚重启后仍须真实端点或一次手动校准建立位置基准。下列v9现场数值为更新前记录，v10实际端点以手动校准后结果为准。

用户已选择采用本机实物确认的方向：DIR0上卷、DIR1下放，恢复产品模式及EEPROM保存。当前默认Product已烧录并通过完整读回和启动检查；本机不再执行双向失步试探。机械引脚见 [PINOUT.md](PINOUT.md)，此前上下端实测见 [v8记录](../../hardware/test-records/2026-10-25-trq-filter-v8.md)。

v9实板历史记录保存PC7为上、239993微步行程并通过软件复位恢复，详见[v9核验记录](../../hardware/test-records/2026-10-25-product-v9.md)。v11烧录后恢复196823微步LW8记录、两个手动来源、触点和方向，启动读取4次、零写入；后续钮子验收时最新校准行程保存为202363微步，详见[v11核验记录](../../hardware/test-records/2026-10-25-product-v11.md)。重启后当前位置需真实端点或手动输入对齐，云端请求会主动执行一次找顶参考。

## 首次使用

1. 无有效记录时，先让开关回中位。首次通过30 ms消抖的触点定义为“上”，另一侧为“下”。上电已按住时不启动，必须先回中位。
2. 首次触点事件将已确认方向和触点保存到EEPROM，回读成功后才运行；保存失败停止，不自动重试。没有两段试探过程，后续松手或重启不重新定义已保存的触点。
3. 按住上侧到真实顶部自动停止，松手；再按另一侧到底反卷后自动停止，松手。也支持先下端后上端。中途松手或换向保留本次上电的相对坐标。
4. 方向、首次端点及完整行程按事件保存；两个端点完成后具备行程。无有效记录时需完成一次学习，已有有效LW7/LW8记录直接沿用；历史测量数值不硬编码或预置EEPROM。
5. 已保存后重启保留方向、触点和行程，当前位置仍待一个真实端点重新对齐。不会因开机、状态查询或联网自动运动。

## 运动与检测

| 动作 | STEP速率 / 名义转速 | 电流档 | 到达事件 |
|---|---|---|---|
| 上行 | 9600 STEP/s / 360 rpm | 全程原约1.50 A | 坐标可信时计数到点；未知时找顶失步建立基准 |
| 下行 | 9600 STEP/s / 360 rpm | 全程原约1.50 A | 坐标可信时计数到点；初次端点可手动校准或反卷失步建立 |

电流由VREF换算，非绕组电流实测。不切0.42 A档。TIM14为1 MHz，52 us半周期，量化转速约360.58 rpm。每转1600微步。

每5 ms采样TRQ，取最近5点中位数，健康基线也使用中位数。1秒加速和150 ms稳定等待之后，持续80 ms低于 `max(64, 本段健康基线×50%)` 才判为端点。健康最低ADC128，基线仅缓慢上调，不随逐渐下降的信号漂移。每段清空滤波窗口。原始ADC>=4080持续50 ms直接报ADC故障，不受滤波掩盖。

此前v8同工况现场：用户确认上端0.1–0.2秒自动停，下端反卷后也很快停；两次记录从TRQ明显下降到停止约90 ms。机械到达时刻没有外部传感器时间戳，不把该值当作精确响应标定。当前产品沿用同一运动/滤波实现，增加保存与App工作流程。

行程使用首次低值处的指令步数，排除随后80 ms确认期间的脉冲；音乐脉冲不进入运动计数。行程范围1600–300000微步，软件没有编码器，不把指令脉冲当作测得的转子位移。下端参考仍为反卷检测位置，实际最低点补偿默认0。

本地点动松手第一个SysTick样本禁能，自动运行回中位继续；反向或同时按上下立即停。反向输入持续1秒才反转；运动规划内部仍保留200 ms换向/保存等待。nFAULT、ADC失败、主循环250 ms失活、300000指令步数、单段120秒及过程360秒上限均停止。全局关中断或核心被调试器暂停不在SysTick保护范围内。

## 百分比与App

未知位置/行程时初始50%，运动时每400 ms朝请求方向推进1%，夹在1–99%；停止保留显示。只有实际确认端点可回报0%/100%。行程和本次上电位置都可信后，按指令步数计算中间百分比，四舍五入不伪造端点。

DP1为open=0、stop=1、close=2；DP2接收0–100整数目标，上传最近接受的目标，DP101上传当前位置。新面板目标滑条只绑定DP2，进度只绑定DP101；运动与STOP不会把目标改成当前进度。启动时未接收操作的目标初值50，不写EEPROM、不启动运动；实体操作接受后目标为0/100，成功校准后目标对应0/100。进度最多每500 ms上报一次，状态/目标改变与停机及时上报。状态查询及上报不调用Product_Request。当前SDK仍拒绝continue=3，未定义安全恢复动作。

DP102 `cali_upper_end`、DP103 `cali_down_end`均为rw Bool，默认false。面板每次点击发送true，MCU先停止并冻结最后指令步数、取消自动/换向/找顶后续目标，再按按钮明确含义保存上端或下端；App按钮不使用实体配网键的三圈内反向修正规则。回报true确认瞬时事件，主循环300ms后回报false、再隔1200ms补报一次；上电/重新联网和查询也上报false。收到false不停止、不校准，延迟报告不重新校准、不重试保存或运动。普通进度上报不反复发送按钮复位。

尚未定义本地上触点、采样专用构建、通信离线、物理配网键占用、上下触点冲突或驱动故障时不接受云端校准。按住单侧钮子时校准会停止并消耗该输入，须回中位才可重新拨动。两端测得跨度必须1600–300000微步，非法跨度拒绝；写入失败停止、保留失败诊断、不自动重试，下一次明确校准可重试。每次上电仍共享8次保存尝试上限。重复保存相同记录无EEPROM访问。

已保存行程且当前位置可信时，0/100以及中间百分比都按脉冲截止。已有物理参考偏移时，重启后的首次云端运动先上卷找物理顶，物理顶坐标为负偏移；停200ms后按“偏移+校准跨度内的位置”到请求值，100%也回到用户的上端。物理顶不再冒充中间校准上端。

旧LW7/LW8手动上端没有物理偏移，重启位置未知时拒绝猜零定位；先在原校准端点再点一次相应保存按钮，跨度保留，当前位置获得手动参考。首次云端定位从该参考找物理顶，计算偏移、禁能写入并回读成功后继续目标。后续LW9重启不需再次标记。位置未知时重新校准任一端可能平移坐标，需重新建立一次物理参考。自动物理上端且无手动上端的旧记录偏移为0。

找顶期间修改目标只更新后续目标，不重启找顶；STOP、本地操作和断网都能取消找顶与后续定位。行程未知时1–99仍拒绝，不用模拟进度定位。中途失步视为障碍并撤销当前位置可信标志，不覆盖已校准行程。

首次本地上触点尚未定义时拒绝远程运动，STOP始终可用。云端运动要求模组状态4（云端在线）及通信健康，失联时停止；状态2表示未连路由器。离线本地仍可用，PC13稳定长按5秒进入AP配网。PID沿用原产品；102/103采用用户新面板定义，SDK移植脚本补齐表和分发，原2026-07-16快照不改动。普通TuyaApp验证构建不启用新增Product命令。

## EEPROM与开机旋律

行程日志使用0x200、0x210两个16字节交替槽，方向、上触点、端点和手动来源标志保留。物理参考已知的手动上端保存为LW9：26位回绕序号、19位行程、19位物理顶偏移和CRC32；行程/偏移有300000微步总跨度上限。其余状态沿用LW8，兼容读取LW7；忽略旧v6实验记录及与本机DIR0冲突的记录。启动不擦除或写入迁移记录，最新槽损坏时回退到旧有效槽。旧手动记录缺少偏移时不能直接重启定位。

只有已完成的触点/首次端点/首次行程事件触发保存，电机禁能后比较差异、单页写入、回读校验。相同状态在RAM判重，不产生EEPROM访问。不同学习事件可在60秒内提交，共享每次上电8次尝试上限，失败也计数；普通EEPROM更新仍有60秒冷却。保存失败停止，无定时重试，下一次明确操作可重试。没有后台扫描或周期保存。

保留原EEPROM的B1：

~~~text
T232 C4/16 E4/8 F#4/16 R/16 Ab4/8 G4/16 R/16 B4/16 C5/4
~~~

音高、1177 ms乐谱时长和30 ms事件间隔不变，原约1.50 A、正反各5微步；启动完成3340脉冲、净偏移0。音量7/10是用户试听目标，没有声压实测。外设/安全服务/通信初始化后只读取播放一次；上电按键占用则跳过、不补播。按键、STOP、运动和故障可中断。没有音乐保存、串口试听或自动重试入口。

正常启动读取两个日志页和两个音乐槽，共4次读、0次写。音乐槽不改动，音乐期间无EEPROM访问。

## 状态与诊断

USART2/YOUR_SERIAL_PORT为115200 8N1，模块USART1为9600 8N1。调试串口仅S/M/?查询、X停止，旧FBTH及音乐命令没有动作。

| 字段 | 含义 |
|---|---|
| map | 0未定义上触点，1=PC6为上，2=PC7为上 |
| mode / dir | 已确认方向的工作模式1 / 方向已知与上卷DIR，本机1/0 |
| known / ends | 行程和当前位置可信标志 / 已发现上下端 |
| saved | 当前方向、触点和边界与已回读验证的记录一致 |
| ee | 日志读取次数/保存尝试次数/存储错误次数 |
| trq / trqf | 原始ADC / 端点判定使用的中位数 |
| low | PA4低档选择电平；当前运动为0原电流，禁能时绕组无输出 |
| probe | 保留字段名，当前表示最近上/下自动停机快照，未执行探测 |
| work | 最近工作段结果；0无、1进行中、2失步端点、3完成、4取消、5故障、6按已存端点步数停止 |
| boot / music | 开机音乐事件结果 / 音乐状态、脉冲数、指令偏移 |
| capture | 正式产品0，独立只读采样版1 |
| manual | 手动来源位：1上端、2下端、3两端均手动；来源标志保存到v8 |
| cal / last | 最近短按分类：1上端、2下端、3无之前输入、4无效跨度；最后本地方向1上/2下/0无 |
| auto / reverse / home | 本地自动运行标志 / 等待反向的物理触点 / 云端参考流程0无、1找顶、2停200 ms等待目标 |
| ref | 物理顶参考可信标志 / 用户校准上端距物理顶的指令微步偏移 |

phase为0空闲、3运动、4故障；历史1/2探测编码不在当前产品运行流程中。无有效记录启动为map0/mode1/saved0，百分比50，等待首次触点。

RAM槽0/1分别保留最近上/下自动停机160条10 ms原始采样，槽2为最近工作段循环采样。手动短拨不覆盖自动停机快照；5 ms维护样本数和极值。停止后使用匹配ELF的 `work/read_motion_observation.py --trace-out <JSON>` 只读提取，摘要加 `--capture` 标记槽含义。采样不写EEPROM、不自动串口流式输出。

## 构建与验证

~~~powershell
.\firmware\g030_mainboard\build.ps1
.\firmware\g030_mainboard\test_product.ps1
~~~

默认Product明确 `TRQ_CAPTURE_ONLY=OFF`、`PRODUCT_UP_REVERSE=0`，输出在work/g030-mainboard-build/Product/。烧录统一使用flash.ps1或flash_bounded.py浮条入口；当前50 kHz SWD、4字块，全量读回、选项字、复位及会话清理成功后才判完成。

无有效记录的只读启动检查为 `product_status.py --elf <ELF> --port YOUR_SERIAL_PORT --confirmed-direction`。已有LW7/LW8记录或正常运行后用只读观察脚本，不使用启动空白断言。实际部署见 [v11记录](../../hardware/test-records/2026-10-25-product-v11.md)。

主机复用真实motion、运行层、驱动、音乐、涂鸦SDK及EEPROM实现，GPIO/ADC/I2C为RAM模拟，不编入产品镜像。覆盖当前方向流程、先保存后运动、上下全电流滤波端点/行程、v7迁移和重启恢复、App37%/STOP/离线、持续微调/松开/反向/无自动写入、保存故障及次数限制；另回放真实保留波形。历史探测回归显式关闭LIFT_CONFIRMED_DIRECTION，其电流及方向行为不代表当前产品。独立只读采样说明见 [TRQ_CAPTURE.md](TRQ_CAPTURE.md)。
