XJH-Jorhai/automatic-curtain-lifter/firmware/g030_mainboard/TUYA_APP.md

# 主板涂鸦应用：当前基线与机械阶段交接

**2026-10-24 v2：** 首次本地开关定义“上”，识别成功立即保存方向/触点；后续上行360rpm、下行800rpm，失速学习边界。未完成本地学习前拒绝远程运动，中间百分比定位需有效行程和可信位置。开机B1使用增强音量试听档。当前行为见[PRODUCT.md](PRODUCT.md)和[v2记录](../../hardware/test-records/2026-10-24-workmode-v2.md)，下方当天较早设置为历史。

**2026-10-24恢复开机旋律：** Product已接回原EEPROM的B1开机旋律，一次播放且升降优先；800rpm、单向1.5秒及其他升降参数不变。见[本次记录](../../hardware/test-records/2026-10-24-probe800-music.md)。

**2026-10-24速度更新：** 用户观察720rpm已出现丢步，方向试探独立提高至800rpm，单向上限由2.5秒缩短至1.5秒，确认失速即提前停止。找底和正常下放独立配置并保持360rpm，上卷/归零保持100rpm；加速、电流与判定阈值保留。机械已接窗帘，当前等待用户观察800rpm试探效果，详见 [本次记录](../../hardware/test-records/2026-10-24-probe800.md)。下文早期360rpm试探描述为历史设置。

**2026-10-22 当前版本为 [Product 产品应用](PRODUCT.md)。** 默认构建/烧录已替换2秒联调版，接入PC6/PC7按住升降、松手立即停止、DP1开关停止、DP2百分比和DP101进度回报。未知位置从50%开始，动画仅在1–99%内；首次请求按360rpm双向试探、100rpm上端回零、360rpm下端搜索、返回校验建立行程。机械未接入，阈值与真实最低点偏移待验证。

模块串口仍为USART1 9600，日志USART2 115200；当前调试器串口为 **YOUR_SERIAL_PORT**，更换USB接口后按调试器UID重新枚举，不固定假设COM3。PC13长按5秒AP配网保留。产品状态读取改用 `product_status.py`，旧SWD注入工具只适用于历史TuyaApp镜像。

**以下内容仅记录2026-10-21历史联调版**，其中“不上报位置”“DP2不支持”“2秒截止”和测试入口不适用于Product。当前参数与测试结果均以 [PRODUCT.md](PRODUCT.md) 及 [2026-10-22记录](../../hardware/test-records/2026-10-22-product.md) 为准。

更新日期：2026-10-21。当前保留限时电机联调能力，到位检测、行程标定和百分比定位等待机械搭建完成。历史排障记录位于 `hardware/test-records/2026-10-21-tuya-mainboard-protocol.md`；本文件只描述当前行为。

## 构建与实板版本

| 版本 | 用途 | 验证状态 |
|---|---|---|
| TuyaApp | 涂鸦协议、配网、限时开关和停止 | 整理版构建通过；实板仍为之前通过运动测试的版本 |
| Release / Debug | 原本地电机、音乐等应用 | 本次 Release 构建通过，不与 TuyaApp 同时运行 |
| TuyaBridge | 固定波特率透明桥，烧录/授权期间使用 | 本次构建通过；不可用来执行 App 业务 |

已验证实板镜像保存在 `work/releases/2026-10-21-tuya-app-verified/`，包含 ELF/BIN/HEX；BIN 19684 B，SHA256 `83fa71d780d436f2155435db1740551e3879979592d644a205695c60a30aab57`。

整理版位于 `work/g030-mainboard-build/TuyaApp/`，BIN 19764 B，SHA256 `a1221bd92bfc7596e793a3429aa6165fdc769914407b4736613c7a5db8185c56`。本轮未烧录、未重新启动电机。读取当前实板 SWD 符号应使用上方已验证版 ELF，不能使用整理版 ELF。

## 通信和配网

- USART1 PA9/PA10：T1-3S 模组，9600 8N1。
- USART2 CN1.4/.5：COM3 日志/诊断，115200 8N1。此时不是透明桥，不能用它直接烧录或授权模组。
- PC13 NETCONTROL_BTN：低有效，去抖30ms，稳定按下满5s进入AP配网；长按只触发一次，释放后重新使能；上电已按住须先释放。
- CEN仅复位模组，不是配网键。AP状态灯慢闪，云端在线常亮。
- TuyaApp 上电不运动，不启动音乐、本地摇杆、ADC或EEPROM业务。

## 电机与DP行为

产品定义：`vendor/tuya/raw/2026-07-16/product/revision-dp-step1/Debugfile_拉珠式窗帘开关器_20260716.json`。

| 项目 | 当前行为 |
|---|---|
| DP1 open=0 / close=2 | 接入现有驱动，每次最多2s，含唤醒时间 |
| DP1 stop=1 | 先关闭驱动，再回报stop；解除同方向重复命令锁 |
| DP1 continue=3 | 不支持，拒绝 |
| DP2百分比目标 | 暂不执行、不确认目标，等待行程标定 |
| DP101当前位置 | 不上报未知位置；禁止占位0、假报100或以定时停机代替到位 |

重复同方向命令不延长运行时间，限时结束后相同命令不能再次启动，先点停止再试。运行中反向命令只停机，不立即反转。nFAULT、250ms主循环失活、2s截止保护保留；离线状态、串口错误或溢出、配网操作触发停机。通信错误锁定运动直到STM32重启。

App百分比自行回到0不代表机械实际位置。当前无有效位置反馈，不能据此认定关功能通过。

## 验证结论和工具

已验证基线：Flash完整回读、JSON/SDK解析与坏帧恢复、实体5s配网、App联网。实板诊断通过主动停止后脉冲计数不变、反向互锁、250ms主循环失活停机、2s截止和重复命令限制。用户确认App“开→中途停止”有效；App关尚未验证。nFAULT分支仅做软件状态机测试，未人为制造电气故障；计数不能证明机械位置。

- `tuya_app_status.py --elf <与实板匹配的ELF> --probe <UID>`：读运行状态，不复位。
- `tuya_protocol_check.py --elf ... --probe ... --product <JSON>`：隔离SDK和按钮测试，禁止运动，结束会复位；需匹配实板ELF。
- `tuya_motion_check.py --port COM3 --allow-motion`：真实运动测试，仅在机械条件允许时执行。默认不打开串口；清理时尝试停止，即使停止回读失败也保存已有日志。
- 诊断串口单字符逐条发送并等应答：S网络、M电机、X停止、F/B限时开/关、T禁能自检、H主循环阻塞测试；P/E/R分别为AP/EZ/重置Wi-Fi。
- `bridge_transport_check.py`只用于透明桥版本。

## 机械完成后继续

1. 确认安装方向、载荷、开关方向和到位传感器电气定义，先验证停止及故障保护。
2. 验证上下到位检测、抖动、断线和异常组合；不能直接把驱动nFAULT当到位信号。
3. 标定有效行程，设计标定持久化、掉电恢复和位置失效处理。
4. 有可信位置后接入DP2定位和DP101回报，覆盖中途停止、反转、端点和App按钮状态。
5. 再根据实测行程调整2s联调限制及运行超时，完成带载验收。
