XJH-Jorhai/automatic-curtain-lifter/docs/04-component-selection.md

# 初步器件选型与功耗预算

当前首版原理图的实装料号、阻容归并和保留理由见[原理图器件审查](../hardware/schematic-review/BOM-review.md)。下表仍包含架构阶段的候选项。

## 候选器件（电机类型、SDK/GPIO 与机械参数均待确认）

| 功能 | 首选 | 备选/说明 |
|---|---|---|
| 当前无线通信 | 涂鸦 T1-3S Wi-Fi & Bluetooth（T1-CHL） | 控制台为当前窗帘 PID 推荐；用户 UART 使用 RX1/TX1，模组只负责配网、App、云通信和模组 OTA |
| 未来米家通信 | 小米官方通用 Wi-Fi+BLE 模组 + UART 协议 | 需企业/服务商确认；不让通信模组承担实时运动安全逻辑 |
| 首版主控 | STM32G030C8T6，C529329，LQFP-48 | 用户已定首版沿用 G030；不再以更换 G031/G071 作为首版原理图前置条件。运动固件和资源占用仍须验证 |
| 电机 | 首轮候选：雷赛 42CM02-1A，两相 42 mm、1 A/相、约 0.2 N·m 保持扭矩 | 用户要求 42 步进并留 2–3 倍运行扭矩余量；链轮端估算 0.0257–0.0292 N·m，目标运行扭矩约 0.09 N·m。原厂参数已核实，**立创商城商品号和 12 V 目标速度下扭矩未核实**，见[实测估算](10-curtain-measurement-estimate.md)与[选型决策](09-motor-drive-decision.md) |
| 步进驱动裸芯片 | 首选 TI DRV8434ARGER，立创商城 C2866434；TMC2209-LA-T，C2150710 备选 | 均是供 PCB 贴装的芯片；DRV8434A 2.5 A 满量程相对候选电机 1 A/相约有 2.5 倍电流能力，但必须限流至电机规格。失速检测须实机验证，nFAULT 不能单独判机械到顶 |
| 直流减速驱动候选 | DRV8234 或同类 H 桥 | 可比较电流/堵转检测和纹波计数；启动电流与堵转阈值仍需实测 |
| 3.3 V 电源 | 首版原理图采用 TI LMR33630ARNXT 同步降压 | T1-3S 资料给出的工作电流最高典型值为 394 mA，叠加 STM32 和瞬态后 500 mA 方案余量不足；TPS62177 仅保留为分轨/验证备选 |
| 非易失运动数据 | Microchip AT24C16C-SSHM-T，C6480，16 Kbit I²C EEPROM，SOIC-8 | V3 原理图 U4 已替换原 C31082 FRAM；EEPROM 保留行程与安全停机记录，写入频率和掉电恢复策略见[系统架构](03-system-architecture.md)；网络凭据仍由 SDK NVS 管理 |
| DC 输入插座 | 讯普 DC-050-A250，C41429013，卧贴，6.4/2.5 mm，[原厂图纸额定 DC 24 V、3 A](https://item.szlcsc.com/datasheet/DC-050-A250/43280632.html) | 用户已在 V3 选用；与原 DC5521 插头不兼容。商城参数表误列 12 V、1 A，选型按原厂图纸；整机最大电流、插头匹配和接触温升仍须实测 |
| 输入保护 | F1 PTC + D1 SMBJ15A TVS | 用户已移除 Q1/R3/D3 防反接支路；适配器固定中心正极，保护参数仍须按浪涌和电机回灌实测复核 |
| 位置基准与首版验证硬件 | DRV8434A 扭矩计数；保留 U7 通用反馈扩展口 | G030 PA0 读取 `TRQ_CNT/STL_TH`，首板实测上端触顶、下端反卷和中途卡阻的波形与真实帘布位置。扭矩计数是运动负载指标，不是绝对扭矩；下端判据及阈值待真实机构验证。首版不装 HX711、应变桥及其导轮结构 |
| 本地开关 | 源丰 `MT-0-123-D001-D000-LF`，C22448935，3 脚 3 档双复位钮子开关 | U6 中脚接地，1 脚 `KEY_DOWN`→PC7、3 脚 `KEY_UP`→PC6；两路各有 10 kΩ 上拉、100 nF 对地。实体拨向与脚号实测后由软件映射；无独立停止键 |
| 配网键 | SW1 轻触开关 | `NETCONTROL_BTN`→PC13，10 kΩ 上拉、100 nF 滤波；恢复出厂交互由固件定义 |
| 调试与扩展接口 | CN1 `SH-SM08B-GHS-TB(LF)(SN)` 8P、U7 `WAFER-GH1.25-4PWB` 4P | 均为 GH1.25；CN1 保留 SWD、MCU 复位、双向调试 UART，并以第 8 脚引出 `TUYA_CEN`；U7 为通用反馈扩展口。涂鸦烧录桥接方案见[接口说明](../hardware/schematic-review/tuya-programming-bridge.md) |
| 指示灯 | 12 V、3.3 V 电源灯各一颗，GPIO 工作状态灯一颗 | 首版为调试保留常亮电源灯；实测待机功耗时计入 |

DRV8424 的关键参数来自 [TI 产品页](https://www.ti.com/product/DRV8424)：4.5–33 V、2.5 A full-scale、2 µA sleep；其 nFAULT 不是堵转到位输出。[DRV8434A 产品页](https://www.ti.com/product/DRV8434A)列出无传感器堵转检测和 2 µA sleep。[DRV8234 产品页](https://www.ti.com/product/DRV8234)列出有刷直流电机的电流检测、堵转检测和纹波计数。上述功能均须在本项目机构上实测。TPS62177 的关键参数来自 [TI 产品页](https://www.ti.com/product/TPS62177)：28 V 输入、500 mA、22 µA 正常静态电流和 4.8 µA sleep；但它不再是 T1-3S 与 STM32 共用 3.3 V 主电源的默认首选。

## 步进驱动候选的取舍

- A4988 适合廉价样机，但微步噪声、保护、低功耗和电流调节体验不如新器件。
- TMC2209 静音和生态很好，但本项目的 `<100 mW` 联网静息指标很紧。DRV8424 和 DRV8434A 都需按休眠功耗、回零检测与实际电机表现比较，不能只按 2 µA sleep 决定。
- 最终驱动仍取决于步进电机相电流、散热、噪声和上端回零检测；若步进路线的关键要求无法满足，再评估直流减速备选。

## 初步静息功耗

12 V 下限是 8.33 mA。下表是架构预算，不是合格证明：

下表原为单 SoC 参考预算。当前“通信模组 + STM32”双芯片路线必须重新实测，不能将 ESP32-C3 单 SoC 数值作为合格依据；涂鸦 PoC 应分别记录通信模组、STM32 子系统和整机功耗。2026-09-25 的联网台架测试未测量功耗。

| 负载 | 估算/目标 | 折算 12 V 输入功率 |
|---|---:|---:|
| ESP32-C3 Wi-Fi modem-sleep | 约 20 mA @ 3.3 V | 约 78 mW（按 Buck 85%） |
| Buck 自耗 | 22 µA @ 12 V | 0.26 mW |
| 电机驱动休眠 | 目标量级约 2 µA @ 12 V，待具体型号确认 | 约 0.024 mW |
| EEPROM、上拉、按键、保护漏电 | 目标合计 <0.5 mA @ 3.3 V | <2 mW |
| GPIO 状态 LED | 静息关闭 | 0；首版两颗常亮电源 LED 须另计并实测 |
| **设计目标合计** | 预留云通信突发余量 | **平均 <90 mW** |

乐鑫官方示例给出的 ESP32-C3 单 Wi-Fi modem-sleep 平均约 20 mA，light-sleep 可低至约 130 µA；但小米 SDK 是否允许自动 light-sleep 且保持云端响应必须实测，不能直接拿芯片数字承诺整板功耗。[Espressif ESP-AT 低功耗示例](https://docs.espressif.com/projects/esp-at/en/release-v2.3.0.0_esp32c3/AT_Command_Examples/sleep_at_examples.html)

因此 `<100 mW` 是高风险指标：单 SoC + 驱动硬关断有机会达到；双芯片方案或未启用 Wi-Fi power-save 很可能失败。用户已移除 0.1 Ω 串联采样电阻；首块样机仍须用外部仪表分别测量未配网、已联网空闲、云端轮询、OTA、BLE 配网和电机运行状态。

## 电源与布局硬要求

T1-3S 规格书确认：3.0–3.6 V 供电，配网/联网/弱网场景的最高典型电流达到 394 mA。台架阶段给模组使用独立 3.3 V、至少 500 mA 电源并建议留到 600 mA 级以上余量；v1 PCB 的共用 3.3 V Buck 按不低于 1 A 选型。模组近端放置 100 nF、10 µF，并预留 100 µF 级低 ESR 储能，最终按示波器波形定值。

小米 MHCWB5G 模组资料要求 3.3 V 电源至少 500 mA、发包时纹波小于 100 mV，并建议电机大电流回流与模组回流分开后单点连接。[小米 MHCWB5G 模组资料](https://manuals.plus/m/86494d7f18149d688114688e4bde327b3403284234d8b8c0e372e7df307eb6de.pdf)

- 12 V 电机电源和 3.3 V 无线电源分区；星形/受控单点回流。
- 模组置于板边，天线净空区无铜、无齿轮/电机/金属外壳遮挡。
- T1-3S 天线与金属件至少保持 15 mm 距离；天线区域不得走线或覆铜。
- VM 入口与驱动旁配置低 ESR 电解/聚合物电容，吸收电机电流脉动和回灌。
- 驱动使能/休眠引脚的硬件默认态应关闭电机输出，MCU 复位或崩溃时不得误动作。
- 软件行程由 MCU 本地执行；基本停止、驱动故障和供电保护不依赖云端。
