XJH-Jorhai/automatic-curtain-lifter/hardware/schematic-review/BOM-review.md

# 首版原理图器件与阻容归并审查

审查对象：`Curtain_Lifter_Mainboard_RevA` 四页原理图。以下“已落实”和“保留的阻容值”记录的是迁入 V3 时的历史归并过程，**不能直接当作当前 BOM**。2026-10-11 当前器件以[最新 V3 网表](Curtain_Lifter_Mainboard_v3.enet)为准：66 个带位号器件；PA1 的 12 V 采样已删除；现有 R10/R11 是钮子开关两路 10 kΩ 上拉，C20/C28 为两路 100 nF 滤波，U6 是 MT-0-123 双向复位开关，SW1 是独立配网键。CN1 与 U7 已改为 GH1.25，CN1.8 接 `TUYA_CEN`。LED1/LED2 为首版保留的常亮电源灯。当前降压输出 C24–C27 为 22 µF、16 V、1206，不是下文历史记录中的 C5–C8/0805。下文关于 R10/R11 作为 12 V 分压及 ADC 换算系数 11 的文字只描述旧版，不适用于当前原理图。

## 2026-10-09 V3 历史变更

| 位号 | 当日器件/状态 | 说明 |
| --- | --- | --- |
| DC1 | 讯普 `DC-050-A250`，C41429013，卧贴 SMD | 用户更换；6.4/2.5 mm，[原厂图纸额定 DC 24 V、3 A](https://item.szlcsc.com/datasheet/DC-050-A250/43280632.html)，商城 12 V、1 A 字段有误；非原 DC5521，插头匹配和整机最大电流仍待实测 |
| J1 | 已移除 | 原 `DC-005-5.5*2.1` 不再实装 |
| Q1/R3/D3 | 已移除 | 用户取消防反接 MOS、栅极下拉与钳位支路；不再把 Q1 列为当前器件 |
| F1/D1/R19 | 当日保留 | 当日输入路径 `DC1 → F1 → R19 → 12V_PROT`；此后用户删除了 0.1 Ω 采样位，当前路径是 `DC1 → F1 → 12V_PROT`；D1 TVS 位于 F1 后端对地 |
| U4 | Microchip `AT24C16C-SSHM-T`，C6480，SOIC-8 | 替换原 C31082 FRAM；为 16 Kbit I²C EEPROM，断电保留行程，写入频率须按寿命调整 |

当日 V3 共 58 个带位号器件，替换 U4 前后 46 组网络的引脚集合完全一致。以下旧版审查中的 Q1/R3/D3 与 FRAM 内容只供追溯。

## 历史归并记录

| 位号 | 原器件/数值 | 现器件/数值 | 目的 |
| --- | --- | --- | --- |
| Q1 | AO3401A | CJ（长晶）CJ3401，C13799，SOT-23 | 统一 P-MOS 料号；1/2/3 脚分别保持 G/S/D 原连接 |
| Q2 | BSS138 | CJ（长晶）CJ3400，C19019，SOT-23 | 统一 N-MOS 料号；1/2/3 脚分别保持 G/S/D 原连接 |
| R3、D3 | 100kΩ 栅极下拉，无栅源钳位 | 10kΩ C25804；新增 9.1V 稳压二极管 BZT52C9V1 C707139 | 项目输入范围 9–15V；CJ3401 的 Vgs 额定值 ±12V，D3 阴极接源极、阳极接栅极 |
| R10/R11 | 220kΩ/33kΩ | 100kΩ C25803 / 10kΩ C25804 | 统一阻值，同时降低 12V 采样 ADC 在输入浪涌时的电压 |
| R12/R13 | 4.7kΩ | 10kΩ C25804 | 板内短距离 MCU–EEPROM I²C 总线，按 100kHz 标准模式使用 |

12V 采样新的分压比为 **1/11**，9V、12V、15V 输入分别对应约 0.818V、1.091V、1.364V。固件换算系数必须同步改为 11。I²C 上拉 10kΩ 时，按 100pF 总线电容估算的 30–70% 上升时间约 0.85µs；PCB 完成后应核对总线电容和上升时间。若改用 400kHz 或电容明显增大，应重新选上拉电阻。

## 保留的阻容值

| 位号 | 值与封装 | 保留理由 |
| --- | --- | --- |
| C5–C8 | 4×22µF，0805 | [TI LMR33630 数据手册](https://www.ti.com/lit/ds/symlink/lmr33630.pdf)的 400kHz、3.3V 典型设计采用 4×22µF；直接改为 4×10µF 会降低输出储能和瞬态性能。投板前还需按所选 MLCC 的直流偏压曲线复核有效电容。 |
| C3、C4 | 1µF、100nF，0603 | LMR33630 的 VCC 去耦与 BOOT 电容，按芯片要求保留。 |
| C9/C10、C12、C13、C14 | 10nF×2、1µF、22nF、220nF，0603 | [TI DRV8434A 数据手册](https://www.ti.com/lit/ds/symlink/drv8434a.pdf)分别规定 VM 高频旁路、DVDD 去耦、充电泵飞跨及储能电容，不能按一般去耦统一改为 100nF/10µF。 |
| C11、C23 | 100µF 插件电容 | 驱动供电和无线模组的局部储能；不以单颗 10µF 替代。 |
| C15 | 1nF，0603 | 驱动器 `TRQ_CNT` 信号的滤波电容；改为 100nF 会明显改变信号边沿，保持现值待样机验证。 |
| R2、R4/R5、R15、R19 | 43kΩ、56kΩ/21kΩ、1kΩ、100mΩ | 分别承担降压反馈、电机电流设定、LED 限流及输入电流采样；改变数值会改变目标功能。R19 为 2512 功率电阻。 |

已用的 **10µF 均为 0805、C15850**；普通 100nF 为 0603、C14663；普通信号电阻为 0603。22µF 输出电容、100µF 插件电容和 2512 采样电阻按电气需求保留较大封装。当前原理图没有肖特基二极管：D1 是 TVS，D2 是状态 LED；历史 D3 已移除。若后续增加肖特基，指定商城器件为 **CJ B16WS，C77282**，不能用它替代 D1。

## 核对

历史 V2/V3 迁移时整板网表共 65 个带位号器件；2026-10-09 替换 U4 后为 58 个。2026-10-11 最新 V3 网表为 66 个。重新打开并逐页运行严格原理图 DRC 后，四页均返回空结果（0 条错误、0 条警告）；此前显示的一条警告未复现。
