XJH-Jorhai/automatic-curtain-lifter/hardware/release-2026-10-25/mainboard-bom-as-built.csv

No. | Quantity | Comment | Designator | Footprint | Value | Manufacturer Part | Manufacturer | Supplier Part | Supplier
1 | 2 | 10uF | C1,C11 | C1206 | 10uF | HGC1206R7106K500NSPJ | Chinocera(华瓷) | C33546013 | LCSC
2 | 9 | 100nF | C2,C4,C16,C19,C20,C21,C28,C29,C30 | C0603 | 100nF | CC0603KRX7R9BB104 | YAGEO(国巨) | C14663 | LCSC
3 | 2 | 1uF | C3,C12 | C0603 | 1uF | CL10A105KB8NNNC | SAMSUNG(三星) | C15849 | LCSC
4 | 3 | 10uF | C6,C17,C18 | C0805 | 10uF | CL21A106KAYNNNE | SAMSUNG(三星) | C15850 | LCSC
5 | 2 | 12pF | C7,C8 | C0603 | 12pF | CC0603JRNPO9BN120 | YAGEO(国巨) | C107034 | LCSC
6 | 2 | 10nF | C9,C10 | C0603 | 10nF | CL10B103KB8NNNL | SAMSUNG(三星) | C16194318 | LCSC
7 | 1 | 22nF | C13 | C0603 | 22nF | CL10B223KB8NNNC | SAMSUNG(三星) | C21122 | LCSC
8 | 1 | 220nF | C14 | C0603 | 220nF | CL10B224KA8NNNC | SAMSUNG(三星) | C21120 | LCSC
9 | 1 | 1nF | C15 | C0603 | 1nF | CL10B102KB8NNNC | SAMSUNG(三星) | C1588 | LCSC
10 | 1 | 470uF | C22 | CAP-SMD_BD10.0-L10.3-W10.3-LS11.0 | 470uF | JVJ35V470M10x10 | JIERR(捷而瑞) | C46550413 | LCSC
11 | 6 | 22uF | C23,C24,C25,C26,C27,C31 | C1206 | 22uF | FCC1206X226K160HT | FOJAN(富捷) | C5137635 | LCSC
12 | 1 | SH-SM08B-GHS-TB(LF)(SN) | CN1 | CONN-SMD_SH-SM08B-GHS-TB |  | SH-SM08B-GHS-TB(LF)(SN) | SHOU HAN(首韩) | C42376901 | LCSC
13 | 1 | DB2ERM-5.08-4P-GN | CN2 | CONN-TH_4P-P5.08_DB2ERM-5.08-4P |  | DB2ERM-5.08-4P-GN | DORABO(地博电气) | C395755 | LCSC
14 | 1 | SMBJ15A | D1 | SMB_L4.6-W3.6-LS5.3-RD |  | SMBJ15A | DOWO(东沃) | C357961 | LCSC
15 | 1 | DC-050-A250 | DC1 | DC-IN-SMD_DC-050-A200 |  | DC-050-A250 | XUNPU(讯普) | C41429013 | LCSC
16 | 1 | 1206L200/16NR | F1 | F1206 |  | 1206L200/16NR | LUTE(陆特) | C22374899 | LCSC
17 | 1 | 6.8uH | L2 | IND-SMD_L11.0-W10.0_MDA1054HT | 6.8uH | MWSA1004S-6R8MT | Sunlord(顺络) | C408485 | LCSC
18 | 3 | XL-1608UBC-04 | LED1,LED2,LED3 | LED0603-RD_BLUE |  | XL-1608UBC-04 | XINGLIGHT(成兴光) | C965807 | LCSC
19 | 1 | CJ3400 | Q2 | SOT-23_L2.9-W1.3-P1.90-LS2.4-BR |  | CJ3400 | CJ(江苏长电/长晶) | C19019 | LCSC
20 | 2 | 100kΩ | R1,R16 | R0603 | 100kΩ | 0603WAF1003T5E | UNI-ROYAL(厚声) | C25803 | LCSC
21 | 1 | 43kΩ | R2 | R0603 | 43kΩ | 0603WAF4302T5E | UNI-ROYAL(厚声) | C23172 | LCSC
22 | 1 | 4.7kΩ | R6 | R0603 | 4.7kΩ
23 | 10 | 10kΩ | R3,R7,R8,R9,R10,R11,R12,R13,R14,R17 | R0603 | 10kΩ | 0603WAF1002T5E | UNI-ROYAL(厚声) | C25804 | LCSC
24 | 1 | 30kΩ | R4 | R0603 | 30kΩ
25 | 1 | 21kΩ | R5 | R0603 | 21kΩ | 0603WAF2102T5E | UNI-ROYAL(厚声) | C22956 | LCSC
26 | 2 | 2kΩ | R15,R19 | R0603 | 2kΩ | 0603WAF2001T5E | UNI-ROYAL(厚声) | C22975 | LCSC
27 | 1 | KH-6X6X5H-STM | SW2 | SW-SMD_4P-L6.0-W6.0-P4.50-LS9.0_H5.0 |  | KH-6X6X5H-STM | kinghelm(金航标) | C2837531 | LCSC
28 | 1 | LMR33630ARNXT | U1 | VQFN-12_L3.0-W2.0-P0.65-BL_TI_LMR33630XRNXT |  | LMR33630ARNXT | TI(德州仪器) | C2071058 | LCSC
29 | 1 | DRV8434ARGER | U2 | VQFN-24_L4.0-W4.0-P0.50-TL-EP2.5 |  | DRV8434ARGER | TI(德州仪器) | C2866434 | LCSC
30 | 1 | STM32G030C8T6 | U3 | LQFP-48_L7.0-W7.0-P0.50-LS9.0-BL_1 |  | STM32G030C8T6 | ST(意法半导体) | C529329 | LCSC
31 | 1 | AT24C16C-SSHM-T | U4 | SOIC-8_L4.9-W3.9-P1.27-LS6.0-BL |  | AT24C16C-SSHM-T | MICROCHIP(美国微芯) | C6480 | LCSC
32 | 1 | T1-3S | U5 | WIFIM-SMD_22P-L24.0-W16.0-P2.00_TI-3S |  | T1-3S |  | C9900198004 | LCSC
33 | 2 | WAFER-GH1.25-4PWB | U6,U7 | CONN-SMD_4P-P1.25_XUNPU_WAFER-GH1.25-4PWB |  | WAFER-GH1.25-4PWB | XUNPU(讯普) | C3029379 | LCSC
34 | 1 | 8MHz | X1 | CRYSTAL-SMD_4P-L3.2-W2.5-BL | 8MHz | X32258MOB4SI | YXC(扬兴晶振) | C2682775 | LCSC
