XJH-Jorhai/automatic-curtain-lifter/hardware/sheelandholder/mainboard.step

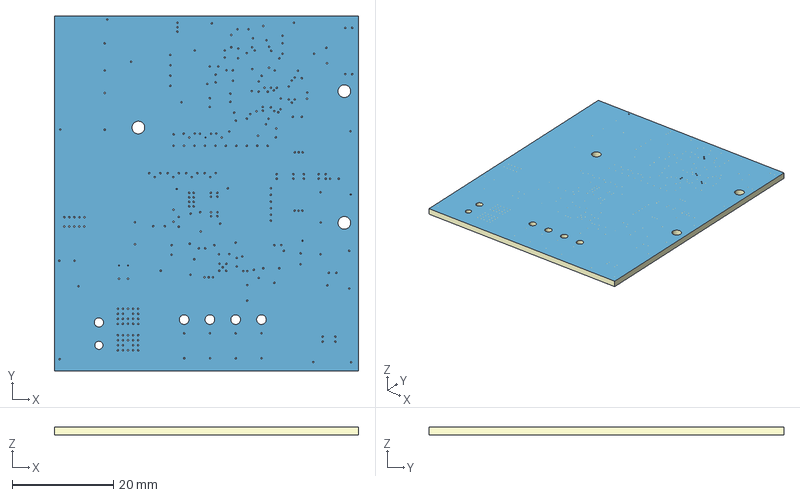
[picture p3: CAD file, 2026-10-25]
hardware/sheelandholder/mainboard.step
60.0 x 70.0 x 1.60 mm
Board~NoOD
TopCopper~NoOD
BottomCopper~NoOD
TopSilkscreen~NoOD
BottomSilkscreen~NoOD
TopFpcStiffener~NoOD
BottomFpcStiffener~NoOD
