XJH-Jorhai/automatic-curtain-lifter/hardware/mechanical/架子.STEP

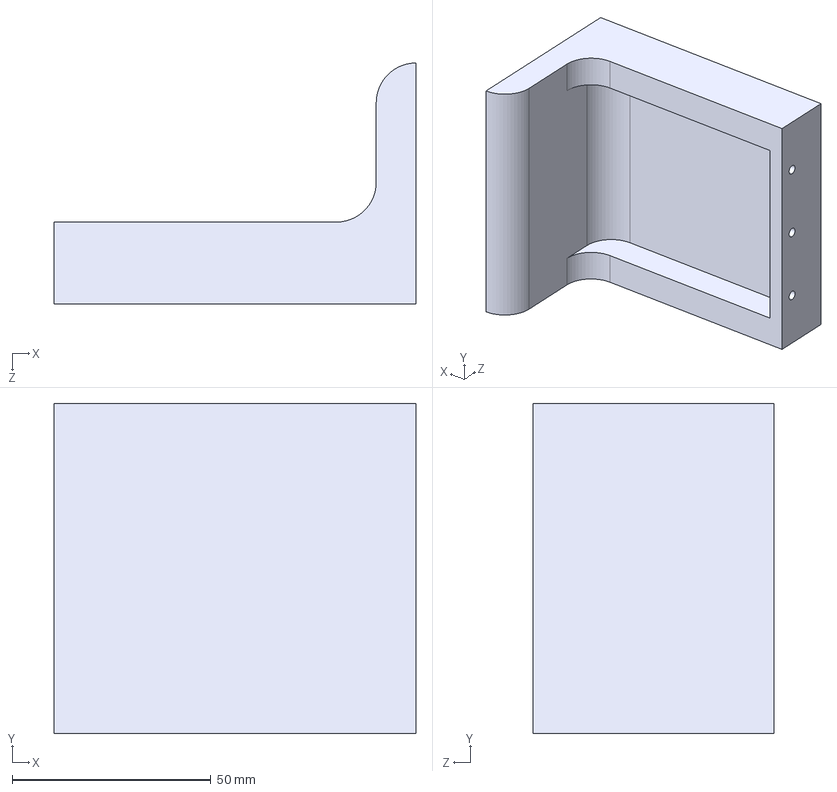
[picture p4: CAD file, 2026-10-25]
hardware/mechanical/架子.STEP
91.0 x 83.0 x 60.6 mm
