XJH-Jorhai/automatic-curtain-lifter/hardware/Parametric ball chain pulley - 3147/files/history/parametric_ball_pulley_31slots.stl

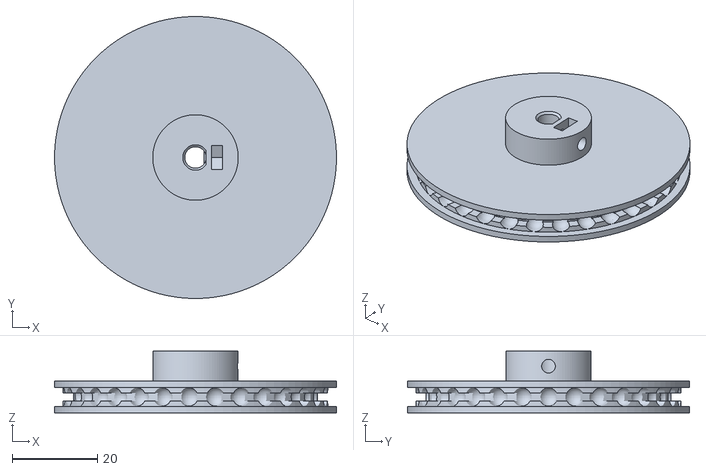
[picture p5: CAD file, 2026-10-25]
hardware/Parametric ball chain pulley - 3147/files/history/parametric_ball_pulley_31slots.stl
66.0 x 66.0 x 14.4
