XJH-Jorhai/automatic-curtain-lifter/hardware/mechanical/壳子.STEP

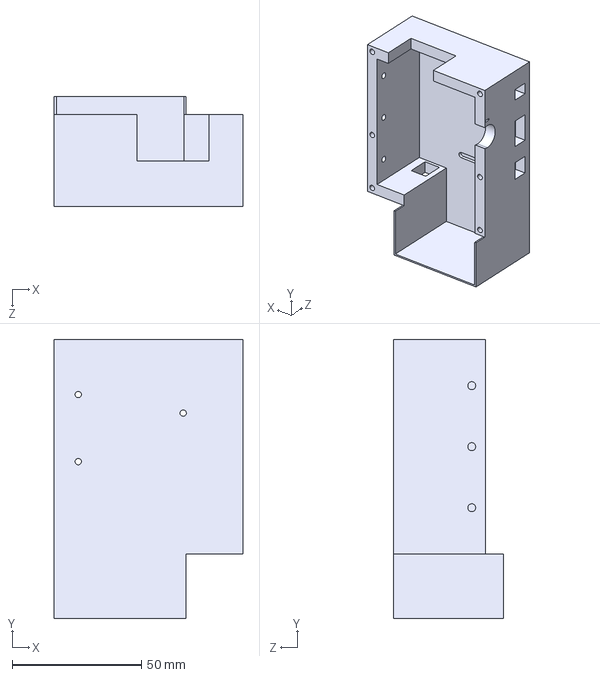
[picture p7: CAD file, 2026-10-25]
hardware/mechanical/壳子.STEP
73.0 x 108.0 x 42.6 mm
