XJH-Jorhai/automatic-curtain-lifter/hardware/sheelandholder/parametric_ball_pulley_9slots.stl

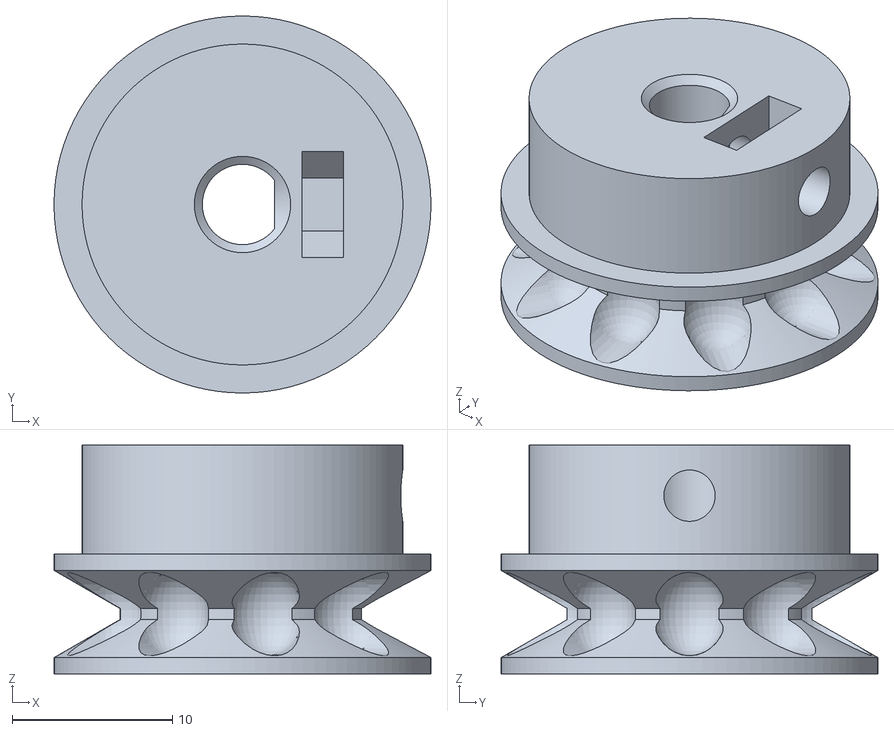
[picture p9: CAD file, 2026-10-25]
hardware/sheelandholder/parametric_ball_pulley_9slots.stl
23.5 x 23.5 x 14.3
