XJH-Jorhai/automatic-curtain-lifter/hardware/mechanical/盖子.STEP

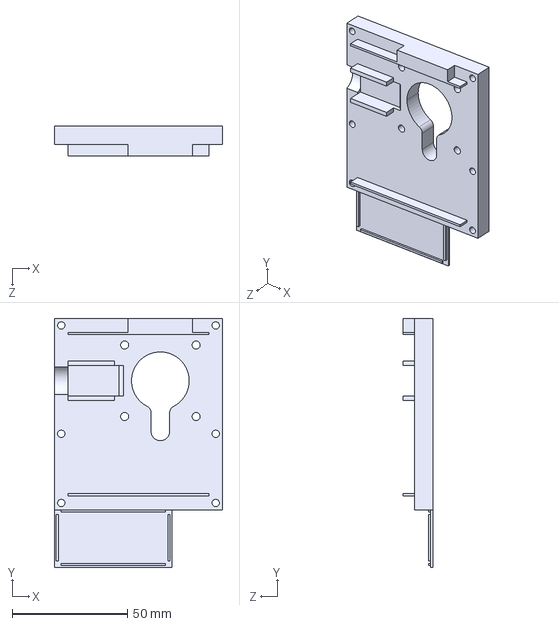
[picture p10: CAD file, 2026-10-25]
hardware/mechanical/盖子.STEP
73.0 x 108.0 x 13.0 mm
