XJH-Jorhai/automatic-curtain-lifter/hardware/Parametric ball chain pulley - 3147/files/parametric_ball_pulley_clamp.stl

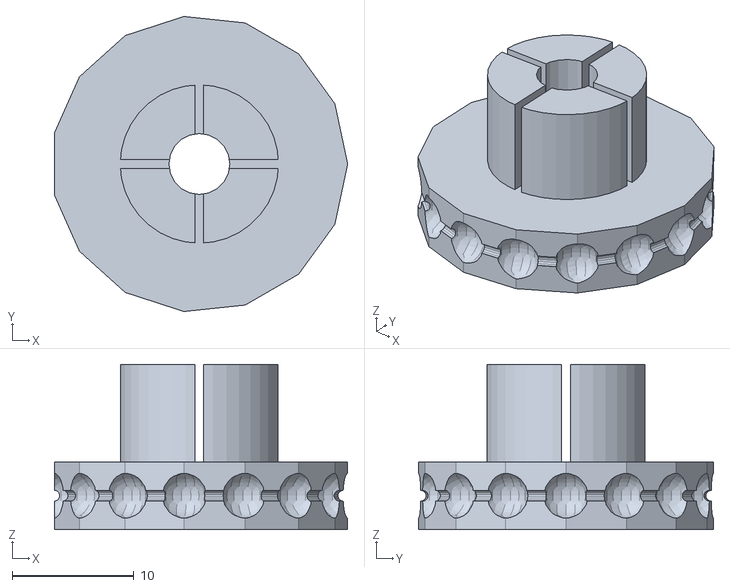
[picture p11: CAD file, 2026-10-25]
hardware/Parametric ball chain pulley - 3147/files/parametric_ball_pulley_clamp.stl
24.1 x 24.2 x 13.6
