XJH-Jorhai/automatic-curtain-lifter/hardware/mechanical/enclosure.3mf

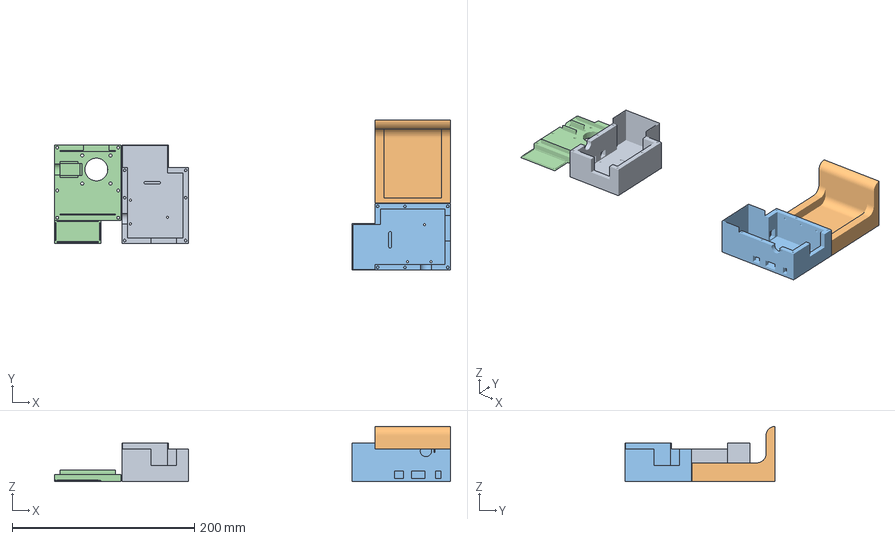
[picture p12: CAD file, 2026-10-25]
hardware/mechanical/enclosure.3mf
434.7 x 165.0 x 60.6 mm
零件5^main.STL x 4
