XJH-Jorhai/automatic-curtain-lifter/hardware/Parametric ball chain pulley - 3147/files/parametric_ball_pulley.stl

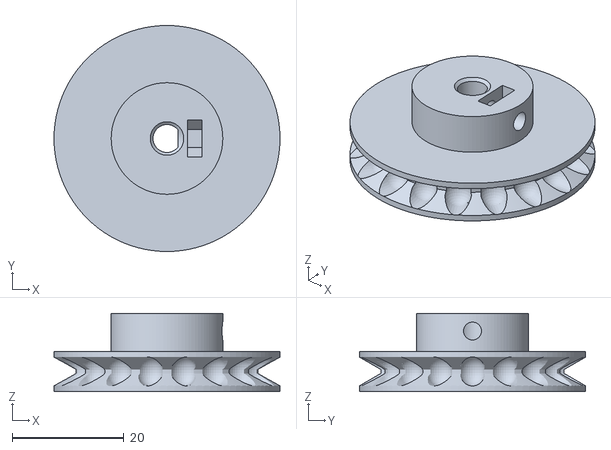
[picture p13: CAD file, 2026-10-25]
hardware/Parametric ball chain pulley - 3147/files/parametric_ball_pulley.stl
40.5 x 40.5 x 14.0
