XJH-Jorhai/automatic-curtain-lifter/(list of files, cad)

Other CAD files:
hardware/Parametric ball chain pulley - 3147/files/parametric_ball_pulley_31slots.scad
hardware/Parametric ball chain pulley - 3147/files/parametric_ball_pulley_9slots.scad
hardware/Parametric ball chain pulley - 3147/files/history/parametric_ball_pulley_before_fit_clearance.scad
