XJH-Jorhai/automatic-curtain-lifter/docs/10-curtain-measurement-estimate.md

# 卷帘拉珠实测与首轮负载估算（2026-09-25）

## 输入数据及置信度

| 项目 | 用户提供的数值 | 置信度 | 含义/限制 |
|---|---:|---|---|
| 拉珠最大拉力计读数 | 0.75–0.85 kgf | 中 | 按拉拽式称的“公斤力”解释；尚未记录测量方向、位置、速度与重复次数，“最大”仍待复测。 |
| 拉珠直径 | 4 mm | 较高 | 用户称较为准确；不等于链轮节圆直径。 |
| 拉珠中心间距 | 6 mm | 较高 | 可用于按链轮容纳的珠数估算节圆周长。 |
| 链轮珠心轨迹直径 | 约 7 mm | 中 | 用户确认按拉珠中心测量；有效半径约 3.5 mm。直径仍为大概测量值。 |
| 局部位移 | 拉珠 20 cm → 帘布升降约 5.5 cm | 中低 | 仅代表这次测量位置附近的局部比例；卷起过程中卷筒有效半径会变化。 |
| 帘布全行程 | 约 2.5 m | 低到中 | 按垂直升降高度理解；有待实际测量上下端。 |

## 可直接计算的量

拉力计读数若为 kgf，按 `1 kgf = 9.80665 N`，得到 **7.35–8.34 N**。换算系数见 [NIST](https://www.nist.gov/pml/special-publication-811/nist-guide-si-appendix-b-conversion-factors/nist-guide-si-appendix-b9)。单位换算本身确定，但实际最大拉力的置信度仍取决于上表的测量条件。

局部位移比 `s_chain / s_shade = 20 / 5.5 ≈ 3.64`。拉珠移动 20 cm 约经过 `200 / 6 ≈ 33` 个珠距，相当于本次测量位置附近**每个珠距约 1.65 mm 帘布位移**。换算算术确定，作为全行程比例的置信度低。

若错误地把该局部比值视为全程常数，2.5 m 帘布会对应 `2.5 × 3.64 ≈ 9.1 m` 拉珠行程，约 1515 个珠距。**这只是演示性的外推，置信度很低，不能用于电机转数、行程存储或黑珠周期设计。** 卷筒卷径随帘布收起而变化，且局部测量位置未知；下一次应直接从下端到上端测总拉珠位移。

## 链轮扭矩：按珠心轨迹直径估算

在拉珠驱动链轮处，首轮估算为 `T ≈ F × r_eff`，其中 `r_eff` 是链轮对拉珠的有效作用半径。用户确认 **7 mm 是按拉珠中心测量的直径**，故 `r_eff ≈ 3.5 mm`，以 7.35–8.34 N 计算得 **0.0257–0.0292 N·m（2.57–2.92 N·cm）**。这组乘法的算术置信度高；作为真实链轮最大扭矩的置信度为中：珠心直径是粗测值，最大拉力的测量条件也待复测。

按等间隔珠槽作几何检查：若一圈有 3 个珠槽，相邻珠心之间 6 mm 为圆的弦长，则珠心轨迹直径为 `6 / sin(60°) ≈ 6.93 mm`，与粗测的 7 mm 接近。这提示链轮**可能**是 3 槽结构，但珠槽数尚未实际数过。小链轮的弦长与弧长差别明显，不能把珠距简单乘以珠槽数再当成节圆周长。标记链轮转一整圈、测拉珠线位移 `s_rev`，可独立复核实际传动关系；珠槽几何也会使上述扭矩只是首轮估算。

作为尺寸敏感性参考，若另一只链轮实测一圈拉珠位移分别为 48、60、72 mm，按 `r_eff ≈ s_rev / (2π)` 会得到下表。它们不是当前链轮的规格：

| 假设的一圈拉珠位移 | 估计有效半径 | 对应链轮扭矩 `F × r_eff` |
|---:|---:|---:|
| 48 mm | 约 7.6 mm | 约 0.056–0.064 N·m |
| 60 mm | 约 9.5 mm | 约 0.070–0.080 N·m |
| 72 mm | 约 11.5 mm | 约 0.084–0.096 N·m |

扭矩尚未计启动、加速、齿轮效率、不同位置负载和制造余量；不能据此直接挑步进电机。若拉拽式称测的是单侧链条张力而不是两侧张力差，`F × r_eff` 还只是对链轮负载的近似。电机轴所需扭矩还取决于传动比和传动效率。

## 下一组最有价值的测量

1. 在现有链轮或打算用于电机的拉珠轮上做一处记号，**完整转一圈**，量对应的拉珠线位移 `s_rev`，并记下珠数；复核约 7 mm 的珠心轨迹直径。
2. 用相同拉力计，在上卷和下放方向各选上、中、下三个位置，缓慢、匀速重复测几次；把起步峰值和持续运动读数分开。
3. 从帘布最下端到最上端，直接累计拉珠总移动长度或链轮圈数；同时确认帘布全行程。
4. 确认步进驱动休眠、电机不提供保持力时，卷帘在中间位置是否稳定停住。

完成前两项后可给出链轮的实测扭矩范围；再结合目标开合时间、传动比和步进电机的**运行速度—扭矩曲线**筛选型号。静态保持扭矩不能代替运行扭矩。

## 2026-10-21 实装打印轮更新（取代实装轮7mm假设）

用户提供当前参数化模型：ball_spacing=6mm，max_pull_kgf=0.85，load_torque_limit=0.15Nm。
按其OpenSCAD公式得到18珠、珠心直径34.5526mm，首轮最大负载估算0.144009Nm（不含加速/未测摩擦）。
该模型的0.15Nm只是轮尺寸选择输入，不能证明电机有此运行扭矩。实装轮负载约为原7mm假设的4.936倍。
原0.09Nm运行目标不足以覆盖此轮0.144Nm负载；若沿用2–3倍余量，轮端目标约0.288–0.432Nm。
用户报告电机1.8°/1.5A、保持转矩读数0.21（单位及测试励磁条件待核实）；约1A满量程设置、15rpm仍上卷堵转。
需以VREF、实际供电/绕组电流及实物拉力验证，再决定缩小轮径或增设减速，不以保持转矩替代运行转矩。
