XJH-Jorhai/automatic-curtain-lifter/docs/validation-status.md

# 验证状态与证据

统计基线：2026-10-25 Product v15。下表引用仓库现有记录；本次文档整理没有重新进行硬件测试。

| 项目 | 证据 | 结论与边界 |
|---|---|---|
| GPIO/UART/ADC/EEPROM | [10-20 基础检查](../hardware/test-records/2026-10-20-mainboard-basic-functions.md) | 实板基础功能记录，不代替后续整机验收 |
| 本地与 App 开停关、定位 | [v12](../hardware/test-records/2026-10-25-product-v12.md)、[v13](../hardware/test-records/2026-10-25-product-v13.md) | 用户确认操作、目标/进度分离及校准功能 |
| 重启物理参考与校准坐标 | [v14](../hardware/test-records/2026-10-25-product-v14.md) | 用户验收通过；不同后续微调记录不自动视为都做过复位测试 |
| 持续微调、松手停止 | [v15](../hardware/test-records/2026-10-25-product-v15.md) | 用户反馈正常；观察窗口未完整独立测得越过旧配额的实物位移 |
| 主机逻辑回归 | [v15 测试日志](../hardware/test-records/2026-10-25-product-v15-tests.txt) | 真实业务代码+模拟外设；含越界返回、无自动保存及参考迁移 |
| TRQ 检测 | [v8 波形记录](../hardware/test-records/2026-10-25-trq-filter-v8.md) | 本样机工况有效；约 90 ms 为信号下降到停止，不是机械碰撞到停止的标定 |
| v15 烧录与保存 | [v15 部署记录](../hardware/test-records/2026-10-25-product-v15.md) | 完整 Flash 读回及重启复查；首次 UART 错误经一次空闲复位消除，原因未在本次修复 |

已有 v15 冻结镜像记录：BIN 33020 字节，RAM 5640/8192 字节；BIN SHA256 为 `6c69ccad777fedccad6a9e1fbea392c148584ec80829aebc2da27050ba7f8a55`。该值识别当时产物，不承诺不同工具链/产品 SDK 仍得到相同二进制。

## 尚未建立发布结论的项目

- 全新电脑、仅公开文件及明确取得的依赖完成 Product 构建。
- 最终 PCB/实装 BOM/机械装配完整对应，最终 PCB 检查与制造包复核。
- 12 V 待机功率 ≤100 mW：属于早期目标，尚无当前整机合格证据。
- 电机/驱动器/电源/连接器长期温升与持续电流能力。
- 多种卷帘、链条松紧、卡滞、跳齿、下端反卷差异与寿命试验。
- 校准日志实际写入中断电、长期循环、电磁兼容及异常供电整机测试。
- 当前 UART 启动瞬态故障的可重复性与恢复策略验证。
- 米家正式接入：当前实现为涂鸦，不能宣传“已接入米家”。

对外应称“已完成当前样机功能验证，正在准备开源”，不能把单台样机验收扩展为量产可靠性或认证结论。

## 发布候选构建复核 · 2026-10-25

在独立候选目录清空构建输出后，以 Arm GNU 15.2 Rel1 和原本合法取得的外部 SDK 构建 Product 通过，完整产品主机回归通过；新增不依赖 SDK 的主机回归也通过。BIN 33020 字节，RAM 5640/8192，SHA-256 为 `6c69ccad777fedccad6a9e1fbea392c148584ec80829aebc2da27050ba7f8a55`，与既有 v15 一致。这不是第二台电脑/第二账户完整复现。本次未烧录或驱动硬件，不分发该含原产品 SDK 的二进制。
