XJH-Jorhai/automatic-curtain-lifter/hardware/schematic-review/calibration-revA.md

# RevA 自主校准硬件记录：TRQ_CNT 单通道

2026-10-10，嘉立创EDA V3 工程 `涂鸦智能家居产品-窗帘开关` / `Curtain_Lifter_Mainboard_RevA`。用户决定首版先用 DRV8434A 的扭矩计数信号验证自主校准。已从原理图删除 HX711、四线应变桥接口、专用供电开关及第五页；MCU 页删除相应三条信号线，并将 PB13/PB14/PB15 标为未使用。原有 J4 通用反馈扩展口保留。

## 校准信号链

| 用途 | 电路 | G030 连接 | 首版判据 |
|---|---|---|---|
| 上端原有限位 | DRV8434A `TRQ_CNT/STL_TH` 模拟扭矩计数 | PA0 / U3.11 | 受控低电流、有限步数内找失速候选，再往返复核 |
| 下端反卷顿挫 | 同一 `TRQ_CNT` 通道 | PA0 / U3.11 | 结合 STEP 时间戳与独立观察的帘布最低点，验证反卷负载特征及位置偏移 |
| 可选实验扩展 | 当前 U7 GH1.25 4P：3V3/GND/EXT_SENSOR_ADC/EXT_SENSOR_DIG（历史位号 J4） | PB10/PB11 | 当前校准方案不依赖该接口 |

`STL_MODE=GND` 选扭矩计数模式，`STL_REP=GND` 关闭芯片失速上报；U2.15 经 `DRV_TRQ_CNT` 接 U3.11，C15=1 nF 接该信号与 GND。`nFAULT` 仍用于驱动电气故障。该信号不是绝对扭矩值，低速时可能缺少辨识度；芯片采用四个电气半周期的移动平均，短促事件可能被平滑。[TI 数据手册](https://www.ti.com/lit/ds/symlink/drv8434a.pdf)及[应用笔记](https://www.ti.com/lit/an/slvaei3a/slvaei3a.pdf)。

当前 U2 `ENABLE` 经 R8=10 kΩ 下拉，复位默认禁能，但不能在 MCU 引脚高阻时使用驱动器的 8 倍扭矩计数缩放。先以现有配置实测；若目标速度下信号太小，应在投板前重新评估 R8 与上电禁能方式，而不是假定软件可以直接开启缩放。

## 实时网表核对

- `DC1.5 → F1.1`，`F1.2 = 12V_PROT = U2.1/U2.8 = U1.2/U1.9/U1.10`；用户删除的 0.1 Ω 输入采样位不在路径中。
- `U2.15 = C15.1 = U3.11 = DRV_TRQ_CNT`；`C15.2=GND`。
- 2026-10-10 删除 HX711 后的快照中，原应变桥 U6 等器件及全部 `TENSION_*`、`HX_*` 网络均已消失，当时整板 57 个带位号器件。2026-10-11 用户将新钮子开关重新编号为 U6；当前网表为 66 个器件，不能把两个 U6 混同。
- PB13/PB14/PB15 当前不连接，已在原理图标为 NC；U7 通用反馈扩展口保留。
- 2026-10-11 重新打开并逐页运行严格原理图 DRC，当前四页均返回空结果（0 条错误、0 条警告）。PCB 尚未绘制，PCB DRC 不在本轮范围。

## 首板实验与封闭条件

在真实卷帘上连续记录时间戳、STEP 计数、TRQ_CNT ADC、nFAULT、电源，以及独立拍摄或尺量的帘布位置与拉珠峰值力。覆盖上端触顶、下端反卷、正常中途运行、故意卡阻；重复多次并改变方向、速度、相电流、帘重和供电。先由独立观察确定最低点，再求反卷事件起始步数与最低点之间的 `Δ` 分布；用未参与定阈值的行程验证误检、漏检、偏移漂移和停止延迟。

如果上端与途中卡阻不可区分，或下端反卷信号不能稳定定位真实最低点，则校准失败时停机并报告，不写入猜测行程；需要重新研究设备内部的运动反馈或机构方案。当前原理图证明具备采样路径，不证明自动双端校准已经可靠。

## 视觉检查状态

编辑器 `getCurrentRenderedAreaImage` 返回的 MCU 页截图为全黑，不能用于审图；改为对嘉立创EDA桌面窗口使用 `PrintWindow` 抓取，取得电源页（历史附件未随公开候选提供）、驱动页（历史附件未随公开候选提供）、主控页（历史附件未随公开候选提供）和无线操作页（历史附件未随公开候选提供）的 2026-10-10 历史画面。已经目视确认 HX711 专用页消失、MCU 的 PB13–PB15 有 NC 标记、TRQ_CNT 引出仍在。2026-10-11 主控页更新见当日截图（历史附件未随公开候选提供）；用户仍需审批图面和电路方案。
