XJH-Jorhai/automatic-curtain-lifter/hardware/schematic-review/design-qa.md

# Curtain_Lifter_Mainboard_RevA 原理图设计问答

本记录用于解释主板电路和设计取舍。解释以实际连接为准；设计意图、推导结论和实测结果分别表述。QA001–QA005 记录提问当时的 65 器件版本；2026-10-09 的 V3 电源及存储器变更见 QA006，旧问答中的 J1/Q1/FRAM 不再代表当前原理图。

## 连续问答约定

沿用仓库 `hardware/schematic-review/` 的硬件审阅目录。每轮按北京时间日期追加，问题使用连续编号，保留用户原话，并写明涉及的版本、器件和网络、回答依据及待验证项。后续追问引用已有编号，新主题继续编号。

器件功能先查实际网表和引脚，再与项目设计文档、原厂资料核对；缓存与当前编辑器有差异时，以明确核对过的当前状态为准。估算必须列出假设，未做的试验不能写成已通过。发现旧结论错误时，追加带日期的更正并指向原记录，不静默覆盖历史问答。

用户的猜测保留为问题背景；助手的建议不自动升级为已冻结设计。设计决定仅在用户明确采纳后另行记录，原理图修改须有对应任务授权。待办使用“待复核 / 待实测 / 已解决”，解决后追加证据及日期。

2026-10-09 方法补充：给出电源、插座、保险丝等载流规格前，先依据当前电机参数、微步模式和电流设定建立功率预算，分别列出已知参数、假设、持续输入电流与瞬态要求。不能把相电流、驱动芯片额定上限或保险丝保持电流直接当作整板输入电流，也不能用未经量化的“留余量”确定最低规格。

## 2026 年 10 月 9 日 电源入口与堵转

以下 QA001–QA005 记录更换 DC 插座、移除防反接支路之前的审查过程。旧 J1、Q1/R3/D3 的“当前”表述仅对应当时版本；现行 V3 状态以 QA006 为准。

版本依据：当时的 EasyEDA V3 工程“涂鸦智能家居产品-窗帘开关”，工程 UUID `d8963714934544559fd468e3e2743100`；板卡 `Curtain_Lifter_Mainboard_RevA`，原理图 `Curtain_Lifter_Mainboard`，四页。当时导出的整板网表有 65 个器件；该网表后来被最新 V3 版覆盖，以下问答按历史版本阅读。现行版本见 QA006 及[最新网表](Curtain_Lifter_Mainboard_v3.enet)。

实际电源路径：`J1.1 → R19 → F1 → Q1.S → Q1.D → 12V_PROT`；D1 阴极位于 F1 与 Q1.S 之间，阳极接 GND。Q1 栅极经 R3 接 GND，D3 阴极接 Q1.S，阳极接栅极。

### QA001 R19 的用途

**原问题：** DC入口后面的100毫欧（R19）干嘛用的

**回答：** R19 是整板输入电流的串联采样电阻，具体器件为 Vishay WSL2512R1000FEA，100 mΩ、1%、1 W、2512。测两端压差可按 `I = ΔV / 0.1Ω` 算出输入电流，包括电机和控制电路消耗。

| 整板输入电流 | R19 压降 | R19 功耗 |
| --- | --- | --- |
| 0.5 A | 50 mV | 25 mW |
| 1 A | 100 mV | 100 mW |
| 2 A | 200 mV | 400 mW |

当前网表中，R19 上游网络只有 J1.1 和 R19.1，下游网络只有 R19.2 和 F1.1；没有引出到电流检测放大器、MCU 或专用测试点。因此它目前提供外部测量的压差，**没有实现固件电流监测，也不是主动限流器或堵转检测电路**。设计文档将其称作“采样位”，但实际测量便利性还取决于 PCB 是否方便探测两端。高边两端均接近输入电压，不能直接接到 3.3 V MCU ADC。

1 W 是器件额定功耗，不代表任意散热条件下可持续通过 `sqrt(1/0.1) ≈ 3.16 A`。选型还须考虑温度降额与脉冲能量。待机输入功率为 100 mW、输入 12 V 的计算示例对应 8.33 mA，R19 压差仅约 0.833 mV；普通万用表是否能可靠分辨须看量程和精度。

**状态：** 已解释。是否需要保留 R19、增加在线测量或测试点尚未作设计决定。

### QA002 Q1 与 DC 插口的防反接

**原问题：** Q1是防反接还是开关？看起来是防反接，DC插口也要防反接吗

**回答：** 项目原记录给 Q1 的设计意图是 P-MOS 防反接。Q1 为 CJ3401，栅极由 R3 下拉，未连接 MCU，因此它没有承担软件控制的总电源开关功能。D3 的 9.1 V 栅源钳位用于限制 VGS；CJ3401 原厂标称 VGS 绝对最大值为 ±12 V。[长晶 CJ3401 参数](https://www.jscj-elec.com/related/23357.html)。

**本轮更正：当前实际连接不能直接认定为有效的 MOS 防反接。** 网表确认 Q1 的 2 脚 S 接 F1 后输入，3 脚 D 接 `12V_PROT`。P-MOS 的体二极管从 D 指向 S，此连接使体二极管朝向输入。常规高边 P-MOS 防反接应让体二极管沿正确供电方向导通，即 D 接输入、S 接负载；正常上电时先由体二极管启动，再由 MOS 沟道承担低损耗导通，反接时体二极管截止。[TI 防反接应用说明，图 3](https://www.ti.com/lit/an/slva139/slva139.pdf)。

因此，当前 Q1 正接时可以导通，但反接时其体二极管存在把负载电源拉向负电压的路径。D1 是位于 Q1 前面的单向 TVS，反接时可能正向导通，使输入钳位并引发适配器限流或 PTC 动作；这不是 Q1 正确阻断反接的证明，保护协调也未经试验。项目 README 和 BOM 审阅中“Q1 反接保护”的描述应理解为原设计意图，本条记录纠正其功能判断。

DC 圆孔插头不能通过旋转交换内外触点，但同尺寸适配器可能有不同的中心极性，也可能误用接反的转接线。规定中心正、外圈负并不自动消除这些情况。用于用户插拔的电源口，防反接仍有价值。

**状态：** 待复核。Q1 源漏接法、D3 随源极的连接及 D1/PTC 的保护配合须在后续电路审查中处理；本轮未改图。

### QA003 12V_PROT 与严重堵转对整机的影响

**原问题：** 12V prot是直接动力电？如果严重堵转是否会导致设备有工作不正常的风险？（应该不太容易

**回答：** `12V_PROT` 是经过入口器件后的未稳压电源母线，电压跟随适配器，减去串联路径压降；不是重新稳压得到的 12 V。它直接连接 U2 DRV8434A 的两个 VM 引脚，同时连接 U1 LMR33630 的 VIN/EN，由 U1 产生 MCU、FRAM 和无线模组使用的 3V3。电机绕组经 U2 的 H 桥驱动，并非直接跨接在这条母线上。`PROT` 是命名，不能代替保护有效性的验证，见 QA002。

在 VREF 设定合理、驱动和电源正常时，DRV8434A 通过斩波调节绕组相电流。步进电机堵转通常不会像未限流的有刷直流电机那样发生大幅失控增流；**短时堵转不必然造成 MCU 复位或无线掉线**。但相电流限制不等同于整板输入电流恒定，不能仅凭 1 A/相推断适配器输入为 2 A。[TI DRV8434A 数据手册，7.3.5](https://www.ti.com/lit/ds/symlink/drv8434a.pdf)。

共用电源意味着风险仍然存在：适配器进入限流或打嗝、线缆/插座/入口器件压降过大、PTC 受热进入高阻，均可使 `12V_PROT` 跌落，并进一步使 3V3 不稳、MCU 复位或模组掉线；驱动长时间持续励磁还可能导致温升和热保护。电机开关电流通过共用电源和地回路也可能产生干扰，大小取决于 PCB 和去耦。C11 的 100 µF 主要缓冲瞬态，不能保证长时间电源异常下主控继续运行；仅作数量级示例，100 µF 在完全断供、负载 1 A 时放电 1 V 只需约 100 µs，忽略 ESR 和其他电容。

机械失速报告本身不会自动关闭 DRV8434A 的 H 桥。本图使用 `STL_MODE=GND` 的扭矩计数模式、MCU 读取 `DRV_TRQ_CNT`，须由固件停止 STEP 并关闭 ENABLE，必要时休眠；只是停发 STEP 仍可能保持绕组励磁。[TI DRV8434A 数据手册，7.3.9 保护表及 7.4](https://www.ti.com/lit/ds/symlink/drv8434a.pdf)。现有台架固件尚无电机控制，设计要求不代表已经实现。

**状态：** 待实测。首板同时观察启动、换向、短时卡阻和持续卡阻下的 `12V_PROT`、3V3、输入电流、nFAULT 和器件温升，再判断电源是否有足够余量。当前可判断“受控短时堵转通常不会必然拖垮整机”，不能确认本样机概率很低。

### QA004 DC 插座应选什么规格

**更正索引：本条原先“至少 3 A、优先 5 A”的建议缺少功率估算依据，已在同日 QA005 撤回。保留下文供追溯；当前电流选型结论以 QA005 为准。**

**原问题：** 还有一个问题是dc插座要选什么规格的合适（额定电流、

**回答：** 按本板 12 V 输入、首轮约 1 A/相步进驱动和当前 F1 标称 2 A 保持电流，建议将下表作为首板筛选规格；这些是工程建议，尚未冻结采购料号。

| 项目 | 建议与依据 |
| --- | --- |
| 接口尺寸 | 适配 5.5 mm 外径、2.1 mm 内孔的 DC5521 插头，统一中心正、外圈负；同时核对插入深度和插头长度。 |
| 额定电流 | 建议连续额定至少 3 A；体积、成本接近时优先 5 A，留接触温升和老化余量。若实测持续输入接近或超过 2 A，须连同 F1、R19、Q1、走线和线缆一起重算。 |
| 额定电压 | 至少覆盖项目输入上限 15 V，优先明确标称 24 V DC 或更高的器件。该额定值不表示允许给本板输入 24 V。 |
| 安装与机械 | 优先有足够固定强度的通孔件；核对外壳受力、焊脚布局、插拔寿命和装配空间，避免只靠小焊盘承受插拔力。 |
| 接触性能 | 必须有对应型号的额定电流、接触电阻和温升/试验条件资料；配套插头与线缆的载流能力也须满足要求。 |

“DC-005”是外形或系列名称，不能据此认定所有型号都耐 3 A 或 5 A；DC 电源连接器的额定电流、尺寸和安装方式因具体型号不同而变化，可参考[连接器原厂目录](https://www2.sameskydevices.com/catalog/interconnect/connectors/dc-power-connectors)。当前 J1 为 `DC-005-5.5*2.1`、商城编号 C9900017044，网表中厂家和数据手册字段为空，**尚不能确认当前器件的额定电流合格**。

插座的 3 A/5 A 是允许载流能力，不是强制给设备输送的电流，也不等于适配器必须选 3 A/5 A。适配器容量须按整板最大输入功率、启动瞬态及其过载行为确定。首轮可用有明确保护特性的 12 V 电源进行负载测量，再冻结适配器规格。不能简单把两相 1 A 相加作为 12 V 输入电流。

**状态：** 待复核。取得 J1 的可靠规格书，或后续选用资料完整且匹配上述条件的器件；本轮未换件。

### QA005 DC 插座建议的功率估算与更正

**原问题：** ？让我选3A的5521插座开什么玩笑。你做过功率估算了吗

**回答与更正：** QA004 给出至少 3 A 的建议时没有完成本板功率估算，该最低规格缺少依据，现撤回；优先 5 A 的建议也不作为本板要求。不能从 F1 的 2 A 保持电流反推插座必须至少 3 A。

当前网表中 M0/M1 均接 DVDD，配置为 1/8 微步；VREF 使用 56 kΩ 上臂和 21 kΩ 下臂。按 DVDD=5 V、VREF 内部典型 500 kΩ 下拉计算，下臂等效约 20.15 kΩ，VREF≈1.323 V，`I_FS=VREF/1.32≈1.002 A`。低电流支路增加 10 kΩ 下拉后约为 0.404 A。电流设置和微步表依据 [TI DRV8434A 数据手册](https://www.ti.com/lit/ds/symlink/drv8434a.pdf)，绕组 4.5 Ω/相沿用[本项目 42CM02-1A 选型参数](../../docs/09-motor-drive-decision.md)。

1/8 微步的两相电流近似 `I_A=I_FS×sinθ`、`I_B=I_FS×cosθ`，所以两相铜耗为 `R×(I_A²+I_B²)≈R×I_FS²`，约 **4.52 W**。45° 时每相约 0.71 A；并不是两相同时各 1 A，也不是直接从 12 V 各取 1 A。这里用理想调节电流估算，未计入纹波、器件公差及电机热态电阻。

| 功率项 | 预算 | 参数或假设 |
| --- | --- | --- |
| 两相电机铜耗 | 4.52 W | 4.5 Ω/相、约 1 A 满量程、1/8 微步 |
| MCU、无线和其他 3V3 负载，折算入口 | 1.94 W | 假设合计 0.50 A @ 3.3 V，Buck 效率 85%；T1-3S 官方表列弱网状态最大典型值 394 mA，因此该预算另留约 106 mA 给主控等负载，不是测得值 |
| 驱动损耗、电机铁耗与入口损耗 | 暂列 1 W | 工程预留，待按转速、温度和实测细化，不是保证上限 |
| 机械输出 | 0.57–1.13 W | 示例假设负载扭矩 0.09 N·m、转速 60–120 rpm，按 `P=τω`；0.09 N·m 是项目运行扭矩目标，转速尚未冻结，启动惯性未计入 |
| 合计 | 8.03–8.59 W | 上述假设同时成立时 |

无线电流来源：[涂鸦 T1-3S 官方规格书，工作电流表](https://developer.tuya.com/cn/docs/iot/T1-3S-Module-Datasheet?id=Keesax53r0r2d)。

上述总功率在 12 V 下对应约 **0.67–0.72 A**，可暂按 **0.7–0.8 A 的持续输入预算**理解，不能将其当作实际整机最大值。相同功率在 9 V 下约 0.89–0.95 A。若再举例假设绕组相对参数温度升高 60℃，按铜的约 0.00393/℃温度系数，铜耗约 5.59 W；120 rpm 情形在 9 V 下约 1.07 A，仍不是 3 A 级持续需求。

保持或真正堵转时机械输出接近零，但绕组铜耗继续存在；不能用 4.52 W 作为运行时整板全部功率。电容充电和 PWM 会有瞬态电流，插座触点应核对 RMS 电流、接触温升与短时承受能力，不能将微秒级峰值直接等同连续额定要求。

**当时建议：额定连续 2 A、规格资料可靠的 DC5521 插座可作为合理的首板候选，现有预算没有要求至少 3 A 的依据。** 若只用 1 A 额定件，12 V 下上述运行示例可能满足，但在项目允许的 9 V、热态和未确认瞬态下余量较少，目前不足以直接定为通用规格。最终型号应按实际最高转速、热态输入电流、启动波形和接触温升核对。旧 J1 后续已移除，现行 DC1 的原厂额定值见 QA006。

**当时状态：** 已撤回无依据的 3 A 下限；功率估算已记录。2 A 是旧 J1 的有条件候选规格，后续用户已换为 DC1。

## 2026 年 10 月 9 日 V3 电源与存储器更新

### QA006 取消防反接、替换 FRAM、更新 DC 插座

**用户决定：** 防反接电路已从输入页移除；FRAM 成本过高，改用便宜的存储器；DC 插座已换新型号，文档同步。

**当前原理图：** V3 整板网表为 58 个器件。电源路径为 `DC1.5 → F1 → R19 → 12V_PROT`；D1 SMBJ15A 从 F1 后端接 GND。旧 J1、Q1、R3、D3 不在现行网表。防反接不是本版功能，`12V_PROT` 名称仅表示入口器件后的电源母线，不代表反接保护。

**DC1 规格更正：** 用户所选 [讯普 DC-050-A250，C41429013](https://jlcpcb.com/partdetail/XUNPU-DC_050A250/C41429013) 是卧贴 SMD、内径 2.5 mm、外径 6.4 mm。对应的[讯普原厂图纸](https://item.szlcsc.com/datasheet/DC-050-A250/43280632.html)在 “Rated electrical load” 栏明确写 **DC 24 V、3 A**；商城参数表所列 12 V、1 A 与之冲突。此前据商城字段断言该插座仅额定 12 V、1 A，及由此提出的 9–15 V 电压范围不被插座覆盖、9 V 热态输入超过 1 A 的插座额定风险，均为错误判断，现予撤销。原厂图纸的 24 V、3 A 覆盖原 9–15 V 输入范围与 QA005 的估算持续电流；整机仍需测启动瞬态、接触温升并核实配套插头。它与旧 DC5521 插头不兼容。DC1 原理图 5 脚接正输入、3/4 脚接 GND；实际插头中心极性与机械触点编号须按所购器件图纸和样品复核。

**存储器：** U4 已用商城原生库件 [Microchip AT24C16C-SSHM-T，C6480](https://www.lcsc.com/product-detail/EEPROM_Microchip-Tech_C6480.html) 替换原 FM24CL16B-GTR，仍为 SOIC-8、16 Kbit、I²C。1–3 脚 NC，4 脚 GND，5/6 脚 SDA/SCL，7 脚 WP 接 GND，8 脚 3V3；旧 10 kΩ 上拉和 100 nF 去耦保留。[原厂资料](https://ww1.microchip.com/downloads/en/DeviceDoc/AT24C16C-data-sheet-20006051A.pdf)给出 16 字节页写、最长 5 ms 写周期和 100 万次写入耐久。商城参考价在本次查询时约 $0.276/颗（5 颗起），原 FRAM 约 $1.12/颗（1 颗起）；价格和库存会变，采购时重查。

EEPROM 保留断电数据，普通 RAM 不能做到这一点。固件不再按每秒或每 1% 写位置；仅在校准成功及受控停机时写轮转记录、CRC 并回读校验。运动中断电无法保证最新位置已写入，因此每次上电都将位置标为不可信，下次命令受控回零。该策略已同步到系统架构和验证计划，固件尚未实现。

**核对：** U4 替换前后的位号集合均为 58 个，仅 U4 料号 C31082→C6480；46 组网络的引脚集合完全一致。V3 非严格 DRC 通过，另有 4 条警告待最终审查。
