XJH-Jorhai/automatic-curtain-lifter/hardware/test-records/2026-09-25-g030-t1-3s-live.md

# G030C8T6 与 T1-3S 真实联调记录（2026-09-25）

## 结论

STM32G030C8T6 台架固件已经通过真实 T1-3S 模组完成串口初始化、AP 配网、云端连接、App 下发和状态回传。涂鸦智能 App 中的目标百分比与停止状态由用户确认显示正确。此结论只覆盖联网与 DP 通路，不代表电机、限位、位置测量或掉电恢复已经实现。

## 测试配置

| 项目 | 本次配置 |
|---|---|
| MCU | STM32G030C8T6 开发板；CubeMX/HAL 台架固件 `firmware/g030_tuya/` |
| 模组 | 已烧录并授权的 T1-3S，`t1_common_user_config_ty` 3.0.22 |
| 通信 | T1-3S RX1←PA9、TX1→PA10；3.3 V UART，9600 8N1，共地 |
| 调试 | PWLINK2 LITE 的 SWD 接 MCU；DAPLink 虚拟串口 COM3 接 PA2/PA3，115200 8N1 |
| 供电 | 模组使用稳定 3.3 V 供电；本次未记录电压波形或电流数据 |
| App | 涂鸦智能，AP/热点配网，公版窗帘面板 |

## 证据与判定

| 测试点 | 观察 | 判定 |
|---|---|---|
| 构建及烧录 | CubeMX 6.18.1 生成工程；Debug/Release 构建成功；pyOCD 通过 PWLINK2 CMSIS-DAP 烧录 G030 | 通过 |
| MCU 协议预检 | DAPLink 串口暂接 PA9/PA10 时，`serial_smoke.py` 验证心跳、产品信息、工作模式、全量查询、DP2 与错误帧恢复 | 通过，属于模组模拟测试 |
| 真实串口初始化 | 接入 T1-3S 后周期性收到 `RX cmd 00`；发送配网命令后收到 `RX cmd 01`、`RX cmd 02` | 通过 |
| AP 配网 | 调试串口发送 `P`，收到 `PAIR mode ACK from module`，状态变为 `WIFI_STATE 01` | 通过 |
| 路由器及云端 | App 配网期间依次出现 `WIFI_STATE 02`、`03`、`04`；再次查询仍为 `04` | 通过 |
| 全量状态查询 | 云端连接后收到两次 `RX cmd 08` | 通过；台架固件回复 DP1、DP2、DP101 |
| App 下发目标 | 收到 `RX cmd 06`，`DP2 target (hex) 3E` 与 `64`，即 62% 和 100%；用户确认 App 已修改至 100% | 通过 |
| App 运动命令 | 两次收到 `RX cmd 06`，日志为 `DP1 motion rejected: no motor safety inputs` | 按台架安全策略通过；没有实际运动 |
| 状态回传 | 用户确认 App 的目标百分比与停止状态显示正确 | 通过；以用户界面确认作为证据 |

本次未保存含设备身份信息的完整串口原始日志。上表摘录了调试串口输出和用户对 App 画面的确认，不包含生产凭证、设备密钥或 Wi-Fi 密码。

## 固件当前边界

- DP1 仅接受 `stop=1`；打开、关闭、继续均拒绝并报告停止。
- DP2 接受 0–100 的目标百分比，保存在 RAM；它不是实测位置。
- DP101 实际位置固定报告 0。重启后 DP2 目标恢复 0。
- 未连接电机驱动、限位、按键和 FRAM；尚未测试机械运动、故障保护、断电重连、BLE 配网、功耗和 MCU OTA。
- 本次使用的生成 SDK 快照早于 DP2 步长改为 1 的控制台修订。台架固件自身接受整数 0–100；正式固件仍应重新下载 XLS、产品协议和 SDK，并与修订后的 JSON 对齐。

## 后续工作

1. 冻结电机、限位、按键、故障和供电接线，再实现独立于涂鸦 DP 的运动安全层。
2. 用断电、模组重启、断网及重连场景验证状态一致性和掉电保持。
3. 根据完整引脚、定时器、Flash/RAM 与封装需求选择最终 MCU；当前 G030C8T6 是开发板，G031G6U6 是待评估候选，G071 是原先的余量方案。

复现实验所需接线、构建、烧录与调试命令见 [`firmware/g030_tuya/README.md`](../../firmware/g030_tuya/README.md)。
