XJH-Jorhai/automatic-curtain-lifter/hardware/test-records/2026-10-20-motor-notes.md

# 音符文本与自动正反往返（2026-10-20，v5）

本轮根据用户要求完善文本音符输入，优先防止单向累计位移，同时核对细分/静音硬件限制。
**没有播放新版，没有动作电机。** 此前第一次斗地主单向测试的现场反馈为声音可能太小，不能据此确认转子运动。

## 实现

- 直接`c4f4g4`或`PLAY C4 F4 G4`播放一次；`CHECK ...`只解析；`STOP`立即停机。
- 默认120 BPM四分音符；可用`T150`、`/8`等时值、附点、升降号、R/P休止符。
- 最多191字节输入、32音、C3–B5、10秒；整行完整校验后才启动，不播放有效前缀。
- 旧`MOTOR TUNE`保留第一乐句，改用同一文本解析和往返播放实现。
- 每一正向微步后跟反向微步，DIR在STEP下降沿切换，下一上升沿至少约253 µs后出现。
- 正常结束先完成正反一对，软件指令偏移回0；STOP/故障立即断输出，不为回到0而继续运行。
- 软件偏移不是编码器位置；唤醒对齐、共振和失步的实际摆幅未实测。
- 低电流档保持不变；没有自动加大电流。M0/M1硬接DVDD，固定1/8细分，固件不能改整步或关闭所谓静音模式。
- EEPROM维持严格按需访问，旋律只在RAM，不保存、不扫描。

## 验证

CubeMX已有TIM14配置保持为16 MHz / (PSC+1=16)，1 MHz计时。
编译通过：Flash 45,988 B，RAM链接占用2,920 B（不是运行时栈峰值）。

`notes_check.py`目标机无运动测试通过：

- 大小写/连续/空格音符、升降号、休止符、附点、节拍、32音输入；
- `c4f4g4`解析为3音、1590 ms；第一乐句解析为11音、3530 ms；
- 越界音高、非法时值/节拍、超时、33音、超长输入、错误PLAY均拒绝；
- 共40个正常结束请求位置，复用实际中断使用的正反边沿逻辑；
  全过程中软件偏移只能为0/+1，正常结束时STEP低、DIR初始、偏移0；
- 自测没有任何GPIO调用；集成检查前后电机待机、STEP计数不变；
- EEPROM reads/probes/attempts/writes均0，UART errors/drops均0。

调试过程中发现保留乐句最后一个音时值不一致，已改为`G4/4.`并重新编译、烧录和通过自测。
没有把失败测试当作通过。

全Flash回读与最终镜像一致，SHA256：
`3a8cf0642daa34b3e6ed53f6ab86807a6d5ec42c30c3bd9bb0103fb6aa6b2314`。
GPIOA_ODR=0、GPIOB_ODR=0x1000，电机输出禁用，OPTR保持0xDFFFE1AA。

记录：解析与逻辑测试（历史附件未随公开候选提供）、Flash核验（历史附件未随公开候选提供）。
接口、音乐示例及硬件限制详见[使用说明](../../firmware/g030_mainboard/MOTOR_MUSIC.md)。
此实现是简写音符格式，不是完整Bluejay RTTTL兼容层；实际音色及机械摆动待用户就位后验证。
