XJH-Jorhai/automatic-curtain-lifter/hardware/test-records/2026-10-20-music-octave.md

# 斗地主乐句低音更正

用户明确第6音为低音6、末音为低音5。以C4为1：
第6音原本已为A3（220 Hz），末音由G4（392 Hz）更正为G3（196 Hz）。
未将A3继续降至A2。指令往返频率不等于已测得的声学主频，实际声音待试听。

更正乐谱：
`T150 E4/4 E4/8 D4/8 C4/4 C4/8 A3/4 D4/8 E4/8 D4/8 E4/8 G3/4.`

生产Music_SaveScore写入槽B，generation=2，14次页写，CRC校验通过。
旧槽A及槽B记录以外字节不变。同一乐谱再保存一次，全部读写计数不变。
完整镜像：2026-10-20-score-low5.bin，
SHA256 `51fe90a9c2970307ea07ef1f8d43b4f43a92ee41ef3f48e5a0f7ba341810600f`。
本次没有复位、播放或烧录；电机状态和STEP计数不变。

待烧录的三微步增响版内置乐句及测试同步更正，编译通过（Flash51148字节）。
单片机当前仍运行两微步版；下次上电会读取最新EEPROM乐谱。
三微步增响试听仍等待用户确认。
