XJH-Jorhai/automatic-curtain-lifter/hardware/test-records/2026-10-20-switch-startup.md

# 本地开关启动震动排查

用户现场确认空载上位动作功能看起来正常，但启动有明显震动和声音，
随后转动顺滑。开/关与转动方向映射暂不定义，留待装配及云端配置。

排查时只读回报：

```
MOTOR phase=0 count=147 goal=400 reason=4 dir=1 nFAULT=1 EN=0 SLEEP=0 LOW=0 tune=0 note=9 offset=0
SW raw=0 armed=1 owned=0 pending=0 up=15 down=15 stops=25 reject=0
INPUTS UP=1 DOWN=1 NET=1 EXT=0 nFAULT=1
```

期间用户有多次拨动，因此此快照仅证明最后一次动作已停止，不能当成
最初上位400步测试的完整遥测，也不能据此标记反转及停止的现场验收完成。

## 确认与推测

- 原正常运动路径无加速，直接从静止跳到200 STEP脉冲/秒。
- 每次停止均拉低ENABLE与nSLEEP；重新启动等待2ms唤醒、1ms使能，
  随后开始固定步频。
- 本地DRV8434A手册6.5给出tWAKE最大1.2ms，现有2ms等待满足该值。
- 手册7.3.3说明退出休眠回到45°初始励磁相位，两相各71%满量程电流。
  因而重新通电对齐也可能造成震动；尚无电流波形/转子位置证据确定其贡献。

## 本次改动

只改正常运动STEP周期，保留音乐时序、电流档、休眠策略、EEPROM策略。
第一步周期20ms，每两步减1ms，前30步后稳定5ms。
400微步理论完成时间2243ms（含唤醒/使能），硬截止2400ms。
中位、STOP、故障仍立即关闭输出，不为减速延后停止。

增加纯RAM状态自测：双方向渐进启动、脉冲间隔单调性、脉宽、400步
精确计数及完成时间、加速中停止；保留故障、超时和tick回绕测试。
自测不输出电机脉冲。

编译通过：Flash53964字节，RAM3864字节。
现场改善程度待用户比较；不能由编译或自测推断机械震动已消除。

烧录全量回读校验通过，SHA256: 39ac4f3cf416185854033923f57e736f7c9e98d0ae3ec02f349c782e54f0ca23。
板上 MOTOR TEST 与 SW TEST 均 PASS；中位已确认，驱动关闭，nFAULT=1。
EEPROM reads=2（启动加载），attempts=0，writes=0。现场比较待反馈。

## 现场反馈及第二轮诊断

用户反馈渐进升速后基本不变，拨动瞬间抖一下。这削弱了步频突变为主要原因的假设，
但不能单凭听感确定电流对齐原因。下一版保持休眠和低电流不变，
ENABLE后等待500ms才开始STEP，让用户区分通电瞬间和首步。
该临时参数使400步总时长2742ms，硬截止2900ms；中位停止覆盖等待阶段。
新增等待期零脉冲及等待期停止自测；编译Flash54164/RAM3864字节。

第二轮烧录全量回读PASS，SHA256 a98211b05ccf4dac7b1f8a38ba6ee03b366a05563f3a14a05ab747294dfbfe08。
MOTOR TEST/SW TEST均PASS；UP=DOWN=1，驱动关闭，EEPROM writes=0。等待用户比较两个时间点。

## 第三轮：普通停机保留索引相位

用户明确观察：拨动当下抖，半秒后起转顺滑。证据定位到励磁建立阶段，
但尚未单独证实休眠重置相位是唯一原因。
正常点动结束或中位/STOP仅拉低ENABLE，保持nSLEEP原电平；下次正常启动
不再先拉低nSLEEP。绕组输出仍为高阻，不保持电流。
故障、超时、主循环失联、初始化和音乐结束仍全关闭并休眠。
保留500ms诊断等待及渐进升速，以便单独比较相位保留效果。
首次启动、播放音乐后或转轴被外力移动仍可能有对齐，不能保证消除。
编译通过：Flash54276/RAM3864字节。等待居中确认后烧录。

第三轮烧录回读PASS，SHA256 bf25839fd224d462188b378aff6e78ae83f6fcd5ba2fab9fd2fdeed006fd749f。
板上MOTOR/SW自测PASS，中位，EN=0；B1结束仍nSLEEP=0符合音乐原行为。
EEPROM reads=2，writes=0。待首次普通运动后回读nSLEEP=1并取得连续启停反馈。

## 2026-10-21 反馈与实际状态

用户反馈相位保留后三次基本一样。只读确认 EN=0/SLEEP=1，策略已生效。
INPUTS UP=1 DOWN=1；MOTOR count=195 goal=400 reason=4 dir=0；SW up=2 down=1 stops=3。
实际动作含双方向及提前停止，未取得固定400步终点的同方向重复比较。
因此不能把本轮直接记作严格受控的三次完整行程试验。下一步不改固件，
先取得一次完整400步、保持上位的停止状态，再比较同方向再次通电。
励磁建立瞬间为抖动发生阶段；断电后机械回落仍是未验证假设。

固定终点第一轮回读：count=400 goal=400 reason=1 dir=0，EN=0/SLEEP=1，nFAULT=1。
确认软件完整输出400脉冲并正常结束，驱动索引保留；不能据此证明机械无失步。
回读时实际UP=DOWN=1、SW raw=0 armed=1，开关已居中。可进行下一次同方向启动比较。

固定终点第二轮：用户反馈明显减轻或不抖了。回读UP=0/DOWN=1，count=400/400，
reason=1、dir=0，EN=0/SLEEP=1，nFAULT=1，SW armed=0 owned=0 pending=0。
完整结束后保持上位没有再次启动。该结果支持普通停机保留索引对固定终点的重复启动有帮助；
不是严格排除全部变量的根因证明，也不能推广为首次上电/任意微步中断/外力移动后无抖动。
仍保留500ms诊断等待；尚待明确验收下位反向及运行中回中位停止，再收敛最终参数。

用户补充开关为弹簧自复位、保持力较大；后续只要求短按观察，不要求持续保持供回读。
用户现场确认下位与上位转向确实相反。读回UP=DOWN=1，phase=0、EN=0、SLEEP=1、nFAULT=1。
最新动作count=221/400、reason=4、dir=0；累计up=5/down=2/stops=4。
最新记录为上位方向，不能当作刚才下位动作的逐次记录；仅确认读取时已中位且输出禁用。
方向相反依用户现场观察验收；松手后的机械停止表现仍待用户明确反馈。

## 2026-10-21 基本开关功能现场验收

用户明确确认：上、下位实际转向相反；松手回中位后电机停住。
结合此前GPIO三态测量与当前EN=0回读，正反向请求、松手停止基本功能通过。
这是空载现场观察，不是示波器停止延迟测量，不代表执行器带载或限位控制已验收。
启动抖动仅在完整400步终点的重复启动中确认改善，首次励磁和任意中断后尚未解决。
当前板上仍为相位保留+500ms诊断等待版本，本轮只更新记录，没有烧录或触发运动。

## 2026-10-21 恢复正常启动响应并提速

按用户要求移除500ms诊断等待，保留2ms唤醒及1ms使能准备。
目标步频200提升到250Hz（25%），起始50Hz，前32步逐步缩短周期至4ms。
400步理论完成1875ms，硬截止2001ms；保留普通停机相位、低电流与即时停止。
音乐及EEPROM逻辑未修改。编译Flash54240/RAM3864字节。

烧录全量回读PASS：8749c7a6e2c881fe8817f7a8386368ff373b4d9c113d8587535479566d2e1906。
板上MOTOR TEST/SW TEST均PASS，中位、EN=0，EEPROM writes=0。待用户正常短按启停反馈。

## 2026-10-21 正常版本反馈及速度评估

用户确认250Hz正常启停没问题，希望依据原扭矩计算再提速。
项目原负载0.0257–0.0292 N·m，运行目标0.09 N·m；42CM02-1A仍为文档候选，
缺少实装型号确认及本板电压/电流下速度—扭矩曲线，不能由静态保持扭矩给出保证转速。
按1.8°、1/8微步，1600脉冲/转：250Hz=9.375rpm；建议下一轮试验目标60rpm=1600Hz。
60rpm是工程试验起点，非扭矩保证或已验证速度；现有1ms状态机不能直接改常数实现，需定时器脉冲。
更正此前低电流估算：DRV8434A DVDD典型5V（TI手册6.5），现有分压低档约0.404A、正常档约1.002A满量程，
均为电阻模型估算而非实测；此前以3.3V算0.27A错误。硬件和当前电流档没有改变。
本轮未改固件或烧录，板上仍250Hz正常版本。

## 2026-10-21 TIM14正常运动60rpm版本

用户授权改用定时器并烧录。沿用CubeMX配置的TIM14：HSI16/PSC15=1MHz，ARR预装载关闭。
正常运动和音乐互斥，正常运动从50Hz在400ms内线性升至1600Hz；1.8°及1/8微步时目标60rpm。
单次仍限400微步、硬截止1500ms，正常停止保留索引但关闭绕组，故障关闭并休眠。
STEP逐边沿定时器ISR输出；SysTick负责开关及安全，不再写正常运动STEP。
STOP关闭定时器；回调和SysTick状态交接有临界区，防止完成/停止后误重启定时器。
每个定时边沿检查nFAULT、主循环服务和总期限；不追赶迟到脉冲。
RAM自测覆盖双方向1/400步、单调加速、625us巡航周期、脉宽边界、无额外脉冲、故障、tick回绕、等待期/高电平停止。
编译通过Flash54652/RAM3864字节。实际波形/转速及带载扭矩尚未测量。

60rpm版本烧录全量回读PASS：b6fe95ceb816613d7e1bc2074198309a32061aca8f61ab629551a6b3cfeb0b08。
板上MOTOR TEST、SW TEST、TUNE TEST均PASS；B1完成note=9/count=2010，中位、EN=0。
EEPROM writes=0、UART errors=0/drops=0。正常定时器运动的现场表现待用户短按验证。

用户反馈60rpm转动顺畅，但运行一段时间自行停止。只读回报count=400/goal=400、reason=1、dir=1、nFAULT=1、EN=0/SLEEP=1；SW up=2/down=2/stops=0。
确认本次为显式400微步目标完成，非1500ms超时(reason=3)或定时器未重置的证据。
本轮只检查并记录，未改固件或触发动作。

## 2026-10-21 按住持续运行版本

用户授权取消本地400微步限制。新增独立Motor_StartHeld入口，仅本地开关调用；串口MOTOR RUN仍为400微步诊断。
held模式goal=0，连续累计步数；松手停止reason=4，单次30秒保护停止reason=6，须回中位再启动。
保持1600Hz、400ms渐进升速、低电流及正常停机相位保留；音乐/EEPROM无变化。
RAM自测新增双方向越过400步持续至2秒、松手停止、tick回绕下30秒保护，配合SW限时结束保持不重启自测。
编译Flash55672/RAM3872字节。

持续运行版烧录全量回读PASS：18740a92751e2f95f6d0b6198c5ffcfd80f2a615cec14da9a0bc127d4e8b9845。
板上MOTOR/SW/TUNE自测均PASS，当前中位、驱动关闭，B1正常完成。EEPROM writes=0，UART errors=0/drops=0。
持续运行与松手停止的新版现场表现待用户反馈；30秒保护为RAM模拟验证，未让实物连续转30秒。

用户反馈持续运行60rpm容易失步。读回reason=4（松手停止）、count=17159（发出脉冲数非实际位置）、nFAULT=1，当前中位/EN=0。
低电流档仍约0.404A满量程估算；nFAULT不报告本板禁用的失速检测，不能据此排除失步。
尚待确认实装电机型号/额定相电流、负载及发生阶段，再决定电流或加速调整。本轮未改电流或固件。

## 2026-10-21 运行电流对比

用户确认实物铭牌1.8°/1.5A、保持转矩0.21（未给单位/确切型号），不能沿用候选电机绕组电阻电感。
正常运动由PA4高约0.404A切为PA4低约1.002A满量程，音乐仍低档；1600Hz/400ms加速及30秒保护不变。
电流值为DVDD5V及现有分压估算，非实测。F1网表为LUTE 1206L200/16NR、2A保持/3.5A动作，
不可套用同名Littelfuse型号的精确降额表。整板输入电流未测，不能由相电流相加推断或保证保险丝余量。
编译55672字节Flash/3872字节RAM。

约1A版本烧录回读PASS：f1126e8ef98d78640337d3fac392c798777dd03aaa5bdd485e74803caedf96a8。
板上MOTOR/SW/TUNE自测PASS；中位，驱动关闭，B1完成，EEPROM writes=0。
实际运行电流、整板输入电流及失步改善待现场测量/观察。

## 2026-10-21 负载上卷失败后降速对比

用户反馈约1A档明显有力、空载顺畅；实际窗帘上卷时电机轴停住并抖动，确认不是传动打滑。
用户明确要求15rpm、1秒加速、保持约1A。目标改400Hz（1.8°/1⁄8细分），50Hz起步线性升速1000ms。
本地继续按住运行、30秒上限；串口400步诊断截止从1.5秒改2.5秒，以容纳更慢加速。
停止及相位保留、音乐低电流、EEPROM策略不变。
自测更新至2500us巡航周期、400步约1.4–1.6秒、2秒持续运行越过400步。
编译Flash55708/RAM3872字节。首条串口因残留行返回ERR line too long，重试只读成功，确认中位/EN=0后烧录。

15rpm版本烧录全量回读PASS：0a75998d20aff2325bcf0d9ab6f3f3fc69a40bdfe5ca549c9a17d9ad3e68865e。
MOTOR/SW/TUNE板上无动作自测均PASS，当前中位/EN=0，B1已完成，EEPROM writes=0。
尚未进行本版本实际负载上卷，等待用户观察反馈。

## 2026-10-21 15rpm仍堵转：电流设定及负载复核

用户反馈15rpm/1秒加速仍无法上卷，轴停住抖动。只读count=157、reason=4、EN=0/nSLEEP=1/LOW=0，当前中位。
冻结网表核实：R4 56k由DRV_DVDD接VREF，R5 21k接地，R6 10k经Q2下拉；Q2为N-MOS，G=PA4，S=GND。
PA4低已是现有电路较高电流档，不能靠另一条软件指令直接升到1.5A。M0/M1均DVDD确认1/8细分。
TI关系IFS=VREF/1.32；1A是满量程设定，不是两相同时各1A，45°两相各约0.71A。
铭牌0.21保持转矩的单位/励磁条件/型号未齐全，不能拿它当当前运行扭矩保证。
板上不能直接测实际绕组电流；静态VREF只能验证设定，实际波形需电流探头等测量。
已请求中位不复位时测R4.1 DVDD、R5.1 VREF和输入电压，并确认实际电机拉珠轮珠心直径/是否直驱。
原估算用直径7mm及7.35–8.34N：约0.026–0.029Nm；若实际直径30mm，则约0.110–0.125Nm（未计余量）。
未改动固件或进一步加电流；等待测量以区分参考电压偏低、供电/绕组问题与实际负载超出估算。

用户测DVDD=0V；重新读回nSLEEP=0且count=2010/note=9，显示已完成一次启动音乐，旧唤醒快照不再适用。
用户授权打开驱动电源。SWD attach不复位/不halt，仅GPIOB BSRR置PB1，保持PB0 ENABLE低/PA6 STEP低。
初次脚本错误使用0x48000000 GPIO基址，在只读预检处FAULT、未写入；对照G030 CMSIS更正为0x50000000后成功。
最终串口确认EN=0/SLEEP=1/LOW=0，驱动逻辑唤醒但绕组禁用，等待DVDD/VREF实测。
用户提供实际拉珠轮SCAD：18珠、6mm弦距，珠心直径34.5526mm；按0.85kgf，T=0.144009Nm。
这是原7mm估算的4.936倍；代码load_torque_limit=0.15为尺寸选择假设，非实测电机可用扭矩。
原0.09Nm运行目标不覆盖新轮最大负载；若沿用2–3倍余量，轮轴目标应重新评估约0.288–0.432Nm。
不改几何文件，后续优先比较减小轮径或减速机构，并先验证电流设定。

用户实测DVDD=4.94V、VREF=1.307V，对应IFS设定0.990A。讨论换阻，尚未修改硬件或固件。
相同速度/模式下1→1.5A可粗估扭矩提升约50%，铜耗约2.25倍，非保证扭矩。
按R5=21k及VREF典型500k下拉，R4改30.9k时运行约1.477A/VREF1.950V；R6仍10k则低档约0.667A。
若R6同时改4.7k，低档约0.412A。所有计算未计阻值/芯片误差，须换后先禁能测VREF。
铭牌保持转矩0.21的励磁条件未核实；1.5A满量程在45°为每相约1.06A，不能自动等同于铭牌两相额定1.5A励磁。
当前轮负载估计0.144Nm，换阻能否上卷和热余量仍待实测，不能据此冻结方案。

用户确认实板已换R4=30kΩ（不是建议的30.9k）、R6=4.7kΩ，并重新上电。
按用户要求仅SWD置nSLEEP高；串口及寄存器确认EN=0、STEP低、SLEEP=1、LOW=0、MCU运行，中位。
此次操作无复位/烧录/播放指令，启动音乐计数为操作前已存在。等待用户VREF读数。

## 2026-10-21 改阻后负载降速：7.5 rpm / 2秒加速

用户已将R4改为30kΩ、R6改为4.7kΩ；VREF实测1.978V，对应满量程设定约1.50A（非绕组电流实测）。用户反馈旧15rpm/1秒加速固件在低速勉强上卷，达到目标速度后失步。此次将MOTOR_JOG_HZ由400改200，MOTOR_RAMP_MS由1000改2000：50→200脉冲/秒，固定1/8细分、1.8°电机下目标7.5rpm。保留按住运行、松手停止、相位保留和30秒单次上限。串口400步诊断预计约2.75秒，超时同步延长至4秒。

烧录前串口确认UP=1、DOWN=1、phase=0、EN=0。Flash完整回读与选项字节检查通过；55664字节，SHA256 06b5da688d43385c4c13df1db00288478bfccb89d7befb8bc8f3cb1271e05632。MOTOR/SW/TUNE逻辑自测均PASS，EEPROM reads=2、writes=0、errors=0。自测覆盖两个方向、限步完成、超过400步持续运行、松手停止与30秒截止；属于逻辑验证，不证明实际负载转动无失步。负载上卷效果待用户现场反馈。

## 2026-10-21 用户更换9槽轮后恢复15rpm

用户反馈7.5rpm仍失步，随后已更换9槽轮，明确要求恢复15rpm、1秒加速。固件恢复50→400 STEP Hz、1000ms线性加速；保留按住持续运行、松手停止、相位保留和30秒单次上限。串口400步诊断截止恢复2500ms。电流档位和EEPROM策略未改变；1.978V对应约1.50A满量程设定，实际运行相电流仍未测得。

烧录前中位UP=DOWN=1、EN=0、phase=0。完整Flash回读和选项字节校验通过：55708字节，SHA256 0a75998d20aff2325bcf0d9ab6f3f3fc69a40bdfe5ca549c9a17d9ad3e68865e。MOTOR/SW/TUNE自测均PASS，EEPROM writes=0、errors=0；复位后B1完成，驱动已禁用。9槽轮上卷负载测试待用户反馈，不能沿用18槽轮的负载转矩估计作为当前实测。

## 2026-10-21 9槽轮15rpm通过现场测试，升至30rpm

用户确认9槽轮可正常上卷，15rpm未失步，并要求升至30rpm测试。目标改为800 STEP Hz（1.8°、1/8微步），保留50Hz起步、1000ms线性加速、松手停止、相位保留和30秒单次上限。约1.50A硬件满量程电流设定不变。串口400步诊断预计约0.98秒完成，2500ms截止不变；自测已更新目标周期、边沿间隔与持续运行步数范围。

烧录前中位、EN=0。55700字节Flash完整回读及选项字节检查通过，SHA256 d71ba8f2cc2e0c8ddf8bd73f45e9a6a4bea7e4e7524f6700b8c652911d1b871f。MOTOR/SW/TUNE自测PASS；EEPROM writes=0、errors=0。复位B1播放完成后驱动禁用，30rpm实际负载表现待用户验证。

## 2026-10-21 9槽轮继续升至60rpm

用户试用30rpm后要求升至60rpm。目标1600 STEP Hz（1.8°、1/8微步），保留50Hz起步、1000ms线性加速、按住运行、松手停止、相位保留和30秒单次上限。约1.50A硬件满量程设定不变，EEPROM策略不变。串口400步诊断约0.69秒完成，2500ms截止不变。RAM自测同步检查625us目标周期、312/313us边沿间隔和持续模式超过400步。

烧录前确认中位、EN=0。55700字节Flash完整回读、选项字节校验通过；SHA256 41337e846f8d1560cd17f3fd61ac56553125d28a1712d5bc902502ef732d77d4。MOTOR/SW/TUNE自测PASS，EEPROM writes=0、errors=0；初始化音效完成后驱动禁用。60rpm负载运行效果等待用户现场验证。

## 2026-10-21 9槽轮60rpm现场通过，提升至120rpm

用户明确确认60rpm正常上卷、没有失步，要求120rpm测试。目标改为3200 STEP Hz（1.8°、1/8微步），保留50Hz起步、1000ms线性加速、松手停止、相位保留、30秒单次上限。电流硬件设定约1.50A不变。定时器1us量化后目标周期313us（未计ISR开销，实际转速略低于标称120rpm）；自测覆盖156/157us边沿间隔及持续运行步数。串口400步诊断约0.49秒完成，截止仍2500ms。

烧录前中位且EN=0。Flash完整回读和选项字节检查通过：55692字节，SHA256 6436b5a166b1a64f7d578ec51f28febc888cfeefe5e728a6149f784ecddab0e8。MOTOR/SW/TUNE无动作自测PASS，EEPROM writes=0、errors=0。初始化B1完成、驱动禁用；120rpm负载表现待用户验证。

## 2026-10-21 基础负载实验收尾

用户报告120rpm上卷偶尔失步，要求100rpm收尾，机械结构完成后继续到位检测。已烧录100rpm/1秒加速，两方向暂同速；完整回读、选项字节检查和MOTOR/SW/TUNE自测通过，EEPROM零写入。现场历史、下降高速候选和未验证事项见[实验汇总](2026-10-21-motor-load-summary.md)。

用户最终确认100rpm现场试验正常，保留当前100rpm/1秒加速固件；等待机械结构完成后继续到位检测。本次仅更新记录，未烧录或操作硬件。
