XJH-Jorhai/automatic-curtain-lifter/hardware/test-records/2026-10-22-product.md

# 产品固件 v1 软件完成与实板烧录（2026-10-22）

已按本次用户要求完成软件并烧入 STM32G030C8T6。机械结构尚未接入，本轮没有发送运动命令；方向差异、端点判据、实际转速和最低点偏移尚未进行真实机构测试。

## 交付版本

- 构建：`Product`，Release优化；默认 `build.ps1` / `flash.ps1` 已选择该配置。
- 最终镜像：24708字节，Flash占用37.70%；RAM 3168字节，占用38.67%。Arm GNU Toolchain 15.2.1，应用与SDK启用 `-Wall -Wextra -Werror`，编译通过。
- BIN SHA256：`ca825d501da51052089f8500e39ab574fe860338a3800c39ac28baded7b9e135`。
- 固定版本产物：`work/releases/2026-10-22-product-v1/`，含ELF/BIN/HEX/MAP及manifest。日常构建：`work/g030-mainboard-build/Product/`。
- 行为、配置与后续机械验证：[PRODUCT.md](../../firmware/g030_mainboard/PRODUCT.md)。

本地按住升降、松手立即停、App开关停止及百分比请求已共用产品状态机。未知位置初始50%、动态回报1–99%；校准采用360rpm双向试探、100rpm上端归零、360rpm下端事件、100rpm返回核对。触顶归零不累积确认期间的失步脉冲。测试动作、启动音乐、自测/串口试转和SWD测试注入入口未链接进产品镜像。

## 主机验证

执行 `firmware/g030_mainboard/test_product.ps1`，复用生产C代码及真实涂鸦SDK，使用模拟机构/GPIO/ADC。覆盖并通过：

1. 两种接线方向、完整校准、0/37/100%定位、触顶失步后归零、已达目标不再次推顶。
2. 双向均堵转/均能转、ADC超时/饱和、电气故障时不建立假行程。
3. 中断校准、重复命令不延长截止、运动中换向等待、等待期间再次改目标、途中卡阻。
4. tick回绕、搜索超时、未知进度保持1–99%、已存行程重启后先回零。
5. 加速空窗、单次低计数抗扰、相对失速阈值、旧运动反馈隔离、返回步数不一致。
6. SDK的状态查询、初始DP101=50、坏校验、未知/截断DP、百分比目标、停止、断网和关闭旧调试命令。
7. 按键去抖、第一样本松手停止、双键冲突、本地优先、250ms主循环失活、nFAULT、ADC故障。
8. 实际电机运行层的精确STEP上升沿限步和独立单段截止。
9. EEPROM新槽CRC损坏时回退旧槽、上电按住不启动、恢复行程后位置仍不可信、空闲不写入。

结果：主机测试日志（历史附件未随公开候选提供）。上述故障注入发生在主机模拟层，不是实板电气故障或机械带载测试。

## 实板烧录与只读检查

CMSIS-DAP：ICWorkshop PowerDebugger Wireless TX，UID `YOUR_PROBE_ID`。明确选择 `stm32g030c8tx`，50kHz SWD，未使用调试器广告的F407目标。

`flash_bounded.py` 完成最终24708字节全镜像回读，与BIN逐字节一致；SHA256如上。Flash选项寄存器仍为 `0xDFFFE1AA`，未操作外部EEPROM。日志：烧录与回读（历史附件未随公开候选提供）。

随后使用匹配ELF执行 `product_status.py --port YOUR_SERIAL_PORT`，不复位、不暂停、不发运动命令：

- CPU运行、SysTick递增；模块串口BRR=1667（9600），调试串口BRR=139（115200）。
- `wifi_work_state=4`：已云端在线；RX溢出、UART错误、TX错误均为0。
- ENABLE、nSLEEP、STEP、DIR、电流选择均低；无启动音效和电机脉冲。
- EEPROM业务读取2次、保存0次、错误0次，观察期内没有后台读写。
- 当前调试器枚举为 **YOUR_SERIAL_PORT**；旧COM3已不存在。首次指定COM3仅串口打开失败，随后按相同调试器UID确定YOUR_SERIAL_PORT并通过复核。

新鲜串口应答：

```text
PRODUCT phase=0 busy=0 owner=0 percent=50 target=0 range=0 known=0/0 dir=0/0 pos=0 count=0 trq=0 error=0 EN=0 SLEEP=0 key=0 ee=2/0/0
```

最终结果：实板状态日志（历史附件未随公开候选提供）。YOUR_SERIAL_PORT已关闭释放。

## 后续机构验证

机构接入后首先核对360rpm上下负载差异是否足以识别方向，再记录PA0 TRQ、STEP和实际位移以确定阈值及失速响应。当前下端补偿为0，检测到的是反卷失速事件，不能据此宣称已经准确找到帘布最低点。完成测量后修改集中配置并递增校准版本，再验证全行程、松手/停止、途中卡阻及反复到顶丢步恢复。
