XJH-Jorhai/automatic-curtain-lifter/hardware/test-records/2026-10-24-probe480.md

# 480 rpm方向试探变更（2026-10-24）

用户已装好机械结构并直接连接窗帘，反馈360 rpm上卷未观察到丢步。本次明确要求仅将方向试探提升到480 rpm，与找底、正常下放分别配置，并编译烧录，由用户观察实际运行。

## 最终结果：调整调试器参数后已烧录成功

用户随后调小调试器的无线带宽和包大小，要求重新连接；具体设置值未记录。本次未修改这些设置。

- 50kHz SWD、USB v2、4字分块：芯片身份读取正确；两次绕过缓存的2 KiB Flash读取完全一致。见 连接复测（历史附件未随公开候选提供）。
- 已烧入固定版本 `work/releases/2026-10-24-product-probe480/g030_mainboard.elf`，24720字节完整回读与BIN一致，SHA256为下文所列值，选项字节仍为 `0xDFFFE1AA`。见 成功烧录日志（历史附件未随公开候选提供）。
- 初次启动检查发现模组串口累计错误1次；按现有保护逻辑远程启动会被锁定。仅复位一次MCU后复核通过，未修改保护代码。检查时RX溢出、UART错误、TX错误均为0，CPU运行、SysTick递增、两路串口波特率正确、电机控制脚低。见 复位记录（历史附件未随公开候选提供） 和 最终状态（历史附件未随公开候选提供）。初次错误保留在 首次启动检查（历史附件未随公开候选提供）。
- 新鲜YOUR_SERIAL_PORT状态：`phase=0 busy=0 percent=50 range=0 known=0/0 count=0 error=0 EN=0 SLEEP=0 key=0 ee=2/0/0`。EEPROM仅启动读取2次、未保存，空闲观察期无后台读写，串口已关闭释放。
- 最终检查 `wifi_work_state=2`，尚未确认云端在线；本地升降不依赖云端。本轮未发运动命令，实际480 rpm试探表现由用户观察。

速度配置保持：方向试探480 rpm，找底与正常下放分别独立且均360 rpm，上卷/归零100 rpm。

## 固件修改

| 用途 | 配置 | 本次目标 |
|---|---|---|
| 方向试探A/B | `LIFT_PROBE_HZ` | 12800 STEP/s，480 rpm |
| 找底 | `LIFT_BOTTOM_HZ` | 9600 STEP/s，360 rpm，保持原值 |
| 正常下放 | `LIFT_DOWN_HZ` | 9600 STEP/s，360 rpm，保持原值 |
| 上卷/上端归零 | `LIFT_UP_HZ` | 2667 STEP/s，100 rpm，保持原值 |

仅两个方向试探段使用480 rpm。保持原1秒加速、每方向2.5秒试探、200 ms换向等待、原电流和全部停止保护。标定记录版本从1改为2，旧版记录在启动时被忽略，下一次请求重新试探，不擦除EEPROM、不上电自动运行。

480 rpm的整数定时器半周期为39 µs，对应名义约480.77 rpm；实际电机转速和失速效果尚未测量。找底仍保留原360 rpm反卷失速假设，本次没有更改该判据。

## 编译与主机测试

Product构建通过，应用与SDK启用 `-Wall -Wextra -Werror`。BIN 24720字节，Flash占用37.72%；RAM 3168字节，占用38.67%。

SHA256：`31adae63701d1c5b9cb449d45fb9416e7f151bf5d656de49b9edd456437eeaec`。

主机测试通过，包括完整校准路径逐段检查480/360/100 rpm分配，以及生产电机实现达到480 rpm定时配置后STOP不再发脉冲；原方向不明、传感器故障、松手、冲突、主循环超时和协议测试均通过。测试机构为假设模型，不证明480 rpm能区分真实窗帘方向。

- 编译日志（历史附件未随公开候选提供）
- 主机测试日志（历史附件未随公开候选提供）
- 固定产物：`work/releases/2026-10-24-product-probe480/`，ELF/BIN/HEX/MAP及manifest。

## 此前连接受阻记录（后续已解决）

以下为调整调试器参数前的失败记录；当时没有取得烧录成功或完整回读校验结果。后续成功结果见上方。

调试器USB可枚举：PowerDebugger Wireless TX，UID `YOUR_PROBE_ID`；串口YOUR_SERIAL_PORT。目标明确指定STM32G030C8Tx，自动解锁关闭。

1. 50kHz、USB v2、16字分块：在烧录前的Flash局部分析读取发生DAP `TransferError`。见 首次日志（历史附件未随公开候选提供）。
2. 同频率改4字分块：Flash比较扫描读取仍发生DAP `TransferError`。见 小块重试（历史附件未随公开候选提供）。
3. 改HID及单字传输：CoreSight SCS组件发现异常，随后复位/暂停时xPSR寄存器不可用，未进入编程。见 HID日志（历史附件未随公开候选提供）。
4. USB v2降至10kHz只读连接：未取得芯片身份/选项寄存器读数，仍报Probe错误。见 低速连接检查（历史附件未随公开候选提供）。

用户随后确认已断电重上电并重新连接。50kHz只读检查恢复，读到CPU Running、CPUID `0x410CC601`、DBGMCU_IDCODE `0x10036466`、FLASH_OPTR `0xDFFFE1AA`，见 上电后连接（历史附件未随公开候选提供）。

但后续连续传输仍失败：USB v2连接出现 `expected DAP_TRANSFER_CONFIGURE`；HID/4字分块在RAM烧录程序的写入/回读阶段出现TransferError；HID/单字读写在RAM地址 `0x20001e1c` 校验不一致，脚本中止。这些错误均发生在Flash编程之前，未取得新镜像的完整回读结果。

- 上电后USB v2重试（历史附件未随公开候选提供）
- 上电后HID重试（历史附件未随公开候选提供）
- 上电后单字传输（历史附件未随公开候选提供）

已请求将USB发射端移近窗帘旁无线接收端，或临时改用有线SWD。未以解锁、整片擦除或修改选项字节代替链路恢复。最后一次烧录尝试在Reset/Halt后中止，当前MCU运行状态尚未重新确认。

用户回复目前无法调整连接。已停止继续烧录重试，保留已通过测试的480 rpm产物。

随后只尝试一次短连接清理：计划验证旧镜像区分采样后，仅在CPU暂停时执行系统复位恢复原程序；但pyOCD在CoreSight发现阶段发生AssertionError，未进入采样或恢复复位步骤。不能确认原程序当前已恢复运行，见 恢复检查日志（历史附件未随公开候选提供）。辅助脚本为 `work/probe480_restore_idle.py`，不包含擦除/编程或运动命令。

当时需改善SWD连接后续烧，不能认定480 rpm已部署；本次调整调试器参数后已继续完成烧录和启动检查。
