XJH-Jorhai/automatic-curtain-lifter/hardware/test-records/2026-10-24-probe600.md

# 600 rpm方向试探：编译、烧录与启动验证（2026-10-24）

用户反馈480 rpm上卷仍未观察到丢步，要求将方向试探改为600 rpm，其他速度不变，并编译烧录。机械已直接连接窗帘，实际运行由用户观察。

## 交付结果

| 用途 | 参数 | 目标 |
|---|---|---|
| 方向试探A/B | `LIFT_PROBE_HZ=16000` | 600 rpm |
| 找底 | `LIFT_BOTTOM_HZ=9600` | 360 rpm，未变 |
| 正常下放 | `LIFT_DOWN_HZ=9600` | 360 rpm，未变 |
| 上卷/上端归零 | `LIFT_UP_HZ=2667` | 100 rpm，未变 |

加速仍为1秒、单向试探仍最多2.5秒、换向等待仍200 ms，电流、失速阈值和停止保护未改。标定版本更新为3，忽略旧版标定记录，下次运动请求重新试探；不擦除外部EEPROM、不上电自动运行。

Product编译及主机测试通过，BIN 24720字节，Flash占用37.72%；RAM 3168字节，占用38.67%。应用与SDK按 `-Wall -Wextra -Werror` 编译。主机测试覆盖两个方向试探600 rpm、找底和下放360 rpm、上卷和归零100 rpm的完整状态机路径，以及600 rpm稳态定时配置和STOP不再发脉冲，原安全/协议测试均通过。

1 MHz定时基准将600 rpm量化为31 µs半周期，理论STEP约16129/s，即约604.84 rpm。实际转速与失速表现尚未测量。主机模拟机构是假设数据，不证明600 rpm能区分真实机械方向。

## 实板验证

沿用用户已调整的无线调试参数，没有更改其无线带宽或包大小。明确指定STM32G030C8Tx，SWD 50kHz、USB v2、4字分块。

1. 芯片身份及选项字正确；两次绕过缓存的2 KiB读取完全一致。
2. 已烧录600 rpm固定镜像，24720字节完整回读与BIN逐字节一致。
3. SHA256：`2da09cf65571e42abdd82b66b636060a910f0f839eff9d9a59c7459785dc58b1`；Flash选项字仍为 `0xDFFFE1AA`。
4. MCU复位运行，SysTick递增；USART1/USART2分别9600/115200，UART错误、RX溢出和TX错误均为0。产品镜像不含测试动作、启动音乐和SWD测试注入入口。
5. 电机控制脚低；新鲜YOUR_SERIAL_PORT应答为 `phase=0 busy=0 percent=50 range=0 known=0/0 count=0 error=0 EN=0 SLEEP=0 key=0 ee=2/0/0`。EEPROM仅启动读取2次、保存0次、错误0次，空闲观察期无后台读写。YOUR_SERIAL_PORT已释放。
6. 检查时 `wifi_work_state=2`，尚未确认云端在线；本地开关可离线使用。本轮未发送电机运动命令，600 rpm实机表现由用户观察。

## 文件与日志

- 固定产物：`work/releases/2026-10-24-product-probe600/`，含ELF/BIN/HEX/MAP和manifest。
- 编译日志（历史附件未随公开候选提供）
- 主机测试（历史附件未随公开候选提供）
- 连接检查（历史附件未随公开候选提供）
- 烧录及完整回读（历史附件未随公开候选提供）
- 实板启动与串口检查（历史附件未随公开候选提供）
- [当前产品说明](../../firmware/g030_mainboard/PRODUCT.md)
