XJH-Jorhai/automatic-curtain-lifter/hardware/test-records/2026-10-20-music-b1.md

# B1 初始化音效：保存、烧录、试听完成

用户选择B1并授权烧录试听。B1来自A10旋律与A3的232 BPM：
`T232 C4/16 E4/8 F#4/16 R/16 Ab4/8 G4/16 R/16 B4/16 C5/4`。
7音符、2休止，含事件间隔共1177 ms。正反各3微步、低电流档。
斗地主仅保留在独立的MOTOR TUNE测试入口。

## EEPROM按需保存

通过生产Music_SaveScore更新记录，写入槽A，旧槽B保持原值。
1次逻辑保存、6次页写、8页比较跳过；连续3次重复保存全部读写计数不变。
记录CRC、缓存字符串、完整镜像及槽外未变化检查通过。
保存不触发播放。快照：2026-10-20-score-b1.bin。
EEPROM SHA256：
`4d3df98d7c0d4ce97a1d200edd660d530334363493b544c2d305cf3f800f95e8`。

## 固件与试听

v7构建：Flash51308字节，RAM链接报告3832字节。
使用64字节/50kHz分块校验烧录，此次没有重试。
完整Flash回读SHA256：
`bb83ffce3f8e5d22d4768662f967cf2efb4ee873ec2282fc80c99fdaa879709c`。
OPTR检查通过，校验后复位触发一次启动播放。

music_b1_check.py --phase verify通过：
- BOOT MUSIC STARTED。
- phase=0、count=2010、reason=1、note=9、offset=0。
- nFAULT=1，EN/SLEEP/LOW=0，正常完成后驱动关闭。
- 启动EEPROM reads=2、attempts=0、writes=0。
- 解析（含B1时长、升降号与休止断言）、往返边界、存储RAM自测通过。
- EEPROM全镜像与保存后逐字节一致。
- 空闲5秒没有主动串口输出、额外EEPROM访问或重复播放。

用户实板试听后确认：“听起来不错，就这样吧”。B1确定为当前初始化音效，
保持232 BPM、正反各3微步、低电流和约1.18秒时长。没有额外发送有效播放命令。
此启动音表示当前已启用外设初始化路径完成，不表示尚未启用的涂鸦联网成功。

日志：2026-10-20-music-b1-save.txt、2026-10-20-music-b1-flash.txt、
2026-10-20-music-b1-check.txt。
