XJH-Jorhai/automatic-curtain-lifter/hardware/test-records/2026-10-21-motor-load-summary.md

# 电机负载基础实验收尾（2026-10-21）

## 结论与当前参数

9槽轮显著改善上卷能力。用户确认9槽轮60rpm可正常上卷、未观察到失步；120rpm上卷偶尔失步，已接近本次装配条件的运行极限。按用户要求收尾目标设为100rpm、1秒加速，两方向暂用同一速度。用户随后已现场确认100rpm运行正常，并明确保留当前版本。本结论限于本次现场试验，不代表长期可靠或完整全行程验证。

保留TIM14驱动、按住运行、松手停止、驱动相位保留、30秒单次上限。固定1/8微步，1.8°电机，软件目标2667 STEP Hz，定时器量化周期375us；实际速度受中断开销影响，未用转速计测量。EEPROM仅按需读写，音乐B1保持不变。

## 现场观察

| 轮子 | 方向/速度 | 用户反馈 |
|---|---|---|
| 原18槽轮 | 上卷15rpm，改阻前约1A设定 | 轴停住抖动，无法上卷 |
| 原18槽轮 | 上卷15rpm，改阻后约1.5A设定 | 低速勉强移动，达到目标速度失步 |
| 原18槽轮 | 上卷7.5rpm，2秒加速 | 仍失步 |
| 9槽轮 | 上卷15rpm | 正常上卷，未失步 |
| 9槽轮 | 上卷30rpm | 用户试后要求继续升速；未提供完整行程/耐久结论 |
| 9槽轮 | 上卷60rpm | 明确确认正常上卷、未失步 |
| 9槽轮 | 上卷120rpm | 偶尔失步，用户要求回退100rpm |
| 9槽轮 | 100rpm收尾版本 | 用户现场确认运行正常，保留当前版本 |
| 原18槽轮 | 下降60rpm | 用户回顾确认未失步 |
| 9槽轮 | 下降120rpm | 用户确认未失步 |

以上是本次现场观察，不等于全行程、温升、寿命或所有负载条件的认证。逻辑步数不是实际位置；nFAULT不报告当前接线模式下的堵转，不能据此判定无失步。

## 硬件状态

电机铭牌1.8°、1.5A，保持转矩读数0.21（具体型号/单位仍待补）。R4=30kΩ、R5=21kΩ、R6=4.7kΩ。用户实测VREF=1.978V，按VREF/1.32换算约1.50A满量程设定；并未直接测量运行相电流。正常运动PA4低，音乐PA4高选低电流档。输入有2A保险丝；不能把输入电流与两相电流直接相加等同。

## 后续工作

本轮基础实验到此，等待用户完成机械结构后再开展到位检测和全行程测试。方向与开闭映射需结合最终装配/云平台定义，避免固定顺逆时针等同开闭。

下降允许探索更高速度，用户提出300或360rpm作为候选；尚未测试、未写入当前参数，不作为电机能力结论。后续应独立配置上卷/下降速度，逐级确认启动、匀速、停止、温升与检测余量，再确定最终下降速度。当前松手立即停，无减速停车曲线；更高速度测试需连同机械制动表现验证。

## 收尾固件验证

100rpm版已烧录，Flash完整回读与选项字节校验通过。镜像55708字节，SHA256 bf511ad7fd24f790c3b529538872a4fa418774c2a632f755c27a467730d3024a。MOTOR/SW/TUNE无动作自测均PASS；中位UP=DOWN=1、phase=0、EN=0、nSLEEP=0；EEPROM reads=2、writes=0、errors=0。只完成固件验证，不追加现场运动试验。

## 用户最终确认

用户确认“100rpm试了也正常”，要求保留当前已烧录版本。未再修改固件或操作硬件。后续等待机械结构完成，再继续到位检测。
