XJH-Jorhai/automatic-curtain-lifter/hardware/test-records/2026-10-21-tuya-baud-audit.md

# T1-3S烧录波特率原始证据核对

## 后续更正：找到历史授权9600的设置快照

### 20:29 单独授权推进至云端，因SN重复拒绝

用户截图“获取key失败SN:99”。本机cloudLog.txt 20:29:02.928明确返回success=false、errorCode=sn_already_auth、errorMsg=“SN=99已经授权，不能给不同的mac授权”。TYMZ运行日志20:28:59启动本轮、20:29:02.310记录AuthSN:99，没有本轮开始烧录记录。说明本次阻断是云端SN绑定冲突，不应再次调整桥接或重新烧录。需为当前实板使用未分配给其他设备的唯一SN，保持COM3/9600/单独授权，再由用户运行授权。若SN99必须保留，则应走平台官方记录核查/支持处理，不能把另一个设备的授权信息复制过来。本次只读日志，没有写入授权。

### 已按用户要求部署9600授权桥接

STM32 TuyaBridge专用配置改为两侧9600 8N1，普通电机应用USART2配置不变。已通过有线SWD烧录，10364字节Flash全量回读一致，SHA256 eb628276281798aa7847cbf71838c2f7e1cae67dddb8f8135eb31fb59f7534f6。独立verify_flash.py --baud 9600验证USART1/2 BRR=1667、CR1=0xd、CR2/3=0；CPU RUNNING、mode0、fault0、错误和丢弃计数0；OPTR0xDFFFE1AA未变、电机输出低。没有执行涂鸦固件烧录或授权，也没有更改工具设置。用户工具需选择COM3、授权速率9600；当前固件不再适用于115200下载。此次验证为固件回读及运行配置检查，非重新完成9600的4KB测试。

用户COM3烧录完成但进入产测失败后，发现此前未检查的归档：`D:/Program Files/TY/tools/TYPT_TYMZ/TYMZLog/2026/TYMZ 2026-09-24-21-30-39.zip`。其中settingNew.xml为成功实验后约9分钟的设置快照：BurnBaudRate=115200、AuthorizeBaudRate=9600、IdtoPortList=COM3。这是强于当前设置的历史证据，但不是授权时线上的速度抓包。下文原有“历史授权速度未找到”和建议授权115200已被此新证据修正，不应继续照做。

2026-10-21 20:17:08.884 bk_loader_COM3.log最终Writing Flash OK；20:17:08.907工具记录烧录生产区固件成功，20:17:24.101显示失败（用户截图进入产测失败00）。该轮20:17:08.399出现CheckCRC ->fail Address0x0011e000，随后20:17:08.796 WriteFlash ->pass；不能声称无任何CRC异常，也不能仅凭单次中间失败断言最终镜像损坏。

当前保存配置BurnBaudRate=AuthorizeBaudRate=115200。只读SWD检查桥接仍固定115200：PC→module rx=tx=1176254，错误/丢弃0；module→PC rx=tx=12266，framing=27、dropped=27，ORE/NE/PE=0；软件队列丢包0、fault0。错误计数为累计值，无时间戳，不能证明27次都发生在产测阶段。

首要排查是授权阶段波特率：历史成功设置9600，当前工具和桥接均115200。仅将PC工具改9600无法改变STM32 UART配置；下一步需为授权阶段同步切换桥接，且无需因进入产测失败直接重烧涂鸦固件。此次仅查日志/配置及只读SWD，未执行模块烧录、授权或改变UART配置。

2026-10-21，只读核查工具本地文件，未执行模组烧录、授权、串口通信或修改工具设置。

## 历史成功下载：115200，已确认

来源：`[LOCAL_PATH]`。只摘录不含设备凭证的信息：

- 2026-09-24 21:19:51.258：COM3，BaudRate=115200，connect success。
- 21:19:57.434：ChipId=0x7238。
- 21:19:57.820：Current baudrate : 115200 success。
- 21:20:00.573：Last 4K CRC_Verify ->pass。
- 21:21:46.135：WriteFlash ->pass。
- 21:21:46.268：Writing Flash OK。

该次时间与原烧录记录吻合，证明此前T1-3S/BK7238成功下载使用115200，不能说是9600。更早20:53和21:03的失败尝试也是115200，不与成功记录混用。

## 当前保存设置与授权证据边界

来源：`[LOCAL_PATH]`：BurnBaudRate=115200，AuthorizeBaudRate=115200，端口YOUR_SERIAL_PORT。

这是本次读取时的保存设置，不是2026-09-24授权阶段波特率的独立历史证据。旧记录证明21:21:47–51授权成功，但未记录授权波特率；所查日志中也未找到带时间戳的授权波特率字段。因此不得声称已从历史日志证明授权全程115200。

BK/Common/settings.ini还包含Baudrate=3000000，Reset_Baudrate=115200，但实际bk_loader命令和成功日志明确使用115200；不能将该通用INI中的默认值当作那次实际下载速度。

9600已证实用于烧录之后的MCU心跳/初始化协议测试，与下载波特率不同。工具中其余含9600的字段（例如ServerPort、ZigbeeEnterTest）也不是T1的烧录波特率。

## 当前操作建议

保留当前STM32固定115200桥接，不根据猜测重写为9600。云模组选择目标T1-3S产品及正确生产凭证，工序“烧录授权”，端口YOUR_SERIAL_PORT；设置中烧录波特率115200、授权波特率115200。不要勾选仅授权来替代空白模组首烧。启动运行后按下并松开SW1/CEN。成功标准仍是模组写入、CRC和授权全部通过。

115200下载有历史成功证据；当前保存的授权设置也是115200，但完整经STM32桥接的烧录授权尚未实测。如下载成功而授权阶段失败，应检查工具实际授权速度与错误摘要，不能直接把所有阶段一起改为9600。若固件实际产测要求9600，需要桥接支持阶段切换或改用可跟随变速的方案；仅改电脑COM设置不能改变STM32两侧UART。

官方T1接线页：https://developer.tuya.com/cn/docs/iot/T1-testing?id=Kefsmduu2es6x （未提供可替代本地实际日志的速度信息）。不套用其他系列或TuyaOpen工具的默认波特率。
