XJH-Jorhai/automatic-curtain-lifter/hardware/test-records/2026-10-21-tuya-mainboard-protocol.md

# 2026-10-21 实板授权完成与协议验证

20:31:51–56用户SN `osollaoos` 的单独授权成功。日志显示固件指纹匹配、读取RF标志、获取key、配置写入/回读、信道码写入/回读成功，云端相关请求success=true。未在本记录保存密钥或生产凭证。此前SN99/88为云端已有绑定冲突。

用户要求复现历史双向通信实验、实现长按5秒配网，先对照产品JSON再做App联调。历史2026-09-25记录仅实现串口P命令AP配网，没有实体5秒按键；本次新增主板PC13实现。

## 已完成

- 独立TuyaApp构建成功，Flash13568字节、RAM3088字节；SHA256 d6fafed3850a8912d2c4ba073e9471649ff86f5e9a773a2c4fbc4d0a6c38de83。
- 用户授权范围内仅烧录STM32，完整回读一致。独立检查电机EN/nSLEEP/STEP/DIR/电流选择低，OPTR0xDFFFE1AA未变。
- SWD隔离测试运行实际固件SDK与按键逻辑，退出码0；日志work/tuya-app-protocol-check.txt。PID与修订JSON相符；DP2 0/1/37/62/99/100通过，101和0xffffffff拒绝；DP101下发/未知DP/错误类型/截断/坏校验拒绝且后续心跳正常。DP1所有enum均报告停止，符合当前台架拒绝运动策略，不代表满足完整运动功能。
- 同一按键函数实板执行测试通过：去抖、4999ms不触发/5000ms触发、持续按住单次、松手可再触发、上电按住锁止及32位tick回绕。
- 诊断退出复位，CPU RUNNING、mode0、module BRR1667、console BRR139，所有UART错误/溢出0。首次真实状态读取wifi_work_state=255、rx_frames=0、PC13高，尚未收到授权后模组心跳。

## 待现场验证

已请用户关闭授权工具，短按模块CEN后，长按主板PC13独立配网键约6秒松开并报告慢闪。真实模块握手、实体按钮、App配网及上下行本轮尚未验收。固件已部署，但不能宣称全产品JSON达标：运动层/行程/实测位置尚未接入，当前电机始终禁用。

## 实体配网键与真实模组后续验证

用户确认已关闭授权工具，短按CEN、长按独立配网键后出现慢闪；主观耗时超过6秒、不超过10秒。只读SWD检查：CPU RUNNING、诊断mode0，pairing_press_events=1、pairing_button_down=0、PC13高，pairing_request_ms=161980；wifi_work_state=1（AP），bridge_rx_frames=11、bridge_last_command=0（心跳）；TX错误0、RX溢出0。累计UART错误3，包含CEN重启期间，未记录每次时间，不能断言来源或宣称全程零错误。

COM3 115200发送只读S，收到WIFI_STATE 01，与用户慢闪一致。没有重新触发配网或复位，串口观察结束后已释放。实体长按→MCU发配网请求→模组进入AP→状态灯慢闪链路通过。5秒是按键稳定按下的门槛（另有30ms去抖），灯基于模组返回状态更新；由于本轮没有按下/ACK/状态时间戳，不能精确解释额外延迟，不能把主观6–10秒当成实测触发门槛。

已请用户在涂鸦智能App以AP慢闪模式添加新主板（2.4GHz），先不测试开关/百分比，等待云端在线后再验证DP2下发及上报。App联调仍待完成。

## App配网成功、云端状态核对

用户回复配网成功。随后SWD与COM3查询均确认WIFI_STATE=04（云端在线），CPU RUNNING、mode0、requested_percent=0。真实接收帧数38（此前11），RX溢出0、TX错误0、UART累计错误仍3，无新增。按键触发累计2次，当前已松开。此快照最后命令是心跳00，未保存此前完整命令序列，不能据此单独确认已收到08全量查询。

已启动COM3被动DP日志work/tuya-app-live-dp.log，请用户将App目标设37%或告知实际设定整数，退出重进面板检查目标/位置/开关显示。待核对DP下发与状态回传，不能提前判定App双向DP通过。

## DP2与停止面板问题

App实际下发31/34/38/36，串口收到DP2对应1F/22/26/24，SWD requested_percent=36，用户确认App显示36。目标下发及显示一致通过；这不验证实际位置或所有面板控件。

随后用户报告点停止无可见响应、开关/开关帘控件无法继续，但百分比可改。读取旧固件：requested_percent=69、rejected_commands=15、wifi_state4、UART错误仍3。旧串口缓存含多次DP1 stop accepted和运动拒绝，但无时间戳，不能逐条对应用户操作。

已追加DP1输入枚举、停止接受次数和512字节实际TX缓存诊断，处理策略不变、电机仍禁用。新固件13676字节，SHA256 078a381029180272c697b8c2cd5f5ab8744175a35ef9448f109f28422d840249，已烧入STM32并全量回读一致；只复位STM32，模组绑定与授权不改。真实模块恢复state4并发08全量查询。首次检查UART错误/溢出/TX错误0，stop_update_flag=0；实际TX帧包括`55 aa 03 07 00 05 01 04 00 01 01 15`（DP1 enum stop=1，校验正确）。这证明MCU已向模块发送停止报告，不等同于云端或面板已经接受。

新固件计数初始DP1接收0；已请用户重新打开面板仅点一次停止，等待关联新日志及用户现象。日志work/tuya-app-stop-debug.log开头包含适配器残留旧串口内容，必须以新固件启动行之后为本轮；当前未确认根因、未宣称问题修复。

后续用户仍报告暂停无反应、无法操作开关。只读新固件统计：DP1接收30次，stop接受2次，运动拒绝28次，最后enum=0（open）；云端state4，UART错误/RX溢出/TX错误全部0，stop_update_flag=0。TX环形记录包含多帧合法DP1 stop=1上报。因此不能将现象描述为停止未到MCU或MCU没有回报；已确定的限制是测试固件主动拒绝运动、所有DP1回报stop。该策略足以使App开关命令无法得到所请求的open/close状态，但不单独证明面板控件为何看似锁住。暂停时没有新可见动作也不能作为通信失败判据。后续需查看App实际界面以区分等待动画、控件禁用和保持stop；完整运动验收仍需真实运动层接入，不能靠伪造open/close或实际位置消除界面等待。

## App 电机限时联调更新

用户授权将开/关/停止接入现有电机。最终固件 SHA256 83fa71d780d436f2155435db1740551e3879979592d644a205695c60a30aab57，19684 B，RAM4176 B，Flash完整回读通过。
DP1开关限时2s、停止先关闭驱动；取消DP101占位和DP2假确认。隔离SDK解析/JSON模式、错误帧、按键5s/溢出测试均通过。
实板 COM3 通过同一 DP1 handler 验证：主动停止计数328保持不变；反向命令停机；主循环300ms阻塞触发reason5，EN=0/SLEEP=0；重复关命令仍在2s达到reason6，count3686停止且重发不重启。原始记录 work/tuya-motion-validation.txt。
T安全自检包含故障状态机、2s时间回绕、GPIO禁能检查；没有人为拉低实际nFAULT。物理正反方向、App按钮解锁和终点仍需用户观察，不宣称已到位。已复位回正常应用，最终确认在线后可App测试。

### 用户 App 实机反馈
用户确认“开，中途停止有效”。这是 App 下发到实际电机停止的端到端确认。随后百分比显示自行回到0，用户未测试关；因此关闭方向和关按钮功能仍未验证。当前固件不回报未测量的DP101，App显示0不能作为实际位置证据。尚不能仅凭反馈确定0来自面板缓存、默认值或云端旧值，不应通过虚报位置解锁面板。

## 代码整合与机械阶段暂存
统一DP控制枚举、2s上限常量和状态回报入口，将控制台命令处理从串口收包轮询中分离；明确各构建预设的互斥选项。重整真实运动测试脚本，增加显式端口与--allow-motion，确保清理失败时仍保存日志。重写TUYA_APP.md为当前状态，删除与现状冲突的旧版描述。
TuyaApp、Release、TuyaBridge构建均通过，Python语法及未授权运动时不开串口的入口检查通过。本轮未烧录、未运行电机。实板仍为83fa71...已验证版；整理版a1221b...仅构建验证，ELF不可混用。机械完成后再验证到位、行程标定、百分比和App关方向。
