XJH-Jorhai/automatic-curtain-lifter/hardware/test-records/2026-10-24-probe800-music.md

# 产品固件恢复原B1开机旋律（2026-10-24）

用户要求把原开机旋律恢复到产品固件，其他参数不变，编译并烧录。本次沿用原EEPROM记录、解析器和三微步往返规则，在Product的TIM14电机驱动中接入一次开机播放。

## 保留的参数

`motion_config.h`、`motion.c`、`motion.h`及产品 `bridge.c` 的SHA256与上一版已烧录的800 rpm镜像清单完全一致。试探仍为21333 STEP/s（名义800 rpm），单向上限1500 ms；加速1000 ms、稳定等待150 ms、失速确认80 ms、换向等待200 ms不变。找底/正常下放仍为360 rpm，上卷/归零仍为100 rpm，标定版本仍为5。

正常升降保持PA4低的原约1.50 A档；开机音乐恢复PA4高的原约0.42 A档、正反各3微步、原音高/节拍和30 ms事件间隔。

## 开机播放行为

外设、产品安全服务与通信初始化后，只调用一次 `Music_PlayStored()`。读取0x000、0x100两个208字节原乐谱槽，按CRC、序号及语法选择有效记录，不保存、不补写、不擦除，不自动重试。行程仍只在初始化读取0x200、0x210两个16字节槽。

实板原乐谱为B1，完全匹配此前选定内容：

```text
T232 C4/16 E4/8 F#4/16 R/16 Ab4/8 G4/16 R/16 B4/16 C5/4
```

乐谱1177 ms，含7个发声音符、2个休止及事件间隔，另沿用2 ms唤醒和1 ms使能准备。正常结束后指令偏移归零，禁能休眠；音乐脉冲单独统计，不进入窗帘步数、行程与百分比。

上电按键占用时跳过音乐，释放后不补播；播放期间原始按键可在SysTick中立即取消音乐，稳定按下后按原逻辑升降。STOP或有效升降请求可中断音乐。音乐共用原nFAULT、主循环250 ms与时限保护，另保留原20000个音乐脉冲上限。查询、重连与空闲不触发播放。

`M`状态增加 `boot` 和 `music=状态/脉冲数/指令偏移`。`boot=1`表示开机播放已启动，`music=2`表示正常完成，3表示被中断、4表示故障；音乐正常完成的偏移为0。产品没有开放音乐串口命令、保存或测试注入入口。

## 编译和主机检查

Product按 `-Wall -Wextra -Werror` 编译通过：Flash/BIN 27076字节，占41.31%；RAM 3536字节，占43.16%。原音符解析器自测中的有符号比较补充显式类型转换，乐谱和振幅常量未改。

主机测试通过原升降、协议、按键和EEPROM用例，以及新增的真实音乐实现检查：

- 原EEPROM B1读取与播放一次，较新但写坏的槽不覆盖有效乐谱。
- 逐个GPIO边沿确认指令偏移始终在0–3微步，正常结束偏移为0，音乐步数与窗帘步数独立。
- 开机播放无EEPROM写入、无循环/重试，查询不重播；开机按键占用、空白乐谱和I2C读取失败分别在独立进程验证。
- STOP、按键、升降抢占、恢复正常运动电流、nFAULT及主循环超时停机。
- 800 rpm、1.5秒试探上限和其他速度的原回归测试全部通过。

ELF检查确认产品运动与开机播放入口存在；台架音乐试听、内存自测、音乐保存、原始试转和SWD注入入口未链接。

## 烧录及实板检查

沿用用户已调整的无线参数，USB v2、SWD 50 kHz、4字有界传输。身份/选项字正确，两次绕过缓存的2 KiB读取一致。

首次烧录受新进度显示回调影响，在pyOCD浮点累计略超1时抛出异常，中断了最终校验与复位。已在显示适配器中对有限进度值限幅并忽略非有限值，验证 `1.0000000000000004` 可安全显示为1；保留核心进度接口的范围检查。使用同一固件重新烧录后通过完整回读与复位。

- 27076字节Flash完整回读逐字节匹配BIN，SHA256为 `1aff25f51a2df31a6428cd35a98b8830952d909c035a5a9d8998990510beaefc`。
- Flash选项字仍为 `0xDFFFE1AA`，MCU运行，SysTick递增。
- RAM缓存确认原EEPROM乐谱正是上述B1；音乐状态为正常完成，累计2010个STEP指令，指令偏移0。软件状态不能替代现场听音或转子位移测量。
- EEPROM底层读取4次（行程2次、音乐2次），读取错误0、写入尝试0、实际写入0。空闲检查无后台读取/写入或再次播放。
- USART1/USART2仍为9600/115200，UART错误、RX溢出及TX错误均0。
- YOUR_SERIAL_PORT新鲜应答：`phase=0 busy=0 percent=50 range=0 known=0/0 count=0 error=0 EN=0 SLEEP=0 key=0 ee=2/0/0 boot=1 music=2/2010/0`。音乐已结束，主板当前停止休眠，YOUR_SERIAL_PORT已释放。
- 检查时 `wifi_work_state=2`，未确认云端在线；本地开关可离线使用。本轮复位触发一次开机旋律，没有下发窗帘升降命令。

## 产物与日志

- 固定产物：`work/releases/2026-10-24-product-probe800-music/`，含ELF/BIN/HEX/MAP及manifest。
- 编译（历史附件未随公开候选提供）
- 主机测试（历史附件未随公开候选提供）
- 连接检查（历史附件未随公开候选提供）
- 烧录及完整回读（历史附件未随公开候选提供）
- 启动、原乐谱及播放完成检查（历史附件未随公开候选提供）
- 首次进度回调错误（历史附件未随公开候选提供）
- [当前产品说明](../../firmware/g030_mainboard/PRODUCT.md)
