XJH-Jorhai/automatic-curtain-lifter/hardware/test-records/2026-10-24-stall-signal-investigation.md

# 2026-10-24 失速漏检现场调查

用户反馈两段方向试探失步后没有提前停止，后续仍进入试探。保留原运行现场，只读 SWD 和 M 查询，不主动发运动指令。

## 原固件证据

- 对应冻结镜像：work/releases/2026-10-24-product-workmode-v2，BIN SHA256 `115dea709afb734d7e44601e3669d7c46e38fb15b92009cfd7ff39099158d9c5`。
- 初次读回 phase=4、error=2、direction_known=0、probe_a_stalled=0、healthy_samples=16；EEPROM日志读取2、保存0、错误0。未进工作模式是方向判定失败，未发现存储写失败。
- 用户在M串口采集中再拨同一侧并确认第一段失步。第一段末段ADC约2876–2912；第二段末段约2679–2785。详情见原始采集（历史附件未随公开候选提供），约每100 ms读取，无法代表全部5 ms波动。
- 第一段加速初期有139–247及49等低值，之后回到约2880；第二段加速初期约160–274，约600 ms后升至接近3000。旧算法忽略前1150 ms，之后仅检持续80 ms低于max(64,健康基线25%)；两段高值被计入健康基线，所以都判为不失速。
- 实板 ADC_CFGR1=0x00200000，CHSELR=0xFFFFFFF0，为可编排序列第一项通道0，其余结束；PA0为模拟输入。配置未选中PB10通道11。见寄存器与状态（历史附件未随公开候选提供）。
- 不能将“机械上听见失步”直接当作TRQ已经有效报告，也不能通过把约2880直接定义为失速来确认方向。

## 验证版 v3

保持800 rpm试探、800 rpm下放、360 rpm上行，1 s加速、150 ms稳定等待、80 ms低TRQ确认和1.5 s试探上限不变。仅双向试探选板上已有PA4高约0.42 A档，正常升降和开机音乐仍约1.50 A。该设定是VREF换算，非绕组电流实测。

加入两段RAM采样，各最多160条10 ms时间戳/ADC，5 ms维护样本数和极值；不在运行中自动串口流式输出，不新增运动命令，不向EEPROM写采样。

稳定阶段若TRQ>=2600持续50 ms，视为无法辨识的高平台，明确error=11并停机，绝不把高平台作为健康或端点；ADC>=4080仍报ADC故障5。阈值2600是本次平台隔离门槛，尚非量产标定值。

TI[无传感器失速检测应用说明，4.4.3.3](https://www.ti.com/lit/an/slvaei3a/slvaei3a.pdf)说明过高速度时电流调节丢失会使扭矩计数跳变或失效，降低电流可拓宽适用速度。它与本次现象相符，但未经电流波形实测，不能断言已证明物理原因。[DRV8434A手册](https://www.ti.com/lit/ds/symlink/drv8434a.pdf)说明本板STL_MODE接地读模拟计数、STL_REP接地不通过nFAULT报告机械失速。

构建与主机回归通过，包括实际约2880平台必须提前停机、无假方向/EEPROM提交、探测低电流与正常运行电流切换、采样容量与间隔、松手竞争、EEPROM和原旋律。

验证版BIN为28152字节，RAM4864字节；SHA256 `d3f9170faf966179110735e3a556113f64d128c08107e83c40f37885407875fe`。冻结于work/releases/2026-10-24-stall-signal-v3。

通过规定flash_bounded.py/浮条入口、50 kHz SWD、4字传输完成烧录。全量28152字节读回与SHA256一致，选项字0xDFFFE1AA不变，复位运行且会话清理成功。见烧录日志（历史附件未随公开候选提供）。

烧录后只读检查：B1旋律状态2、3340脉冲、净偏移0，CPU运行，UART错误0，启动读EEPROM4次、写0，GPIO禁能休眠；M为phase=0、map=0、mode=0、low=0、probe=0/0。见启动日志（历史附件未随公开候选提供）。已请求用户再拨“上”侧约4秒，等待保留的低电流真实采样；不能将构建/烧录成功当作机械失速检测已通过。

### v3现场结果：非零失速未越过旧阈值

用户反馈“只有一段，全失步”。实板第一段采用低电流档；最后一次完整记录301个5 ms样本、150个10 ms保留点，稳定阶段35个保留点ADC范围102–124、均值114.5，无任何一个<=64。健康阈值仍160，也没有健康样本。原软件在第一段超时检查时因既不低也不健康而报error=2，未启动第二段，EEPROM仍未写入。

见RAM原始记录（历史附件未随公开候选提供）和状态（历史附件未随公开候选提供）。低电流下出现了与旧高平台明显不同的失步信号，但不能据此确认另一方向可转动；下一版必须完成两向对照。

## 修正版 v4

- 失速绝对阈值160，健康最低224，80 ms低值确认仍不变；主机回归使用实测非零115/124而非理想零值。
- 健康基线仅缓慢上调、不向下追随，防止逐渐失步的低值被重新学习为正常。独立回归覆盖基线2000逐渐降至300，必须按相对阈值停止。
- 800 rpm试探和800 rpm下放均选已有约0.42 A档，360 rpm上卷及开机旋律仍约1.50 A。为下放保留与探测相同的可测电流条件，但全程下放能力/真实下端尚未验证。
- 修正v3对单个高平台过早拒绝：一个方向可能正常时就是高计数，须完成另一向对照。恰有一向低值失速才保存方向；两向都未失速且两基线>=2600才报error=11，不保存。两向都低或其他不明确仍error=2。回归覆盖任一方向为高FREE/另一向124失速，两种顺序都能完成；两向2880均拒绝。
- 除两段试探外，再保留最近工作段的160条10 ms循环采样；5 ms总数、极值、结束原因保留。只在RAM，无后台EEPROM访问。

构建、真实产品层/驱动/SDK/存储主机测试均通过。BIN28320字节、RAM5536字节，SHA256 `7822e04adc858b23b067042eec3c47fa30e5b2d8c9113671ed9c8e4675eab809`，冻结于work/releases/2026-10-24-stall-signal-v4。烧录及实板两向验证待补。

### v4现场结果：软件识别了两向真实失步

已沿规定浮条入口烧录并全量回读、选项字核对和复位成功；B1旋律3340脉冲、净偏移0，UART错误0，EEPROM启动读取4次、写0。

用户随后反馈“两段都失步”。RAM记录与现场一致：A稳定保留点ADC110–129，B为95–109；每段在约1235 ms结束，低值连续确认后提前结束，第一段probe_a_stalled=1。B也持续低值，结束为方向不明确error=2，dir=0、saved=0、EEPROM保存0，未误存方向。这次失速逻辑确实触发，但全程0.42 A未得到能转动的对照方向。

见v4 RAM采样（历史附件未随公开候选提供）、状态（历史附件未随公开候选提供）、烧录（历史附件未随公开候选提供）、启动（历史附件未随公开候选提供）。从起步就低电流是否导致起步困难为待验证假设，不能只凭两个末段低值断定发生时刻。

## 分段电流验证版 v5

仅调整电流时序：800 rpm试探及下放，以原约1.50 A起步并完成1秒加速，到稳速后一次切到已有约0.42 A档，接着原150 ms稳定等待和80 ms低值确认。360 rpm上卷及音乐保持原约1.50 A；不在检测到失速后提高电流继续推。

主机驱动回归确认低电流选择在ramp结束前一直为0，稳速后才置1，ADC检测窗口仍在切档150 ms之后；实测非零失速、方向保存/退出探测、两向不明确拒绝保存、完整驱动/SDK/存储回归均通过。该测试不证明实际下放能转动。

BIN28344字节、RAM5536字节，SHA256 `79e874b6c8fa79d339388cb0ddb6486fef24edc1a14ba76f7db2e9f4aef04960`，冻结于work/releases/2026-10-24-stall-signal-v5，等待烧录后现场两向对照。

v5已通过规定浮条入口烧录：全量28344字节回读一致、选项字0xDFFFE1AA、复位和会话退出成功。只读启动检查为B1完成3340脉冲、偏移0，UART错误0，EEPROM读取4/写0，phase=0、map=0、probe=0/0。见v5烧录日志（历史附件未随公开候选提供）、启动日志（历史附件未随公开候选提供）。已请求用户执行本地两向验证，尚不能确认进入工作模式。

### v5现场结果：低电流导致原本正常的第二段失步

用户反馈：第一段起步转几圈后失步，失步声先大后小；第二段起步正常，进入小电流档后失步，没有进入正常上卷。

保留记录：A原电流末段约2867–2955，切档后约99–124；B原电流末段约2703–2808，1000 ms时2771，1010 ms时29，此后约82–128。两段低值持续确认，A提前结束后转B，B失速后最终error=2、direction_known=0、saved=0；EEPROM保存次数仍0。见v5 RAM采样（历史附件未随公开候选提供）、状态（历史附件未随公开候选提供）。

因此：非零低TRQ检测已能触发，但在当前机构上尚未取得同一可用电流/速度条件下的正常转动与真实失速对照。原1.50 A/800 rpm两向均偏高，小档0.42 A/800 rpm又把第二段实际拖入失步。不能把检测完成、编译/烧录或合成测试作为方向辨识通过，也不能按两个不同方向高值的微小差别直接保存方向。

当前v5以方向不明确停机，产品正常工作目标尚未完成。已向用户请求选择：改试探/下放为360 rpm做单变量对照（会改变此前明确指定的800 rpm），或保持800 rpm继续采集原电流数据。等待选择期间不再烧录或发运动命令。

## 低速对照 v6：用户同意降速/电流试验

用户回复“确实 改低转速改电流尝试一下”，选择继续降速对照。仅将试探、下放/找底目标从800改为360 rpm，电流时序与v5相同：原约1.50 A完成起步和1秒加速，稳速后切约0.42 A并等待150 ms。正常上卷仍360 rpm/1.50 A，音乐仍原参数，80 ms确认、1.5 s试探上限、换向200 ms及日志格式均不变。

目标是寻找同一360 rpm低档下“上卷失步、下放持续转且TRQ可分”的工况，当前不能据预期判定成功。阈值160/健康224源自此前800 rpm数据，也须核对360 rpm实际信号。

编译及全部主机回归通过，实际驱动360 rpm量化52 us半周期、1 s加速末端之前保持原电流、稳速后才切低档、精确脉冲截止/松手/故障/EEPROM等测试通过。BIN28332字节、RAM5536字节，SHA256 `9ec501d4c30ca40a896bf6484a1112a7058571595d8a31fb48c2de834bdf3f6b`，冻结于work/releases/2026-10-24-stall-signal-v6。正在沿规定入口烧录。

v6烧录已完成：全量28332字节回读一致、选项字0xDFFFE1AA、复位及会话清理通过。启动只读检查B1完成3340脉冲、偏移0，GPIO禁能，UART错误0，EEPROM读取4/写0，等待首次定义上触点。见v6烧录（历史附件未随公开候选提供）、启动（历史附件未随公开候选提供）。已请求用户观察第二段是否切低档后实际失步，或仍顺畅但被当前阈值误判停止。

### v6现场结果及纯软件方案

用户反馈“两段都实际失步”。A在原电流的加速末段ADC165–211，切0.42 A后稳定阶段24–48、均值37.6；B原电流末段237–267，切档后稳定阶段3–10、均值6.4。两段均被判失速，最终方向不明确error=2，无方向保存。见v6采样（历史附件未随公开候选提供）及状态（历史附件未随公开候选提供）。首次状态读取处于B进行中，随后采样读取及M查询已结束，不能把整份输出当作同一瞬时快照。

曾建议R6由4.7 kΩ改10 kΩ，在R4=30 kΩ、R5=21 kΩ及原VREF实测1.978 V下，低档估算从约0.42 A提高至约0.68 A。用户问“有没有不改的方案”，因此未实施电阻改动，原硬件数值不变。当前两档GPIO和无VREF滤波的硬件不能直接当作可调中间直流电流源使用。

## v7：固定原电流、360 rpm，采集真实上端

用户确认“第一段上卷、第二段下放”，对应DIR=0上卷、DIR=1下放。本轮不再靠低电流两向失步推断方向，使用独立 `TrqCapture` 构建验证同一约1.50 A、360 rpm下的正常上卷和真实到顶TRQ对照，不改硬件。原产品默认构建仍保留v6实验参数，未将采样模式设为默认。

采样版全程原电流、不切低档；方向人工确认，只允许本地按住运行，松手停止；远程运动拒绝、STOP及故障保护保留。启动不使用旧行程，方向、开关和端点仅保留RAM。EEPROM写入函数及音乐保存函数未链接。原B1旋律参数不变。

失速门槛暂为max(64,本段基线25%)持续80 ms、健康最低128；依据先前正常上卷加速末段约165–211预留对照范围，真实到顶能否跨过门槛尚未验证，不能据此宣布已修好。加速1秒及稳定等待150 ms不变。最近工作段保留160个10 ms环形点，5 ms维护极值/样本数。

TrqCapture及默认Product均编译成功，主机回归全部通过；采样模式的180正常/16失速是合成输入，只证明软件路径。BIN26820字节、RAM5512字节，SHA256 `55ec8e6f4ae486a4d2d3c1f2a9c130a5b894d2a14a096013f85e967dc01319b8`，冻结于work/releases/2026-10-24-trq-constant-v7。

沿规定浮条入口完成烧录，全量26820字节读回一致、选项字0xDFFFE1AA、复位运行及会话清理通过。只读启动检查CPU运行、GPIO禁能、音乐DONE/3340脉冲/净偏移0、UART错误0、行程读取2/保存0，M为phase=0、map=0、mode=1、saved=0、low=0、capture=1。mode=1来自本轮人工方向确认，非自动学习成功。

证据：采样构建（历史附件未随公开候选提供）、默认Product构建（历史附件未随公开候选提供）、主机回归（历史附件未随公开候选提供）、烧录（历史附件未随公开候选提供）、启动（历史附件未随公开候选提供）。已请求用户按上侧到真实顶部，若失步后约0.2–0.3秒仍未停则松手；待读取同工况现场采样。

### 2026-10-25 用户到顶反馈

用户称到顶失步一段时间后停机，随后又反复试验数次。只读RAM已有top_known=1，说明程序曾进入上端判定路径；但最新工作轨迹已被0–114 ms短拨覆盖，result=4/error=1为松手停止，无法从中确定先前到顶时延或判据。没有更改参数或重新烧录，已请用户先离开顶部、只做一次连续上卷并保留停机现场。详见[本次现场记录](2026-10-25-trq-constant-v7-observation.md)。

### v8固定电流滤波版：上端已取得现场对照

用户单次重做v7后确认自动停约1秒。RAM端点事件及真实波形对应：正常约190–260、失步主要4–131；原门槛64的连续确认被上冲反复清零，明显下降至停止约885 ms。独立采样构建新增5点中位数、50%相对门槛，原80 ms确认、1150 ms起步屏蔽、360 rpm/约1.50 A、音乐和EEPROM只读不变。实测保留波形回放、全部回归及两个构建通过，已烧录并全量读回核验。

v8用户确认明显变快至约0.1–0.2秒，RAM的UP自动快照result=2/error=0，首次明显低值1351 ms、停机1441 ms，与观察吻合。此次上端可用信号及检测路径已确认，下端和自动方向识别仍待验证。后续见[v8现场记录](2026-10-25-trq-filter-v8.md)。
