XJH-Jorhai/automatic-curtain-lifter/hardware/test-records/2026-10-24-workmode-v2.md

# 工作模式v2：首次开关学习、方向立即保存及增强开机音（2026-10-24）

用户确认800 rpm可稳定产生失步，要求首次拨动代表“上”，按住完成方向检测；检测未完成松手立即停止，下次重新检测。方向成功立即保存EEPROM，随后按开关正常工作，上行360 rpm、下行800 rpm，失速分别记录上/下边界。同时反馈开机声音仅2/10，希望提高到7/10。

## 实现

- 首次稳定拨动的物理触点定义为“上”，另一个为“下”，不预先固定PC6/PC7语义。未完成检测就松手，不保存部分方向；同次上电首次触点绑定保留。下一次拨动从DIR=0重新试探。
- 800 rpm双向试探仍为每向最多1.5秒，含1秒加速、150 ms稳定等待，失速确认80 ms；另一向需至少16个健康样本。恰有一向失速才确定上卷方向，双向相同或证据不足停止、不保存。
- 方向成功后先停机，立即保存电机上卷方向与开关上触点，不再等待全行程。保存验证后按当前开关进入工作模式；后续上行360 rpm、下行800 rpm，无自动全程往返校准。
- 工作上行失速归上端、下行失速归反卷下端，符合本轮用户指定的机械假设。先到上端或先到下端均可学习；保留中途停止的相对坐标，在两个端点相继建立后得到步数行程。采用第一次低TRQ时的计数，排除确认期间脉冲。
- 已确认方向/端点事件不会被随后松手撤销；重复相同已知边界只校正RAM位置，不重写EEPROM。重启恢复方向、开关含义与已知行程，当前位置重新置为不可信，向任一实际端点确认后恢复。
- 方向未通过首次本地操作学好前拒绝远程运动；中间百分比定位需行程及当前位置可信，端点目标0/100继续可用于学习。初始50%、未知运动1–99%的回报保留；普通舍入不能伪造0/100。

## EEPROM记录与保护

记录升级为LW版本6，0x200/0x210两个16字节槽交替存放。字段包含电机方向、上触点、上下端已发现标志、有效行程标志、序号、行程及CRC32。方向单独识别成功即构成有效记录；旧版LF/版本5记录启动忽略，未擦除任何EEPROM。

专用 `Eeprom_UpdateLiftRecord` 只允许上述两个16字节槽，保留单页比较、差异写入、回读和每次上电8次尝试上限。方向/首次端点/首次行程属于独立事件，可在60秒内分别提交；普通更新API仍保持60秒冷却。相同状态在RAM中判重，空闲、查询、周期轮询均不访问EEPROM。

写入失败停止并报告错误，不自动重试；下一次明确按键/有效请求可重试未保存状态，RAM中已确认方向继续保留，不重新探测。失败写入占用尝试额度。损坏的新槽不会覆盖旧有效槽。

## 开机声音试听档

保留原EEPROM B1旋律、音高、节拍和1177 ms乐谱（含事件间隔），每次开机一次，启动不写入EEPROM。为增加音量，音乐从原约0.42 A改为已有约1.50 A工作档，正反各3微步改为各5微步，往返频率保持音高。普通运动电流不变。

7/10为用户提出的听感目标，没有声压或响度标定，实际等级待现场试听。正常播放完成指令偏移归零；按键、STOP、升降、nFAULT及主循环故障可中断声音。音乐脉冲不计入窗帘位置。

## 软件验证

Product编译通过，应用/SDK使用 `-Wall -Wextra -Werror`。Flash/BIN 27612字节，占42.13%；RAM 3544字节，占43.26%。核心运动文件修改前已备份至 `work/before-direction-workmode/`，通过完整替换补丁更新。

主机测试使用真实状态机、产品运行层、音乐、涂鸦SDK和EEPROM代码，模拟GPIO/ADC/I2C：

- 两种电机方向、两种端点学习顺序；方向先于任何端点保存，工作速度360/800，完整行程和37%定位。
- 首次PC7定义上、未完成松手、改拨相反触点重试仍保留原上触点；立即保存方向独立记录，重启直接工作不再探测。
- 检测成功后松手保留待保存结果；写失败停止、无后台重试，下次明确拨动重试保存。
- 松手恰好发生在最后一笔方向确认ADC采样中时，禁止使用过期反馈误判成功/保存，下一次从探测A重来。
- 分阶段保存上端/下端/行程，重复状态零写入；端点附近舍入仍不伪造0/100。
- 模糊方向、ADC故障/饱和、nFAULT、1.5秒试探上限、200 ms换向、主循环超时、松手/冲突及tick回绕。
- 真EEPROM实现的普通60秒冷却、连续学习事件、8次共享额度、失败额度、同值跳过、音乐槽保护和新槽掉电写坏保留旧槽。
- 增强B1的5微步往返、相同乐谱时长、GPIO边沿平衡与音乐/升降互斥，所有原协议和安全用例通过。

## 烧录及只读实板验证

沿用用户无线设置、USB v2、SWD 50 kHz、4字有界传输，经项目进度浮条入口烧录。身份、选项字正确，两次不经缓存的2 KiB读取一致。

- 27612字节完整Flash回读与BIN逐字节一致，SHA256为 `115dea709afb734d7e44601e3669d7c46e38fb15b92009cfd7ff39099158d9c5`。
- 选项字仍为 `0xDFFFE1AA`，MCU复位运行、SysTick递增。
- 原EEPROM B1正确加载，增强播放正常结束：3340个音乐STEP指令，指令偏移0。实际声压/转子位移未测量。
- 正常启动总EEPROM读取4次、读取错误0、写入尝试0、实际写入0，空闲观察无读写或重复播放。
- 模组UART 9600、调试UART 115200，UART错误、RX溢出、TX错误均0。
- 新鲜YOUR_SERIAL_PORT状态：`phase=0 busy=0 percent=50 known=0/0 dir=0/0 count=0 error=0 EN=0 SLEEP=0 key=0 ee=2/0/0 boot=1 music=2/3340/0 map=0 mode=0 ends=0/0 saved=0`。
- 当前为首次开关学习前的停止状态，YOUR_SERIAL_PORT已释放；本轮没有发送升降/方向检测命令。首次上触点定义和真实方向/边界学习由用户拨动触发，成功后代码按上述规则存储。
- 检查时 `wifi_work_state=2`，未确认云端在线，本地控制可离线使用。

## 产物与日志

- 固定产物：`work/releases/2026-10-24-product-workmode-v2/`，ELF/BIN/HEX/MAP及manifest。
- 编译（历史附件未随公开候选提供）
- 主机测试（历史附件未随公开候选提供）
- 连接（历史附件未随公开候选提供）
- 烧录及完整回读（历史附件未随公开候选提供）
- 启动与状态（历史附件未随公开候选提供）
- [产品说明与操作](../../firmware/g030_mainboard/PRODUCT.md)
