XJH-Jorhai/automatic-curtain-lifter/hardware/test-records/2026-10-25-product-v15.md

# 2026-10-25 产品v15：边界外微调持续按住运行

用户反馈越过已保存边界后，钮子微调只运动一段距离就自动停止，要求持续移动直到移开钮子。原因是此前微调段固定4799微步，与实体短按的三圈端点修正规则共用数值来源；本次移除的是微调运动配额，三圈分类规则保留。

## 修改

- 微调运动不再设置4799微步截止，使用现有电机驱动steps0持续运行方式。保持同一触点就持续点动，松开/冲突在SysTick中立即停止；整个微调段不进入1秒自动运行。
- 已经严格超出上/下校准边界时，两方向输入均进入手动微调，反向返回校准范围后仍保持点动直到松开，不在途中变成自动运行。
- 移除按已知物理顶坐标禁止上微调的分支，明确的向上输入不会被换成向下回到软上端。实际TRQ堵转、nFAULT、ADC、主循环失活及现有全局时间/计数/坐标保护保持。
- 正常本地到保存端点仍停止并消费该触点；稳定回中位后再同向拨动才进入明确微调。App百分比和0/100仍按保存边界定位，不越界微调。
- 仅运动不自动改写校准，仍须App保存端点或实体配网键短按。LW9、物理顶偏移、按钮自动复位、360rpm/约1.50A和原B1不变。

“持续按住”取消的是旧微调距离配额，并未取消实际故障/堵转或全局保护。主机已测试通过旧配额，实际机械仍受真实行程限制，不以堵转期间的指令脉冲声称实物转动距离。

## 验证与镜像

完整主机回归通过，复用真实SDK、运行层和电机驱动。新增上下持续微调超过4799/15000/40000脉冲、长按仍auto0、松开首个1ms样本停止、已越界重复点动、反向立即停/保留1秒换向等待、跨回保存边界仍点动、TRQ/nFAULT仍停、无自动EEPROM写；正常端点、App、校准/重启参考、按钮复位和原保护回归均通过。

Product Release：BIN33020字节，RAM5640/8192；SHA256 `6c69ccad777fedccad6a9e1fbea392c148584ec80829aebc2da27050ba7f8a55`。冻结在 `work/releases/2026-10-25-product-v15/`，manifest记录相关源码散列。ELF审查通过，LiftMotion仍120字节，无bench/通用EEPROM写/音乐保存入口。

日志：[构建](2026-10-25-product-v15-build.txt)、[回归](2026-10-25-product-v15-tests.txt)。

## 部署

烧录前只读确认空闲、触点释放，保留用户最新LW9序号12/槽0/flags126、199275微步跨度、2950物理顶偏移、manual3，存储及通信错误0。初始基线（历史附件未随公开候选提供）、烧录前复核（历史附件未随公开候选提供）。

规定flash_bounded入口烧录完成，session `e40c81a86d4549d89cdf1a7cf079177a`，耗时101.344秒。33020字节完整读回/SHA256一致，选项字0xDFFFE1AA保持，复位和会话清理成功。烧录日志（历史附件未随公开候选提供）。本次浮条曾显示interrupted，与后端done结果不一致；已通过API关闭，并由status确认ui.open=false，不以浮条显示代替烧录结果。

启动恢复199275跨度、2950物理偏移、LW9序号12/槽0/flags126/PC7上/manual3，读取4次、写入/尝试/存储错误0，原B1完成3340脉冲/净偏移0。首次启动UART接收错误1使原通信故障锁生效，因此未立即交付App测试；空闲软件重启后复查UART/溢出/TX错误均0，云端4/link_fault0、空闲无故障，校准和序号保持，启动零写入。没有修改通信故障处理代码。见首次启动（历史附件未随公开候选提供）、初始日志（历史附件未随公开候选提供）、复位前后（历史附件未随公开候选提供）、复查（历史附件未随公开候选提供）。

## 实物验收

已请用户在有实际机械余量的校准边界处验证：回中位后同向保持2–3秒再松开，确认取消原短距离自动停且松开立即停，不要求修改现有校准。用户回复“正常”，持续微调验收通过；同时提到重启后的首次找物理上边界容易误解。

两次只读观察分别记录了尚未建立位置参考时的普通本地动作、首次App关闭命令触发找顶，以及随后空闲在下端0%的状态。观察窗口没有完整捕获一次超过旧配额的实物微调，不将主机脉冲测试或这些普通运动记录当作该实物位移的独立测量。见观察1（历史附件未随公开候选提供）、观察2（历史附件未随公开候选提供）。两次观察均已正常结束。

验收后只读复核：空闲、运动及通信错误0、position=travel=199275、目标/进度0%、参考已知；保存记录仍为LW9序号12/槽0/flags126、跨度199275、物理顶偏移2950、manual3，EEPROM写入/尝试/错误0。最终快照（历史附件未随公开候选提供）。源码散列及冻结BIN散列均保持一致。

当前重启策略未改：恢复校准范围和物理顶偏移，但当前位置未知；首次需要定位的App运动通常先找物理顶一次，再到原校准范围内的目标。没有开机自动运动，同次上电位置可信时不重复找顶。后续可考虑停稳位置保存配合运动中标记，让正常停稳后的重启直接恢复；这依赖断电期间机构不被外力移动。此方案仅作解释，本次未实现。
