XJH-Jorhai/automatic-curtain-lifter/hardware/test-records/2026-10-25-trq-constant-v7-observation.md

# 2026-10-25 固定电流采样版现场反馈

用户反馈“到顶失步过了一段时间后停了”，并说明之后反复试验数次、拨钮方向曾反。当前不据拨钮名称推断实际运动方向，继续以实物运动与RAM证据对照。

沿用已烧录的v7（360 rpm、原约1.50 A固定电流），只读SWD提取RAM，串口仅发送M查询；不复位、不暂停、不发运动指令、不写EEPROM。CPU运行，FLASH_OPTR为0xDFFFE1AA，UART错误0，行程读取2/保存0，capture=1。

## 本次可确认的证据

- RAM中 `top_known=1`。采样版启动强制清除旧行程且不从EEPROM恢复端点，因此本次上电后程序至少进入过一次上端判定路径。该标记尚不能证明与用户描述的真实到顶事件对应，也不能量化延迟。
- 最新状态为 `phase=0 error=1`，最近工作轨迹 `generation=49 result=4 error=1`，即松手/用户停止。最近驱动DIR=1、全电流，最终72个指令脉冲；最后采样点对应66个脉冲。
- 最新轨迹只保留12点（0–114 ms）、24个5 ms样本，ADC41–73。该段全部在1150 ms启动屏蔽窗口内，没有稳速的正常/失步对照。当前baseline=0，healthy_samples=0。
- 工作轨迹每个新段都会覆盖上一段，所以最近短拨已经替换先前到顶记录。`low_at`/`low_count`没有在新段清零，但当前 `low=false`、`event_count=0`，不得用这些残留字段计算之前那次到顶的停止时延。
- 当前 `position_known=0 range_known=0 saved=0`，无可信行程，也没有将本次采样当作方向学习成功保存。

原始证据：只读状态（历史附件未随公开候选提供）、RAM轨迹（历史附件未随公开候选提供）、离线摘要（历史附件未随公开候选提供）。

## 后续采样请求

已请用户按实际运动方向先下放一小段离开顶端，再仅做一次连续上卷到顶；自动停或松手结束后先不再次拨动，报告自动停止/松手停止及约几秒延迟。待读取完整记录后，再决定是否修改启动屏蔽或稳态判据。目前未更改参数、未重新烧录，不能宣布端点检测已验证通过。

## 单次重做结果：真实到顶与TRQ判据对应

用户重做后反馈“自动停，一秒左右”。立即只读提取，CPU继续运行，EEPROM保存0、错误0，UART错误0；工作轨迹generation=51、result=2/error=0，运动状态endpoint=TOP、position=0、position_known=1、estimate=100。这次是软件低TRQ端点事件结束，不是松手或超时。

正常上卷最后约0.7秒大多ADC190–260（首次明显下降前保留点范围177–264），15662 ms首次明显跌至96，此后主要4–131且夹有185的短暂回升。旧判据max(64,245×25%)仍为64，每次高于64即清除连续80 ms计时。低值最终持续确认起点为running_ms约16467，停止约16547 ms；从15662 ms明显下降至停止约885 ms，与用户“一秒左右”相符。770个额外指令脉冲约等于末段80 ms确认；不能把指令脉冲当作已测转子位移。

这次动作运行约16.5秒，早已超过1150 ms起步屏蔽，所以本次延迟不是加速窗口导致，而是阈值与连续判定被波动反复重置。它证明当前固定电流360 rpm在这一次真实上端事件中具有可用的正常/失步信号差异；尚不能推广为所有位置、下端及自动方向识别已通过。

证据：单次到顶状态（历史附件未随公开候选提供）、保留波形（历史附件未随公开候选提供）、离线摘要（历史附件未随公开候选提供）。完整160点已导出为主机回归夹具 `firmware/g030_mainboard/tests/data/trq_top_2026_10_25.h`，不插值未保留的5 ms样本。
