XJH-Jorhai/automatic-curtain-lifter/hardware/test-records/2026-10-25-trq-filter-v8.md

# 2026-10-25 固定电流TRQ滤波版 v8

## 问题与改动

v7单次真实到顶已由用户观察和RAM端点事件对应，原约1.50 A/360 rpm下正常TRQ约190–260，失步后主要4–131。绝对门槛64、相对25%以及连续80 ms低值判定被失步期间的上冲反复重置，从15662 ms明显下降到约16547 ms停止，约885 ms。详见[v7现场记录](2026-10-25-trq-constant-v7-observation.md)。

仅对独立 `TrqCapture` 构建调整端点判据：

- 5 ms ADC的最近5点取中位数，抑制少量高/低毛刺；健康基线和失步比较使用同一滤波值。
- 相对门槛改为健康基线50%，绝对门槛64、健康最低128、连续确认80 ms不变。滤波窗口每段重置，仍屏蔽起步1000 ms及其后150 ms。
- ADC上限故障直接使用原始值，不被滤波掩盖。松手/同时上下/驱动故障/主循环失活等原保护保留。
- 采样版不做双向探测，复用原探测RAM槽0/1，分别保留最近一次上/下自动停机波形；槽2仍是最新工作段。手动短拨不覆盖自动停机快照，不增加EEPROM访问。
- M增加 `trqf` 滤波值。只读提取脚本按ELF结构大小自动兼容v7的96字节与v8的112字节运动状态。

360 rpm、全程原约1.50 A电流、DIR0上卷确认、首触点语义、原B1音乐、EEPROM只读及仅本地开关运行均保持v7。默认Product仍关闭采样模式，保留v6实验判据及分段电流；本轮不烧录默认Product。

## 验证与边界

主机复用真实motion实现回放v7保留的160点10 ms实测波形，不重建未保留的5 ms点。在不同先前健康基线0/180/245/265下，都在15772 ms触发，即首次明显下降后110 ms；所有此前正常点不误判。此结果仅为保留波形回放，不是新固件的现场时延保证。

另覆盖短低值、两点高毛刺不误停或抬高基线，换段清滤波状态、原始ADC轨顶故障和启动屏蔽。完整产品/驱动/SDK/EEPROM回归通过，采样运行层测试确认上下自动停机记录经手动短拨仍保留、远程运动拒绝、全部2048字节模拟EEPROM不变。

默认Product和TrqCapture均编译成功，无本次构建警告。采样ELF中EEPROM写入、音乐保存及bench动作符号缺席；结构与只读提取脚本一致。采样BIN27052字节、RAM5528字节，SHA256 `2219e0835dd857588d6df44598324e97d6e42e499437d757966d7fc903501804`。

冻结：`work/releases/2026-10-25-trq-filter-v8/`。沿规定浮条/flash_bounded.py入口，50 kHz SWD、4字块完成烧录；全量27052字节读回SHA256一致，选项字0xDFFFE1AA、复位及会话清理通过。启动只读检查CPU运行、GPIO禁能休眠、B1完成3340脉冲净偏移0、UART错误0、行程读取2/保存0、capture=1。

日志：采样构建（历史附件未随公开候选提供）、默认构建（历史附件未随公开候选提供）、主机回归（历史附件未随公开候选提供）、烧录（历史附件未随公开候选提供）。

## 实板上端验证

用户反馈“明显变快，约0.1–0.2秒”。立即只读提取：UP自动快照和最新工作段均generation=5、result=2/error=0；位置0、端点TOP、percent100，方向DIR0、全电流，保存0，UART错误0。原始末值116，而滤波值35，说明波动已不会直接重置低值确认。

稳速正常保留值大多约190–230，1351 ms下降至89、1361 ms为75，此后主要5–59，末点1441 ms偶发116；本段健康基线223，对应门槛111。首次低值连续确认起点running_ms约1361，停机约1441 ms，从首个明显低值到停止约90 ms，符合用户观察。实际机械到顶时刻没有外部传感器时间戳，不把该90 ms当作精确的机械响应标定。

该动作约1.44秒，正常稳速及低值均在1150 ms屏蔽窗口后。上/下快照槽中，上槽已保留自动停机；下槽为空。当前可信上端、无完整行程、无下端，EEPROM保持零保存。

证据：启动（历史附件未随公开候选提供）、现场状态（历史附件未随公开候选提供）、RAM波形（历史附件未随公开候选提供）、离线摘要（历史附件未随公开候选提供）。已请求用户从当前上端下放，观察到底反卷后是否很快自动停止；若反卷仍持续抬升则松手，不等再次卷回顶部。下端及自动方向识别尚未通过，继续使用只读采样版。

## 实板下端验证与RAM行程

用户随后反馈“到底反卷后很快自动停”。立即只读提取，DOWN自动快照与最近工作段generation=7、result=2/error=0；上端快照generation=5仍完整保留。DIR1、全电流，末值67、中位数79、健康基线278，对应门槛139。

末段正常保留点大多约170–240，26789 ms首次明显降至42，此后9–84；滤波低值确认起点running_ms约26799，约26879 ms停机。保留波形明显下降到停止约90 ms，与用户观察对应，外部机械到达时刻仍无传感器时间戳。

以此前可信上端为坐标原点，本轮首次低值处的指令步数250585被记录为行程；完整停止时指令251347，排除80 ms确认期间约762个指令脉冲。RAM为 `range=250585 known=1/1 ends=1/1 endpoint=BOTTOM position=250585 percent=0`。这是基于用户观察端点及命令步数的行程估计，不是编码器实测；下端参考仍为反卷检测位置，最低点补偿默认0。

EEPROM保存仍0，UART及存储错误0，CPU运行。当前采样固件已有一次真实上/下端对照，通用自动方向识别尚未验证，方向仍为用户先前人工确认的DIR0上卷。

证据：下端状态（历史附件未随公开候选提供）、上下快照及工作波形（历史附件未随公开候选提供）、离线摘要（历史附件未随公开候选提供）。已向用户提出产品行为选择：采用已确认方向恢复产品和EEPROM保存，或继续研究自动方向识别并暂留只读采样版。在收到选择前不改方向流程、不写EEPROM、不重新烧录。
