XJH-Jorhai/automatic-curtain-lifter/hardware/test-records/2026-10-25-product-v11.md

# 2026-10-25 产品v11：1秒自动运行与涂鸦百分比

用户确认v10手动校准正常，要求先核对保存，再实现钮子1秒自动运行、反向立即停止及延时换向，并接通现有涂鸦开停关/百分比控制，最后由用户验收；先暂停原定调研。

## 已有校准核对

只读现场得到manual3、range196823、known1/1、saved1、map2、LW8序号6/flags126/槽0；EEPROM本次启动3次保存、0错误。上下快照都为result6，证明最近两次按已存脉冲边界停止。用户更正了“操作中出现异常”的误回复，并确认校准后可以正常到点。校准后状态（历史附件未随公开候选提供）、保存核对（历史附件未随公开候选提供）。

## 实现

- 起步经过30 ms消抖，运动开始满1000 ms进入自动；回中位继续到端点，之前松手则首次SysTick样本禁能。
- 反向触点首次SysTick即停，持续1000 ms才反转，提前松开取消；反转后重新计1000 ms才自动。两触点冲突、PC13、STOP和故障取消，端点保持按住不自动进入微调。
- 持有本地触点时优先，已回中位的本地自动运行可被App接管；App行进时反向本地触点同样立即停和延时反转。
- 现有DP1(open0/stop1/close2)、DP2目标和DP101当前位置接入同一运动规划。查询/状态回报包含三个DP，进行中DP2为接受目标，DP101为当前估算，停止后两者对齐；进度500 ms限频，状态/目标变化及时报告。
- 已保存行程但当前位置未知时，首次云端请求先找顶恢复参考，停200 ms再定位。找顶期间目标更新不重复起步；STOP、本地操作及掉线均取消后续动作。已知位置直接计数到点，部分百分比途中失步按障碍处理，不覆盖校准。
- PID、云端DP定义和面板不改；新计数仅为只读RAM诊断。360 rpm/约1.50 A、TRQ判据、B1和LW8保存策略保持原值。

## 软件验证与构建

真实motion、产品运行层、定时器驱动、Tuya MCU SDK的主机回归全部通过，包含999/1000 ms门槛、首次/反向两次计时、1 ms原始反向停止、提前松开取消、持续保持到端点不微调、按钮/故障/冲突停止和tick回绕。

通过真实Tuya帧校验/解析验证DP1开停关、DP2目标/DP101进度区分、三DP查询/停止快照、重启先找顶再到62%、找顶期间更新目标不重启、200 ms换向等待、STOP取消后续定位、37%精确脉冲定位、0/100计数边界、本地/App接管、失联停机和途中障碍。校准及EEPROM策略旧回归、原始TRQ波形回放亦通过。

Product Release构建通过，BIN31208字节、RAM5600/8192，SHA256 `b931f55135b7587403c63ce513a1bad2b2ca6855fdfdea3e58a7c66273c75537`。冻结目录work/releases/2026-10-25-product-v11。ELF核对产品按键/校准/DP路径完整，未链接bench注入、通用EEPROM写或音乐保存入口，LiftMotion仍112字节。

日志：回归（历史附件未随公开候选提供）、构建（历史附件未随公开候选提供）。

## 部署与验收

规定浮条入口烧录完成，session36e87bf9196942ffaae6c157e2fd9a73，SWD50 kHz、4字块。完整31208字节读回SHA256一致，选项字0xDFFFE1AA保持不变，复位和会话清理通过。烧录日志（历史附件未随公开候选提供）。

启动只读检查通过：CPU运行，phase0/error0/EN0/SLEEP0，home0/auto0/reverse0；恢复相同196823微步、manual3、PC7上、LW8序号6/flags126。EEPROM读取4次、保存/尝试/写入均0、错误0；B1完成3340脉冲、净偏移0。模组仍为wifi2，UART错误/溢出/TX错误为0，初始云端指令计数为0。启动（历史附件未随公开候选提供）、日志恢复核对（历史附件未随公开候选提供）。

烧录前模块回报wifi_work_state=2，未连接路由器，UART错误/溢出/TX错误均0；App实物验收需恢复此前网络或长按PC13五秒配网。没有为验证主动发送运动指令，实际钮子及App验收待用户执行。

已向用户分别提供钮子和App两项验收步骤：先本地向上保持1秒后回中位并等到顶，再测试下放途中反拨立即停/保持1秒反转/重新1秒自动；网络恢复后测试开停关和37%/62%。物理验收结果待用户回复，不以主机协议回归替代端到端App实测。

用户随后回复“钮子功能通过”，本地操作已完成实物验收。只读核对时设备空闲无故障、方向和PC7上触点保持，manual3/saved1；最新行程202363微步，LW8序号7/槽1/flags126，本次启动1次校准保存、0存储错误。当前下端0%、当前位置可信，auto0/reverse0/home0；UART错误/溢出/TX错误均0。未复位或烧录。该行程为验收过程中最新保存值，前文196823为烧录前及启动恢复值。

模组仍回报wifi2，控制和百分比下发计数均0，App端到端验收继续等待联网及用户反馈。钮子验收后状态（历史附件未随公开候选提供）、最新保存日志（历史附件未随公开候选提供）。

用户重新配网后要求复查。相隔约53秒的两次只读采样均为wifi_work_state3（SDK WIFI_CONNECTED，已连路由器），尚未回报4（WIFI_CONN_CLOUD）。MCU运行正常、空闲下端0%、行程202363/manual3/saved1保持，UART错误/溢出/TX错误均0，控制及百分比接收计数均0。当前产品运动接收条件要求状态4，因此尚不能确认App云端控制可验收；STOP仍可接受。已询问App设备在线/离线状态以继续判断，不复位、不配网、不更改联网门槛或固件。

证据：重新配网后（历史附件未随公开候选提供）、再次核对（历史附件未随公开候选提供）。

用户反馈App显示在线后，MCU只读复查仍为wifi3、控制/百分比接收0、拒绝0；请求对照一次App“停止”和37%操作，用户决定再配一次网，未执行该次操作。固件及状态4接收门槛保持原值。

再次配网的只读观察实际捕获wifi3→4，状态4持续至少4秒，link_fault0、UART错误/溢出/TX错误0、控制/百分比接收0。已确认涂鸦云连接恢复，已通知用户测试开/途中停/关以及37%/62%，实际运动与App回报验收等待用户反馈。此次仅SWD attach读取，没有复位、烧录、配网命令或工具发起运动。

证据：App在线时MCU复查（历史附件未随公开候选提供）、再次配网状态变化（历史附件未随公开候选提供）、只读观察JSONL（历史附件未随公开候选提供）。

用户随后确认App开关和停止正常，61%确实开到约61%、27%也能降到约27%。剩余问题为进度显示直接显示目标0/100，缺少中间值，面板进度和设置共用滑条。只读现场wifi4，控制接收5、百分比接收/接受2/2、最后27、拒绝0；最新上下全程均result6，range202363/manual3/saved1，UART/存储错误0。用户的机械定位验收通过，显示修正另见[v12](2026-10-25-product-v12.md)。本次状态（历史附件未随公开候选提供）。
