XJH-Jorhai/automatic-curtain-lifter/hardware/test-records/2026-10-25-product-v9.md

# 2026-10-25 产品 v9：已确认方向、恢复EEPROM保存

用户在v8真实上下端验证后明确选择“采用已确认方向，恢复产品模式和 EEPROM 保存”。本版采用本机DIR0上卷、DIR1下放，不再执行双向失步试探；首次本地触点定义为上。360 rpm、原约1.50 A、5点中位数/max(64,基线50%)/80 ms及B1沿用v8实测工况。

首次上触点通过30 ms消抖后，在电机禁能时保存方向和触点，回读成功后才运行；失败停止，无自动重试。首次端点和有效行程按事件保存。LW v7忽略旧实验记录及与DIR0冲突的记录；启动不擦除/写入，音乐槽不变。App控制恢复，未定义触点前拒绝远程运动；中间百分比还需行程和本次上电位置均可信。

v8的250585微步只在RAM和日志，不硬编码或预置EEPROM。用户需在产品版再完成上下端学习；保存后重启保留方向、触点及行程，当前位置需真实端点重新对齐。

主机全部回归通过。当前产品新增无试探、先保存后运动、上下全电流、滤波端点/三次事件保存、v7及旧/冲突记录拒绝、重启恢复、App37%/STOP/离线、上电按住/松手及写失败重试。历史探测测试显式编译LIFT_CONFIRMED_DIRECTION=0。新增模拟测试最初遗漏SDK初始化导致接收状态无效，补入与固件启动相同的bridge_init后通过；真实启动一直具有此调用。

Product构建通过，BIN28612字节、RAM5552字节，SHA256 `6b6f958cc96278049521168c7e64e53241408767ecc0f149088165c7a0801a9d`；冻结于work/releases/2026-10-25-product-v9。ELF有行程专用写入函数，音乐保存、bench及测试注入未链接，运动结构112字节。

沿规定浮条入口、50 kHz SWD/4字块完成烧录，全量28612字节读回SHA256一致，选项字0xDFFFE1AA不变，复位运行和会话清理通过。只读启动检查CPU运行、GPIO禁能休眠、B1完成3340脉冲/净偏移0、UART错误0；EEPROM读取4、写0，2秒闲置无访问；M为map0/mode1/saved0/capture0。

证据：构建（历史附件未随公开候选提供）、主机回归（历史附件未随公开候选提供）、烧录（历史附件未随公开候选提供）、启动（历史附件未随公开候选提供）。已请用户完成首次上卷到顶、下放到底，随后核对实板EEPROM保存；当前尚未将主机保存测试当作实片已保存。

## 实板学习与EEPROM核验完成

用户确认“两端都自动停止，已完成”。立即只读提取，UP快照generation20、DOWN快照generation30，均result2/error0；当前为下端、position239993、range239993、known1/1、ends1/1、percent0、saved1、capture0。DIR0上卷，up_key2即PC7为上；UART和存储错误均0。最后下行是从origin205884续行34109指令步数到端点，证明本次结果包含中间续行，不是对两条连续全程动作的假定。

缓存的最新日志序号3、flags30、slot1、travel239993。当前这次上电的保存计数及EEPROM attempts/writes均2，不把它当成自烧录以来的累计次数；最新seq3与当前启动计数应分别解释。已完成保存返回成功且saved1，意味着行程专用接口已写入并回读校验。实板结果不沿用此前采样版250585，而是本版重新学习出的指令步数估计。

保存原始采样后，使用 `work/verify_product_persistence.py --reset` 在CPU运行、应用空闲无错误、物理两触点松开、ENABLE和STEP低的条件下，仅软件复位，无擦写Flash、无EEPROM命令、无升降请求；正常开机旋律随复位重放一次。

复位后从真实EEPROM加载并核对：DIR0、PC7上触点、上下端标志、239993行程、序号3、flags30、slot1均与复位前一致，saved_valid1。CPU运行、GPIO禁能休眠、UART错误0，B1完成3340脉冲/净偏移0。启动EEPROM reads4、attempts0、writes0，额外2秒闲置各计数不变，无自动运动或音乐重播。该验证是MCU软件复位，未声称外部断电重上电实测。

重启后range_known1但position_known0，显示50%、等待真实端点重新对齐；这是预期行为，不丢失已保存行程。本轮用户选择的已确认方向产品流程、端点学习、实片保存及软件重启恢复已完成验证。

证据：学习后状态（历史附件未随公开候选提供）、端点波形（历史附件未随公开候选提供）、波形摘要（历史附件未随公开候选提供）、复位核验日志（历史附件未随公开候选提供）、复位前后数据（历史附件未随公开候选提供）。
