XJH-Jorhai/automatic-curtain-lifter/hardware/test-records/2026-10-25-product-v10.md

# 2026-10-25 产品v10：手动校准与端点步数停止

用户反馈下端反卷不一定失步，要求复用配网键短按校准：采用按钮之前最后的本地钮子方向，上记上、下记下；若距相反已知端点严格小于三圈则改记相反端点，两端对称。长按配网保留。用户还要求本次代码完成之后调研涂鸦App/MQTT如何修改，本轮先不改云端。

改动前只读现场仍有range239993、saved1、map2、ends1/1； EEPROM记录未丢，主因旧版全开/全关未按range限步而总等失步。前轮成功不能证明每次反卷都有稳定失步，改为人工校准作为可主动确定下端的方法。改动前状态（历史附件未随公开候选提供）。

## 实现

- PC13原始按下先禁能，冻结按下前本地输入和最终脉冲；30 ms消抖，短按松开提交，5秒长按仅配网。App不会改变最后本地方向，启动未有钮子输入时拒绝校准；按键开机已按住及抖动不产生校准事件。
- 近端修正严格 `<4800` 微步；未知位置不猜距离。手动端点更新有效跨度，校验1600–300000微步，保存两槽CRC/序号日志，来源位为TOP1/BOTTOM2。
- 可信相对位置可直接按保存的端点限步；首次重启未对齐时保留自动失步/手动建立基准。旧边界前异常失步不覆盖端点，保留一次首次低值处相对参考供手动校准，再次运动时丢弃。0/100百分比只在可信边界结束时回报。
- 已到边界时，本地回中位后同向再拨为最大4799微步微调；松手停止、结束不自动改端点，短按后才保存。遥控不使用这种越界微调。
- LW v8增加手动来源位，兼容v7读取；迁移不在启动写入。8次保存尝试/上电、无后台扫描及写入策略不变，音乐槽不变。
- 仍为DIR0上卷、360 rpm/约1.50 A、5点中位数/50%基线/80 ms及原B1，未改涂鸦DP协议。

## 验证

完整主机回归通过，新增实际产品/驱动/SDK流程测试：旧v7加载零写、无前置输入拒绝、运动中按钮按下即时停、手动上下端写v8及重启来源恢复、按住钮子校准后不自启、正常ADC从不失步时两端仍按真实驱动脉冲截止、4799微调、长按只配网和启动按住抑制。纯状态回归覆盖三圈4799/4800两向边界、未知位置回退、非法跨度拒绝、旧边界前失步后仍可手动修正跨度，以及tick回绕。

旧测试模拟GPIO曾只初始化PC6/PC7，新增PC13后相当于配网键被按住，已统一明确初始化松开电平。新增未知位置测试也明确anchor=NONE，对应实际重启；这两项测试夹具修正后全部通过。

Product编译通过，最终BIN30064字节、RAM5560字节；SHA256 `f39e94812fc677cd176786d7de257f5a4d2a568906e7589a8e3c06e012daef37`，冻结于work/releases/2026-10-25-product-v10b。ELF有手动校准、按钮状态机和专用EEPROM写入口，无bench/音乐保存/测试注入；运动结构仍112字节，新来源/jog字段使用原填充字节。

首个v10检查点已通过完整30052字节读回并复位。为回应用户“不知道停机是否来自记忆端点”，最终v10b另增加result6明确区分按步数到点与result2失步停止，主机回归证明正常ADC不失步时两端都得到result6；操作行为一致，检查点文件保留。

最终v10b已沿规定浮条入口完成烧录，SWD50 kHz、4字块；完整30064字节读回、SHA256、选项字0xDFFFE1AA、复位和会话清理通过。启动保留旧239993微步行程、map2和两个端点，启动无EEPROM写入，B1完成3340脉冲、净偏移0。

用户随后完成实物校准，确认“校准后可以正常到校准点停止”；之前“操作中出现异常”为误回复，已由用户更正，不作为缺陷。只读核对：行程196823微步、manual3、map2、saved1、LW8序号6/槽0/flags126；本次启动3次保存、0存储错误，保留的上下快照均为result6按步数到点。没有为核验主动运动或复位。原定云端修改调研已按用户最新指示暂停，继续实现v11操作与App功能。

证据：校准后状态及快照（历史附件未随公开候选提供）、日志核对（历史附件未随公开候选提供）。

日志：最终构建（历史附件未随公开候选提供）、主机回归（历史附件未随公开候选提供）、检查点烧录（历史附件未随公开候选提供）、最终烧录（历史附件未随公开候选提供）。
