XJH-Jorhai/automatic-curtain-lifter/hardware/test-records/2026-10-25-product-v12.md

# 2026-10-25 产品v12：共用百分比滑条显示当前位置

用户实物确认v11 App开关/停止正常，61%与27%实际定位接近目标，但显示直接跳0/100、没有中间进度；进度显示和设定使用同一滑条。当前只修固件回报方式，不开展此前暂停的云平台改造调研，不更改PID、DP定义或面板。

## 依据与修改

只读保留v11现场：模组wifi4，控制接收5、百分比接收/接受2/2、最后目标27、拒绝0；行程202363/manual3/saved1，存储及UART错误0，最近上下均按计数端点停止。状态及快照（历史附件未随公开候选提供）。

v11桥接层在DP2上传目标，在DP101上传进度；因此打开/关闭DP2一直为100/0，与用户描述的共用滑条现象一致。v12中DP2下发仍设置内部目标，但DP2上报改用当前位置，与DP101读取同一份快照；规划目标保留在Product_Target中，运动过程不受显示更新覆盖。原500 ms进度限频、状态/目标变化与结束时及时报告保留。

原SDK的mcu_dp_value_update只构造发送方向命令0x07；运动命令来自接收方向0x06。上报不调用Product_Request，也不增加百分比接收计数。App面板收到状态后是否正常实时显示，仍需实物验收，不用主机测试替代。

钮子1秒自动与反向逻辑、360 rpm/约1.50 A、端点/百分比规划、TRQ滤波、原B1及LW8保存机制不变。烧录前核对电机空闲、钮子松开，保存行程202363、LW8序号7/槽1/flags126；零错误。烧录前核对（历史附件未随公开候选提供）。

## 验证与镜像

完整主机回归通过。新增真实SDK/产品/电机驱动测试：61→27→61单调进度、DP2/101均为当前值、499/500 ms门槛、停机最终值即时同步、打开关闭产生中间值，连续上报不改变内部目标/运动代次/脉冲数，也不增加命令接收数。重启找顶期间DP2/101均为当前参考进度而非未执行目标。原钮子、手动校准、EEPROM和TRQ波形回归均通过。

Product Release构建BIN31184字节、RAM5600/8192；SHA256 `2ec80dc6b459a4cd319cb641f68c43f6a7ad45f8723bc942c0dfc9fd79a97e31`，冻结于work/releases/2026-10-25-product-v12。ELF审查确认产品/校准/DP路径存在、无bench注入/通用EEPROM写/音乐保存入口，LiftMotion仍112字节。

日志：主机回归（历史附件未随公开候选提供）、构建（历史附件未随公开候选提供）。

## 部署与验收

使用规定flash_bounded入口烧录完成，浮条session5d979645fd9046fab7c11cb4ba95d177，SWD50 kHz/4字块。完整31184字节读回与SHA256一致，选项字0xDFFFE1AA保持，复位与会话清理通过。烧录（历史附件未随公开候选提供）。

启动只读核验通过：CPU运行、空闲无故障、EN0/SLEEP0；行程202363/manual3/PC7为上/两端标志/LW8序号7槽1flags126均恢复。启动读取4次、保存/尝试/写入和错误均0；原B1完成3340脉冲、净偏移0。模组wifi4、UART/溢出/TX错误0，目标/运动指令初始均0。启动（历史附件未随公开候选提供）、日志恢复（历史附件未随公开候选提供）。

用户已回复“进度跟随且定位正常”，修正版实际App滑条与定位验收通过。结合此前已通过的钮子和App开停关，本轮两项功能验收完成。工具未主动发起运动或校准。

120秒只读观察自动结束，该窗口内尚未收到App运动指令，仅记录cloud4和空闲进度50，不能当作实际运动曲线证据。用户随后完成操作并确认面板效果。初始观察（历史附件未随公开候选提供）。

验收后只读核对：CPU运行，phase0/error0、owner0、EN0；位置202363为下端0%，目标0、已报告进度0/目标缓存0；range202363/known1/1/manual3/saved1。模组wifi4，控制接收1，百分比接收/接受3/3、最后0，拒绝0，UART错误/溢出/TX错误均0。EEPROM日志读取2次、保存0次、错误0，校准沿用原记录，App运动没有新增保存。最新工作快照result6按脉冲到端点，home0/auto0/reverse0。此次不复位、不烧录、不运动。验收后状态（历史附件未随公开候选提供）。
