XJH-Jorhai/automatic-curtain-lifter/hardware/test-records/2026-10-25-product-v13.md

# 2026-10-25 产品v13：新涂鸦面板与App端点校准

用户已上线新面板，要求修改STM32后实测。102 `cali_upper_end`、103 `cali_down_end`已改为Bool，并在本轮明确确认传输类型为rw。原SDK快照只含1/2/101，本次在受控移植脚本中补齐Product专用表/分发，冻结原始下载物不修改；新的云端导出材料尚未归档。

## 行为

- DP2上下行均为接受的目标，DP101为独立实际/估算进度；STOP保留最后目标，实际进度停在当前位置。启动未接受操作时目标50，既不运动也不写EEPROM。实体操作/明确校准可把目标设为对应0/100。
- 102/103发送true分别将当前位置记为上/下端，先停止并冻结最终指令步数，清除钮子自动、延迟换向和找顶后续目标。App明确指定的端点不使用实体配网键的三圈内反向修正；实体原规则保留。
- 沿用LW8双槽、CRC、差异比较、禁能写入/回读及每次上电8次尝试上限。相同记录无EEPROM访问，存储失败停止且不自动重试，下一次明确操作可重试。跨度仍需1600–300000微步。
- 处理结束将按钮复位false，查询也上报false，false下发不运动、不校准。false复位不是EEPROM成功回执，面板不能据此宣称持久保存成功。常规500ms进度报告不反复发送按钮复位。
- 上触点未定义、独立采样构建、离线、配网键占用、上下冲突或驱动故障时拒绝云端校准。按住单侧时校准会消费输入，回中位才可重新拨动。
- 360 rpm/约1.50 A、5点中位数/50%门槛/80ms失步确认、原B1、实体配网键和钮子1秒逻辑保持。

## 软件验证

完整主机回归通过，使用真实SDK/产品运行层/电机驱动及RAM模拟硬件。覆盖DP2固定目标、DP101单调进度、499/500ms门槛、STOP保留目标、61→27→61、上报不产生运动请求；新增Bool帧类型/长度/值、false/查询无副作用、无本地方向历史也可明确校准、近相反端不翻转、最终脉冲冻结、EEPROM保存、相同记录无访问、按住钮子消费、离线/配网键互锁、重启恢复、校准取消找顶、写入失败/按钮复位/无自动重试/明确重试。

原实体校准、4799/4800严格边界、钮子、保护、原B1、EEPROM次数限制/撕裂写、保留实测TRQ回放均通过。独立采样构建仍拒绝云端校准且不写EEPROM。旧TuyaApp也编译通过，不启用Product新增指令。

Product Release：BIN31780字节，RAM5608/8192；SHA256 `2cb6ff06aa9e51152a76cf451de05e924d206962a22809a7e878604922d56e4d`。冻结于 `work/releases/2026-10-25-product-v13/`，manifest.json记录镜像和相关源码散列。ELF审查通过：显式校准/真实保存路径存在，无bench、通用EEPROM写及音乐保存入口，LiftMotion112字节。

日志：回归（历史附件未随公开候选提供）、构建（历史附件未随公开候选提供）、TuyaApp构建（历史附件未随公开候选提供）。

## 部署

烧录前只读确认：CPU运行，电机空闲、触点松开，正常USER_STOP状态；LW8序号7/槽1/flags126、PC7上、行程202363微步、manual3，存储/通信错误0。保存基线见日志快照（历史附件未随公开候选提供）。只读核验脚本允许正常USER_STOP=1，同时增加配网键、待处理输入和参考流程的空闲校验。

规定flash_bounded入口烧录完成，浮条session `90e2e45fc65f4a6c90830c3129e92e46`，50kHz/4字块，耗时95.063秒；31780字节完整读回及SHA256一致，选项字0xDFFFE1AA保持，复位和会话清理通过，浮条自动退出。烧录日志（历史附件未随公开候选提供）。

启动只读核验通过：CPU运行，phase0/error0、EN0/SLEEP0，原LW8序号7/槽1/flags126/PC7上/202363微步/manual3恢复；读取4次、写入/尝试/存储及通信错误0，B1完成3340脉冲/净偏移0。重启后位置未知、DP2/101初始均50，没有自动运动或校准；模组状态4云端在线，App命令及校准接收计数均0。启动快照（历史附件未随公开候选提供）、保存记录（历史附件未随公开候选提供）。

启动核验后分两阶段请用户验收目标/进度与定位/停止，再验收端点按钮。以下记录用户反馈与实板证据，工具未下发运动或校准命令。

第一阶段用户已回复“目标与进度独立，定位及停止正常”。实板只读采样捕获目标100时进度81→86→92→97→99→100；目标56时99→91→82→70→61→56；目标26时56→46→34→26；目标0时23→11→0。此轮实际收到56/26，未把预定61/27写成实测目标。目标分别保持不变，命令4/4接受、拒绝0、云端4及通信错误0。途中STOP由用户确认，采样窗口未捕获单独DP1 STOP。见只读记录（历史附件未随公开候选提供）。

第二阶段用户已回复“两端保存和自动停位均正常”。首段采样记录下发103、结果2/保存成功1次；后续记录下发102、结果1/累计保存成功2次。校准后App关闭和打开均有独立目标0/100与进度变化，到点停止，未新增拒绝或通信错误。后续只读采样（历史附件未随公开候选提供）。

串口仅发M查询核对：phase0/busy0/error0，当前位置上端100%、目标100、pos0，行程126113微步/known1/1/manual3/saved1，PC7为上，ee2/2/0。两个事件确实各提交一次EEPROM，当前状态匹配已回读验证的记录；最新上下快照均result6按脉冲到点，工作段126113脉冲。home0/auto0/reverse0，无后续动作。见验收后串口（历史附件未随公开候选提供）。

两段只读采样均已正常结束并释放探针。最终核对LW8序号9/槽1/flags126、行程126113微步、manual3；较烧录前序号7增加两个事件，attempts2/writes2/reads8/read_errors0，storage_saves2/storage_errors0，状态匹配已回读校验记录。两个云端校准命令2/2成功，百分比6/6接受，拒绝0，模组云端4，UART/溢出/TX错误均0；上下自动端点快照均result6/error0。CPU运行、选项字0xDFFFE1AA保持，停在上端100%，EN0，无待处理换向/参考/输入。见最终日志（历史附件未随公开候选提供）、最终状态（历史附件未随公开候选提供）、端点快照（历史附件未随公开候选提供）。

本轮两项功能实物验收已通过，镜像manifest已补记部署及验收结果。本轮没有在新校准后主动复位测试；启动恢复原记录有实板证据，新校准的重启恢复另有主机回归，未混称为新行程断电实测。没有后台任务继续占用串口或探针。
