XJH-Jorhai/automatic-curtain-lifter/hardware/test-records/2026-10-25-product-v14.md

# 2026-10-25 产品v14：中间校准点重启定位与按钮自动复位

用户要求再重启核对App校准的端点/行程，测试重启百分比定位，并让校准按钮自行上报松开。用户进一步确认：上次保存的上端为选定的中间位置，必须保留该校准点。

## 重启核验与发现

按用户要求先对已部署v13作空闲软件复位：LW8序号9/槽1/flags126、上下手动标志3、行程126113微步、PC7上全部恢复；重启读取4次、写入/尝试/错误0，B1完成3340脉冲/净偏移0。重启前后快照（历史附件未随公开候选提供）。

但v13只保存校准跨度，没有保存中间上端距物理顶的偏移；重启后的找顶会把物理顶误作手动上端。两个标志和跨度恢复不等于中间校准点的物理位置恢复。因此本次补齐物理参考映射，再测试百分比定位。用户的旧跨度保留，不凭历史百分比硬编码偏移。

## 实现

- LiftMotion新增物理顶偏移与可信标志；物理顶在手动坐标中为负偏移。找顶后按该坐标回到目标，100%同样返回用户校准上端，不在物理顶提前结束。越过校准上端时进度保持1–99范围，实际到校准端点才报告100/0。
- 在可信坐标中重设上端时，同步平移物理偏移、修正跨度，保持另一端的物理位置。实际物理跨度含偏移不得超过300000微步。
- 旧LW7/LW8手动记录缺少物理偏移，重启后先要求明确当前校准端点；此处用户仍在原校准上端，可再次点保存上端，保留126113跨度。随后首次App定位从该点找物理顶，按首次低TRQ计数计算偏移、禁能保存并回读，再进入目标运动。
- 新LW9仍用0x200/0x210两个16字节槽和CRC32，序号26位、行程19位、物理偏移19位，不增加页写入次数；兼容读取LW7/LW8，空闲/启动不迁移或写入。找顶参考学习完成后才保存LW9。普通定位不新增EEPROM访问。
- 按钮按下发送true确认事件，随后由主循环在300ms回报false，1200ms后再补报一次false。上电/重新联网也主动上报两个false，状态查询仍上报false。延迟报告只改变按钮状态，不重新校准、不重试EEPROM、不发起运动。松开报告不代表保存成功，保存结果仍由诊断核对。
- 速度360rpm、约1.50A、TRQ中位数/门槛/确认时间、原B1及钮子/物理配网键参数不变。

协议依据：[涂鸦Wi-Fi串口协议](https://developer.tuya.com/cn/docs/iot/tuya-cloud-universal-serial-port-access-protocol?id=K9hhi0xxtn9cb)规定通过0x07主动上报变化后的DP状态，并在查询时报告状态。本次300ms/1200ms是产品选择，不是协议规定的延迟；即时false与面板的时序是否有关属于待实测判断，不当作已确认根因。

## 软件验证和镜像

完整主机回归通过，复用真实SDK、产品、运动及电机驱动。新增覆盖中间上端47237微步偏移的保存/重启/回到37%与两个软端点、LW8手动记录不猜物理零点及一次参考迁移、负/越界偏移拒绝、物理顶先于校准顶时向下返回20000步、重设上端保持另一端；按钮300/1200ms边界、计时回绕、断网/重连、查询、重按、没有定时校准/重写/运动。原钮子、物理校准、保护、B1、EEPROM与实测TRQ回放均通过。

Product Release：BIN33000字节、RAM5640/8192；SHA256 `eec19432001d57e7b2d13af38ace2d1a968f3c474db273ae214020b473b0a812`，冻结 `work/releases/2026-10-25-product-v14/`。ELF审查：校准、物理参考及真实保存入口存在，无bench/通用EEPROM写/音乐保存入口，LiftMotion120字节。只读脚本已支持新布局，保留旧镜像读取。

日志：构建（历史附件未随公开候选提供）、完整回归（历史附件未随公开候选提供）、烧录前空闲核验（历史附件未随公开候选提供）。

## 部署与实测

已通过规定flash_bounded浮条入口烧录，session `eac3482452214e29b58ce26ce4c579d2`，耗时100.297秒。33000字节完整读回及SHA256一致，选项字0xDFFFE1AA保持，复位和会话清理通过，浮条已退出。烧录日志（历史附件未随公开候选提供）。

启动核验通过：CPU运行、phase0/error0/EN0/SLEEP0，旧LW8序号9/槽1/flags126/PC7上/126113微步/manual3恢复，ref0/0表示旧记录确实缺少物理参考。读取4次、写入/尝试/错误0，原B1完成3340脉冲/净偏移0。模组状态4云端在线。已请用户保持原校准上端，点一次保存上端并观察按钮复位，再设37%左右完成参考学习。启动状态（历史附件未随公开候选提供）、启动日志（历史附件未随公开候选提供）。

首个观察窗口未收到App命令，末尾模组进入配网1；用户确认重新配网完成，只读捕获1→2→3→4，云端在线恢复。初始观察（历史附件未随公开候选提供）、重连（历史附件未随公开候选提供）。

用户随后确认“按钮自动复位，参考学习及定位正常”。只读核对：DP102接收/保存成功1/1，自动false发送2次、pending0；本次实际目标88%（并非预定37%），定位到pos15133、进度/目标88。物理顶首次低TRQ计数40827，保存偏移40827、跨度仍126113；从物理顶坐标-40827下放55960指令步到pos15133。存储保存1次、错误0，校准成功事件与真实写入计数分开；LW9序号10/槽0/flags126，attempts1/writes1，普通目标未增加保存。现场状态（历史附件未随公开候选提供）、采样（历史附件未随公开候选提供）。

随后再次空闲软件复位，实板核对原LW9序号10/槽0/flags126、两个手动来源、126113跨度、40827偏移及可信标志均恢复，启动读取4次/写入0/错误0、B1完成3340脉冲/净偏移0，空闲无动作。此为新物理偏移的实际重启验证，不是仅检查旧跨度。新参考重启前后（历史附件未随公开候选提供）、重启后状态（历史附件未随公开候选提供）。

云端再次在线后，用户保留校准直接操作，并回复“重启后百分比及原校准端点都正常”。只读记录捕获本次实际目标22%（非预定37%/62%），home1先找物理顶，随后按已恢复的40827偏移进入22%；接着0%及100%均到点停止，目标与进度独立。期间ref保持40827，云端4、拒绝/通信错误0，校准接收0、未重新学习偏移。重启定位观察（历史附件未随公开候选提供）。

用户在反馈后又继续进行了钮子点动、微调和两个App端点校准。两次空闲核验恰逢新运动而拒绝读取最终日志，没有停止或复位设备，也没有放宽健康判据；后续只读观察确认是新操作而非故障。上端重设同步更新偏移，最后保存为LW9序号12/槽0/flags126，跨度199275、偏移2950、manual3，pos199275下端0%、目标0、phase0/error0/EN0。该次上电两次App校准2/2成功，attempts2/writes2/storage_saves2、存储错误0，按钮false发送4次/pending0；这些写入属于后续明确校准，不能写成普通定位产生的周期写入。

最终控制接收7、STOP接受1、百分比2/2接受，拒绝0、UART/溢出/TX错误0，云端4。最近下端快照result6按脉冲停止；上端快照已被后续短点动覆盖为result3，不混称为最新两端完整快照。读取与串口报告一致，校准状态匹配已回读验证记录。见最终状态（历史附件未随公开候选提供）、最终日志（历史附件未随公开候选提供）、最终快照（历史附件未随公开候选提供）。

重启恢复、重启后的原校准范围定位以及按钮自动复位均已由用户实物验收通过。新偏移40827/跨度126113有实际软件重启证据；后续2950/199275另有明确保存/回读核验，本轮没有再对最新微调值追加复位，不混为一次重启验证。所有观察、串口与探针会话均已正常结束。
