XJH-Jorhai/automatic-curtain-lifter/(list of files, drawings)

Other design files:
hardware/release-2026-10-25/curtain-lifter.epro
