XJH-Jorhai/automatic-curtain-lifter/firmware/g030_mainboard/Core/Src/main.c

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
/* Includes ------------------------------------------------------------------*/
#include "main.h"
#include "adc.h"
#include "i2c.h"
#include "tim.h"
#include "usart.h"
#include "gpio.h"

/* USER CODE BEGIN Includes */
#include "serial_bringup.h"
#include "motor.h"
#ifdef TUYA_PROTOCOL_APP
extern void TuyaApp_Run(void) __attribute__((noreturn));
#endif
#ifdef TUYA_PROGRAMMING_BRIDGE
#include "tuya_bridge.h"
#endif

/* USER CODE END Includes */


void SystemClock_Config(void);
/**
  * @brief  The application entry point.
  * @retval int
  */
int main(void)
{

  /* MCU Configuration--------------------------------------------------------*/

  /* Reset of all peripherals, Initializes the Flash interface and the Systick. */
  HAL_Init();

  /* Configure the system clock */
  SystemClock_Config();

  /* USER CODE BEGIN SysInit */
#ifdef TUYA_PROTOCOL_APP
  MX_GPIO_Init();
  TuyaApp_Run();
#endif
#ifdef TUYA_PROGRAMMING_BRIDGE
  MX_GPIO_Init();
  TuyaBridge_Run();
#endif
  /* USER CODE END SysInit */

  /* Initialize all configured peripherals */
  MX_GPIO_Init();
  MX_USART2_UART_Init();
  MX_I2C1_Init();
  MX_ADC1_Init();
  MX_TIM14_Init();
  /* USER CODE BEGIN 2 */
  SerialBringup_Init();

  /* USER CODE END 2 */

  /* Infinite loop */
  /* USER CODE BEGIN WHILE */
  while (1)
  {
    /* USER CODE END WHILE */

    /* USER CODE BEGIN 3 */
    SerialBringup_Poll();
  }
  /* USER CODE END 3 */
}

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
