XJH-Jorhai/automatic-curtain-lifter/firmware/g030_mainboard/Core/Inc/main.h

#define NETCONTROL_BTN_Pin GPIO_PIN_13
#define NETCONTROL_BTN_GPIO_Port GPIOC
#define DRV_TRQ_CNT_Pin GPIO_PIN_0
#define DRV_TRQ_CNT_GPIO_Port GPIOA
#define LOW_CURRENT_SEL_Pin GPIO_PIN_4
#define LOW_CURRENT_SEL_GPIO_Port GPIOA
#define DRV_STEP_Pin GPIO_PIN_6
#define DRV_STEP_GPIO_Port GPIOA
#define DRV_DIR_Pin GPIO_PIN_7
#define DRV_DIR_GPIO_Port GPIOA
#define DRV_ENABLE_Pin GPIO_PIN_0
#define DRV_ENABLE_GPIO_Port GPIOB
#define DRV_NSLEEP_Pin GPIO_PIN_1
#define DRV_NSLEEP_GPIO_Port GPIOB
#define DRV_NFAULT_Pin GPIO_PIN_2
#define DRV_NFAULT_GPIO_Port GPIOB
#define EXT_SENSOR_ADC_Pin GPIO_PIN_10
#define EXT_SENSOR_ADC_GPIO_Port GPIOB
#define EXT_SENSOR_DIG_Pin GPIO_PIN_11
#define EXT_SENSOR_DIG_GPIO_Port GPIOB
#define LED_STATUS_Pin GPIO_PIN_12
#define LED_STATUS_GPIO_Port GPIOB
#define KEY_UP_Pin GPIO_PIN_6
#define KEY_UP_GPIO_Port GPIOC
#define KEY_DOWN_Pin GPIO_PIN_7
#define KEY_DOWN_GPIO_Port GPIOC
