XJH-Jorhai/automatic-curtain-lifter/firmware/g030_mainboard/App/switch_control.h

#pragma once
#include <stdbool.h>
void SwitchControl_Init(void);
void SwitchControl_TickISR(void);
void SwitchControl_Poll(void);
void SwitchControl_Stop(void);
void SwitchControl_Report(char *buffer, unsigned capacity);
bool SwitchControl_SelfTest(void);
