XJH-Jorhai/automatic-curtain-lifter/(commit log)

2026-10-25 Add reviewed mechanical STEP parts and actual print settings
2026-10-25 Complete schematic exports, CAD checks and public development documentation
2026-10-25 Add prototype photo and PCB render with captions and metadata review
