XJH-Jorhai/automatic-curtain-lifter/(notices)

Notices in the files:
firmware/g030_mainboard/Core/Src/usart.c:
Copyright (c) 2026 STMicroelectronics.
All rights reserved.
This software is licensed under terms that can be found in the LICENSE file
